fpga-theremin/sensors/README.md

# sensors
Implementation of Analog Front End for digital theremin sensor
