fpga-theremin/sensors/fpga_sensor/firmware/README.md

FPGA based current sensing theremin sensor - FPGA firmware
==========================================================

* hdl - RTL verilog code
* tb - test code

Firmware Block Diagram - RF part
