fpga-theremin/sensors/fpga_sensor/research/README.md

Some research notes on Theremin Sensor design
=============================================

Phase shift detection
---------------------

NCO (Numerically Controlled Oscillator) inside FPGA generates sine wave DRIVE signal to drive LC tank (converted from digital form to analog by DAC). 

Current flowing through LC tank is being measured by measurement of voltage dropped on R_sense resistor. 
LC current SENSE signal is being converted to digital form by ADC, and going back to FPGA for processing.

When DRIVE signal frequency is matching resonance frequency of LC tank, DRIVE and SENSE signals are in phase (have zero phase shift).
Due to change antenna capacitance C, resonance frequency of LC tank changes by sqrt(C).
When frequency of DRIVE is a bit bigger or lower than LC resonance frequency, phase of SENSE signal gets some offset - coming slightly before or after DRIVE.
When difference of DRIVE frequency from resonance getting bigger, phase shift increases.

When sensor see non-zero phase shift, it should correct DRIVE frequency to return phase shift back to zero - keeping DRIVE frequency as close to LC resonance as possible. 
This behavior is called Phase Locked Loop (in our case - Digital Phase Locked Loop - DPLL).

So, we need to find some method to calculate phase shift between known NCO phase and SENSE signal value from ADC.

To find phase difference between two sine signals of the same frequency we may multiply two sines of frequency f and get sine of doubled frequency 2 * f and constant (DC, zero frequency) component corresponding to sin(shift).

    sin(phase*f) * k * sin(phase*f + shift) = sin(phase * 2 * f) + k * sin(shift)

DC value sin(shift) is scaled by unknown value - amplitude of current sensed by ADC. So, one having k * sin(shift) is not enough to calculate exact phase shift value.

If we multiply signal of unknown phase by two sines shifted by 90 degrees, DC components of two products will give sin(shift) and cos(shift) which can easy be transformed to phsae shift angle by using of atan2(dc_sin,dc_cos).
As well, atan2() is not sensitive to scaling of ADC value, so having different amplitude of sensed signal is not more a stopper for precision phase shift measurement.

    sin(phase*f) * k * sin(phase*f + shift) = sin(phase*2*f) + k * sin(shift)
    cos(phase*f) * k * sin(phase*f + shift) = sin(phase*2*f) + k * cos(shift)

We need some method to filter out double frequency component from results of multiplication and leave only DC part - sin(shift) and cos(shift).

Simple method is to use some lowpass filter. But it adds latency. Let's try to find some way for getting precise phase offset during time shorter than one signal period.

Let's try to simulate quadrature phase detector in spreadsheet.
Put formulas for producing samples for NCO_SIN and NCO_COS signals of amplitude 1.0, and simulated ADC signal (which is the same as NCO COS, but with reduced amplitude 0.8 and shifted by phase offset 

    ADC=NCO_COS(phase-offset)) * 0.8

Then we can multiply NCO SIN and NCO COS by ADC signal - to get SIN_MUL_ADC and COS_MUL_ADC.
Formulas use parameters like phase shift, ADC amplitude, ADC DC offset and Sample Rate to Signal Frequency Rate.

Let's create chart using 21 points with X = cos, Y = sin.
Additionally let's show ADC with a bit different amplitude (0.9 instead of real 0.8) - for visibility.

Phase offset is 0 (ADC signal equals to NCO COS, but with amplitude 0.8).

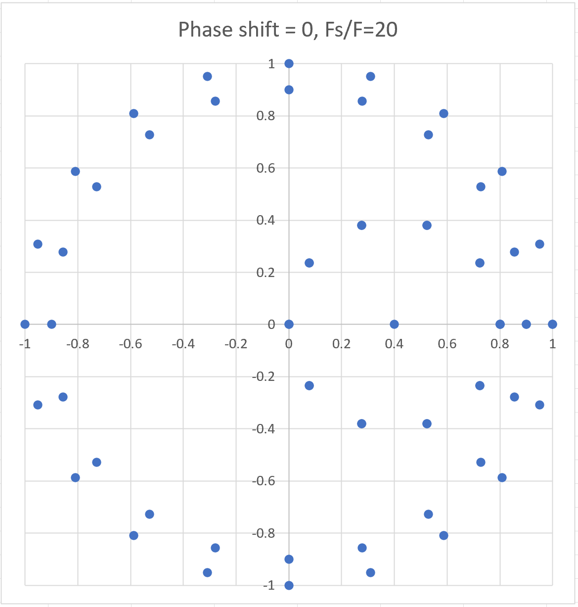
[picture p6: fpga_sensor/images/phase_shift_detection_chart1.png]
Phase shift 0


* Outer circle of radius 1.0 is NCO signal. 
* Smaller circle of radius 0.9 is ADC.
* Small circle of radius 0.4 is ADC multiplied by NCO SIN and COS

Phase offset is 45 degrees.

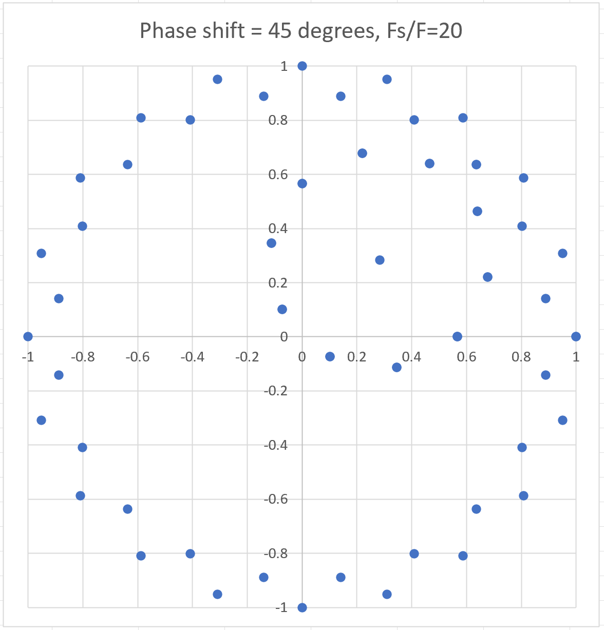
[picture p7: fpga_sensor/images/phase_shift_detection_chart2.png]
Phase shift +45


Phase offset is 120 degrees.

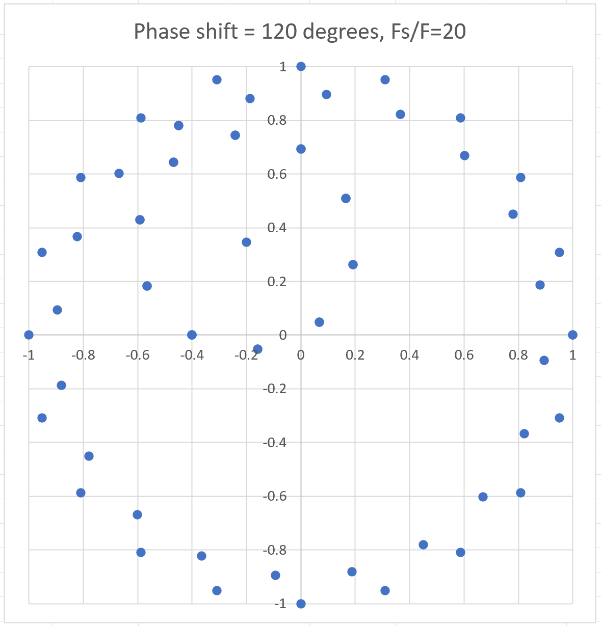
[picture p8: fpga_sensor/images/phase_shift_detection_chart3.png]
Phase shift +120


Phase offset is -30 degrees.

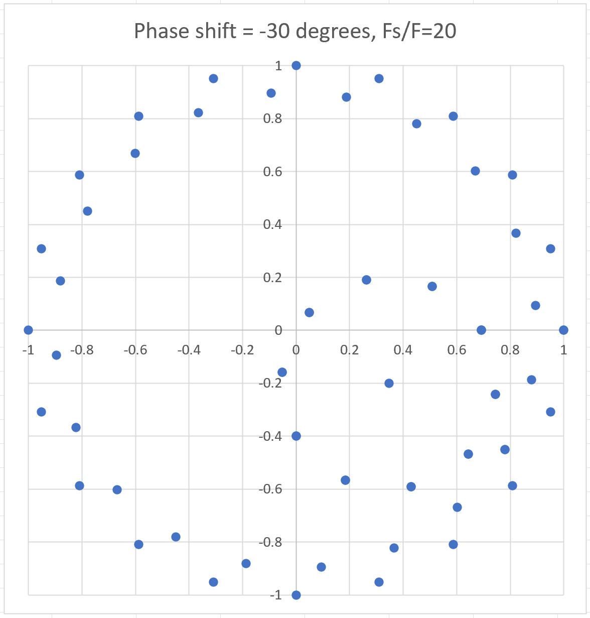
[picture p9: fpga_sensor/images/phase_shift_detection_chart4.png]
Phase shift -30


As we can see, angle between direction from (0,0) to small circle center and X axis equals to phase shift.

Small circle always passes through point (0,0)

If we know circle center coordinates (x,y), we can easy calculate phase shift using atan2:

    phase_shift_angle = atan2(x, y)

Center position of small circle may be obtained by averaging of coordinates of points on circle - LP filtering of them.

Interesting: if there is a DC offset in ADC signal, small circle turns into 2 circles - one smaller, and one bigger. 
Bus still direction to center of both of them corresponds to phase shift.

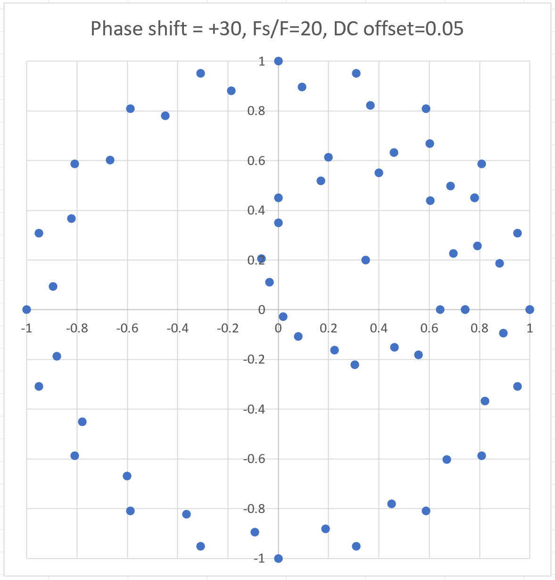
[picture p10: fpga_sensor/images/phase_shift_detection_chart6.png]
DC offset


Why there are only 10 points on small circle, while 20 points on big circle?

Let's increase F_sample/F rate to let points populate less than half of full period.

Now we can see that points on small circle rotate twice faster than on big circle - frequency of NCO * ADC product is 2 times higher than frequency of NCO.

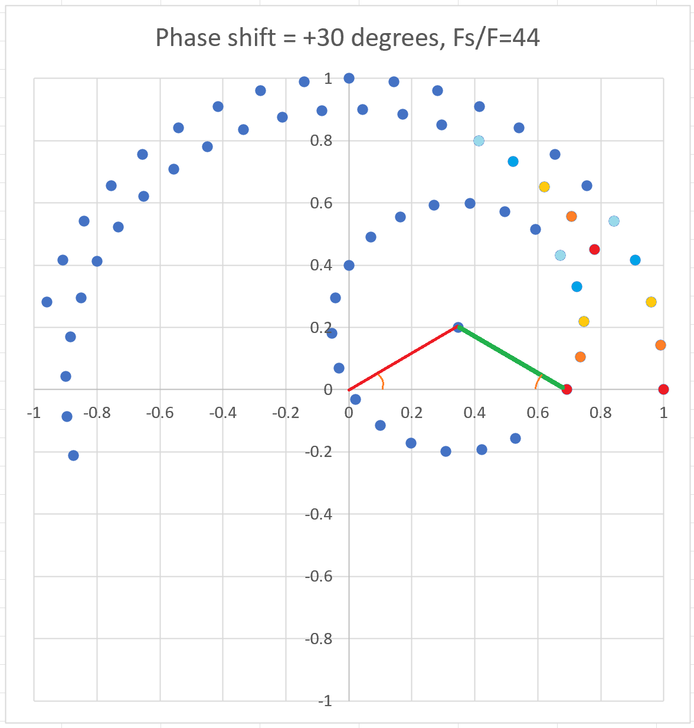
[picture p11: fpga_sensor/images/phase_shift_detection_chart5.png]
Phase shift 30 half of period


Note that direction from (0,0) to small circle center is the same as direction from circle center to zero phase point on this circle, but mirrored over X axis (angle has opposite sign when measure from X axis).

But there is only one such point. Can we calculate direction from (0,0) to small circle center from other points?

We just need to know phase of points on circle - and then from angle from circle center to particular point we can calculate angle to zero phase point just by subtracting of phase.
For each sample, it's easy to get small circle phase (angle between vector pointing from circle center to zero phase point and circle center to particular point on circle) - it's just doubled NCO phase.

For two points on circle we can easy calculate direction to the center of the circle - calculte vector of difference between two points and rotate by 90 degrees.

As phase for two points, average should be used.

To increase precision, it makes sense to use 2 points at some interval - by skipping several points between them to maximize distance.

To get phase shift without LP averaging - only using two samples - in addition to cos_mul_adc and sin_mul_adc values per sample, the only additional thing needed is to have NCO phase per sample.

Angle value from two samples already has only DC component. If ATAN2 is pipelined, it's easy to get angle once per sample, and further averaging should give you a very good performance even if averaged for short interval (even shorter than signal period).

This method should work ok for zero centered ADC output (without DC offset). What happens when we add some DC offset to ADC sine signal?

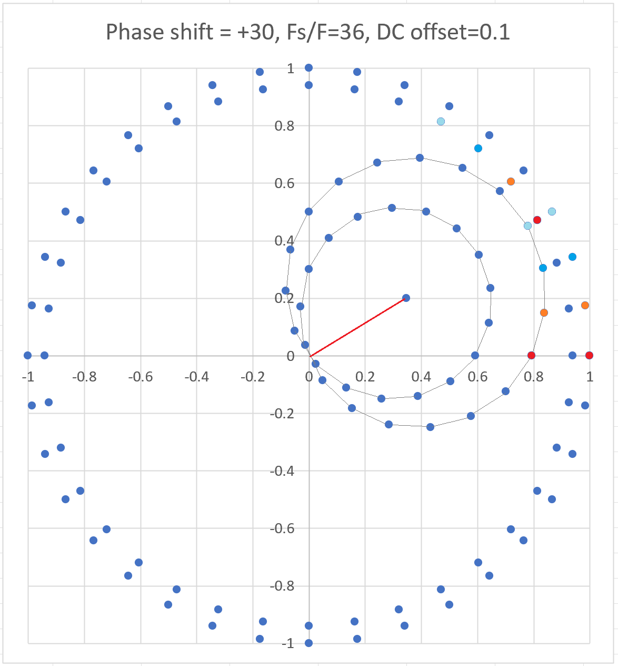
[picture p12: fpga_sensor/images/phase_shift_detection_chart7.png]
Phase shift 30 with DC offset


Let's try to calculate "circle center" for each point on curve considering point is laying on circle.

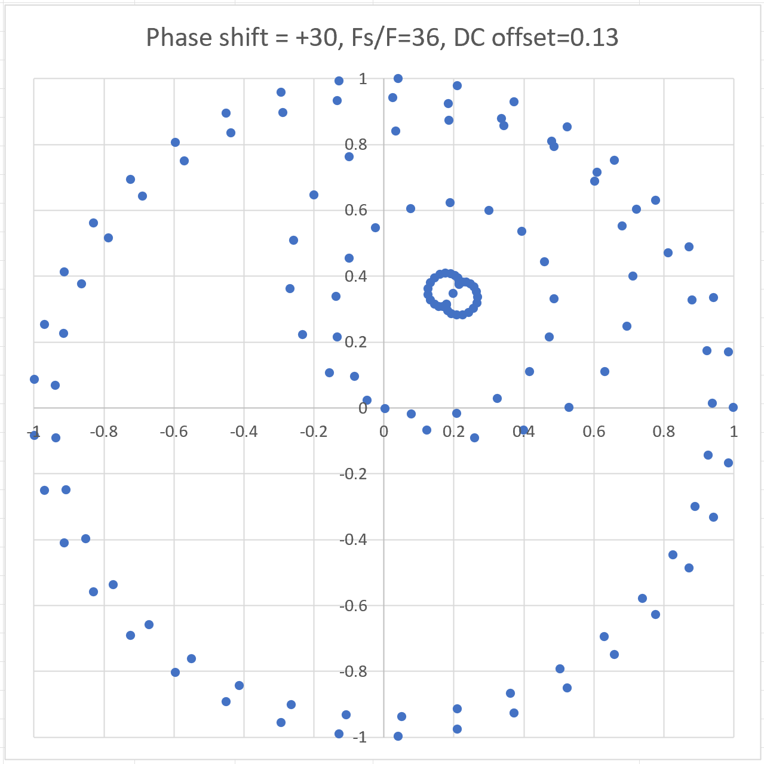
[picture p13: fpga_sensor/images/phase_shift_detection_chart8.png]
Circle center calculations


How angle from (0,0) to calculated "center" of curve changes during period for different DC offset.
(For DC=0 it's horizontal line).

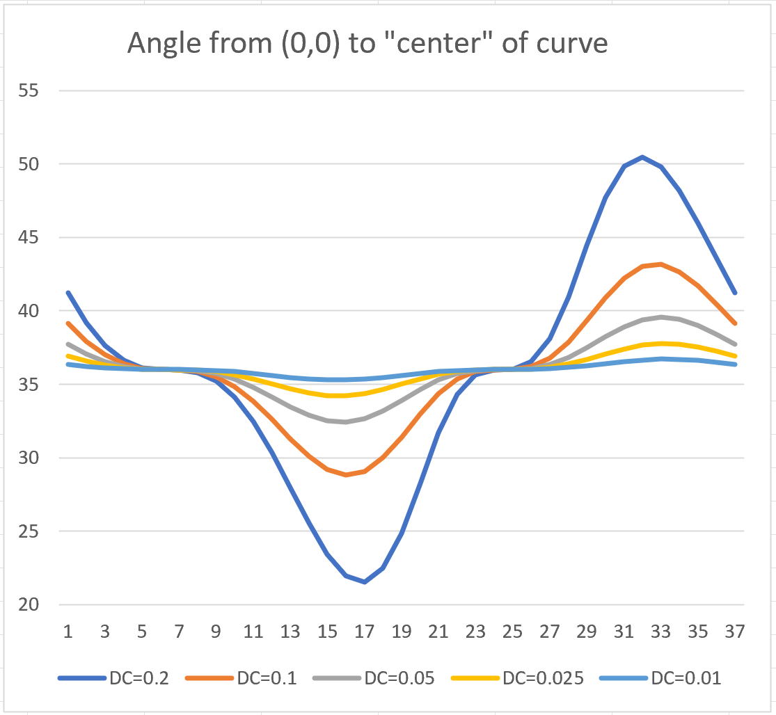
[picture p14: fpga_sensor/images/phase_shift_detection_chart9.png]
Angle to curve "center"


Let's try simplified method of phase shift calculation.
Take 3 points with equal phase step on x=adc*nco_cos, y=adc*nco_sin curve, phase2 is phase for middle point p2:

    pt1=(x1,y1) pt2=(x2,y2) pt3=(x3,y3)
    phase2 = nco_sin and nco_cos phase for point p2

Direction vector v13 from p1 to p3 is (x3-x1), (y3-y1)
Direction from point p2 to curve center vcenter is v13 rotated 90 degrees CCW 

    v13 = (x3-x1), (y3-y1)
    vcenter = ( -(y3-y1), (x3-x1) )

Angle from p2 to curve center can be calculated using atan2()

    acenter = atan2(vcenter.y, vcenter.x) = atan2( (x3-x1), -(y3-y1) )

Correcting acenter angle by doubled NCO phase of point2:

    angle = -(acenter + phase2)

Now we have phase shift angle. Comparison of two methods of angle calculation:

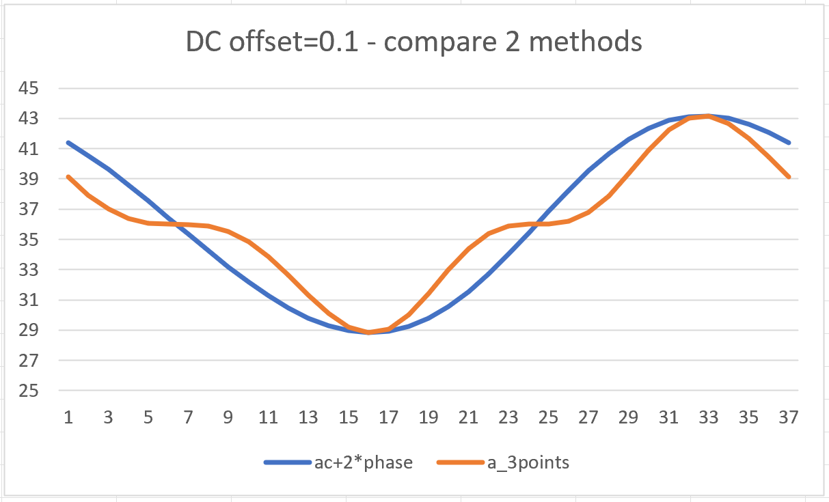
[picture p15: fpga_sensor/images/phase_shift_detection_chart10.png]
Comparision of two methods


Taking angle from direction from single curve point to center and correcting by doubled phase of NCO gives pure sine angle swing.
