fpga-theremin/sensors/models/ltspice/sensors_theory/README.md

Theremin sensors theory
=======================

In theremins, sound is being controlled by distance of hands from two "antennas" (rods or plates of metal).

Antenna is a common naming, but actually, Theremin antenna is working as an electrode of the capacitor. 

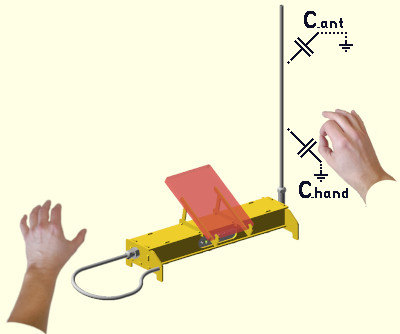
[picture p16: models/ltspice/sensors_theory/images/theremin_antennas_and_hands.jpg]
Theremin antennas and hands


* Pitch antenna controls sound frequency (note).
* Volume antenna controls gain.

Theremin should sense hand to antenna distances, and synthesize output signal of proper pitch and volume.

How can Theremin feel the distance? Distance of hand to antenna changes antenna capacitance.

Capacitance of antenna seen by theremin can be divided into fixed and variable parts.

* C_ant is antenna self capacitance and capacitance from antenna to environment which is considered as non changing

* C_hand is capacitance varying mostly depending on distance from hand to antenna

Typical C_ant value is about 8-10pF, depends on antenna geometry and placement of nearby objects.

Typically, C_hand part of capacitance is about 2pF when hand is close to antenna, and drops by 3.5 .. 4 times for each additional 10cm distance.

Table below shows how antenn capacitance introduced by hand position depends on distance from hand to antenna.

|=====|=====|=====|
|3.5/10cm decay|4/10cm decay|
|L, cm|C_hand, pF|C_hand, pF|
|=====|=====|=====|
|0|2.000000000|2.000000000|
|1|1.764506210|1.741101127|
|2|1.556741083|1.515716567|
|3|1.373439654|1.319507911|
|4|1.211721400|1.148698355|
|5|1.069044968|1.000000000|
|6|0.943168242|0.870550563|
|7|0.832113110|0.757858283|
|8|0.734134375|0.659753955|
|9|0.647692332|0.574349177|
|10|0.571428571|0.500000000|
|11|0.504144632|0.435275282|
|12|0.444783167|0.378929142|
|13|0.392411330|0.329876978|
|14|0.346206114|0.287174589|
|15|0.305441419|0.250000000|
|16|0.269476641|0.217637641|
|17|0.237746603|0.189464571|
|18|0.209752679|0.164938489|
|19|0.185054952|0.143587294|
|20|0.163265306|0.125000000|
|21|0.144041323|0.108818820|
|22|0.127080905|0.094732285|
|23|0.112117523|0.082469244|
|24|0.098916033|0.071793647|
|25|0.087268977|0.062500000|
|26|0.076993326|0.054409410|
|27|0.067927601|0.047366143|
|28|0.059929337|0.041234622|
|29|0.052872843|0.035896824|
|30|0.046647230|0.031250000|
|31|0.041154664|0.027204705|
|32|0.036308830|0.023683071|
|33|0.032033578|0.020617311|
|34|0.028261724|0.017948412|
|35|0.024933993|0.015625000|
|36|0.021998093|0.013602353|
|37|0.019407886|0.011841536|
|38|0.017122668|0.010308656|
|39|0.015106527|0.008974206|
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
