fpga-theremin/sensors/models/ltspice/vco_bjt/README.md

Wide frequency range Sine Outout VCO built mostly on BJTs
=========================================================

- Stable amplitude for wide range of output frequencies (100KHz .. 2MHz)

- Pure sine waveform output

- 4.5V power supply

LTSpice model: [vco_sine_bjt_v04.asc](vco_sine_bjt__v04.asc)
Spice model

Simulation, VCO output for frequency sweeping in full range: Simulation results
