fpga-theremin/sensors/models/ltspice/current_sensing_oscillator/README.md

Current Sensing LC Oscillator for Digital Theremin
==================================================

- Current sensing (Wallin) oscillator on 4-BJT dual current mirrors current sensor and unbuffered invertors
- Square 3.3V 50% duty cycle output for measuring of the frequency
- Antenna viltage swing 300 - 1000 Vpp depending on inductor parameters when powered from 3.3V

LTSpice model: [curr_sens_osc_v01.asc](curr_sens_osc_v01.asc)
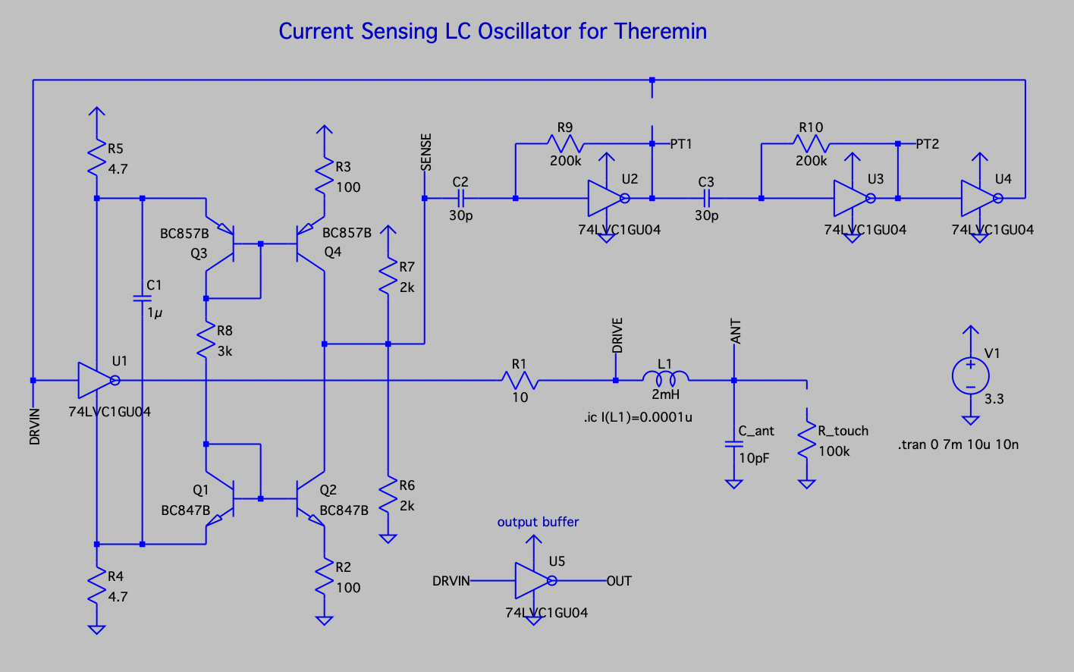
[picture p51: models/ltspice/current_sensing_oscillator/images/osc_v01_ltspice_model.png]
Spice model


* LC tank is fed by single unbuffered inverter
* Drive inverter has sensing resistors on both power supply rails
* Dual current mirror (4 BJTs) senses drive current
* R6, R7, R8 selected to have SENSE signal sine waveform amplitude below the power rails (1/2 or 1/3 of 3.3V)
* Three stages of unbuffered inverters amplify, shaping, and invert sensed signal
* Additional buffer for oscillator output, to avoid influence of long oscillator-to-MCU line

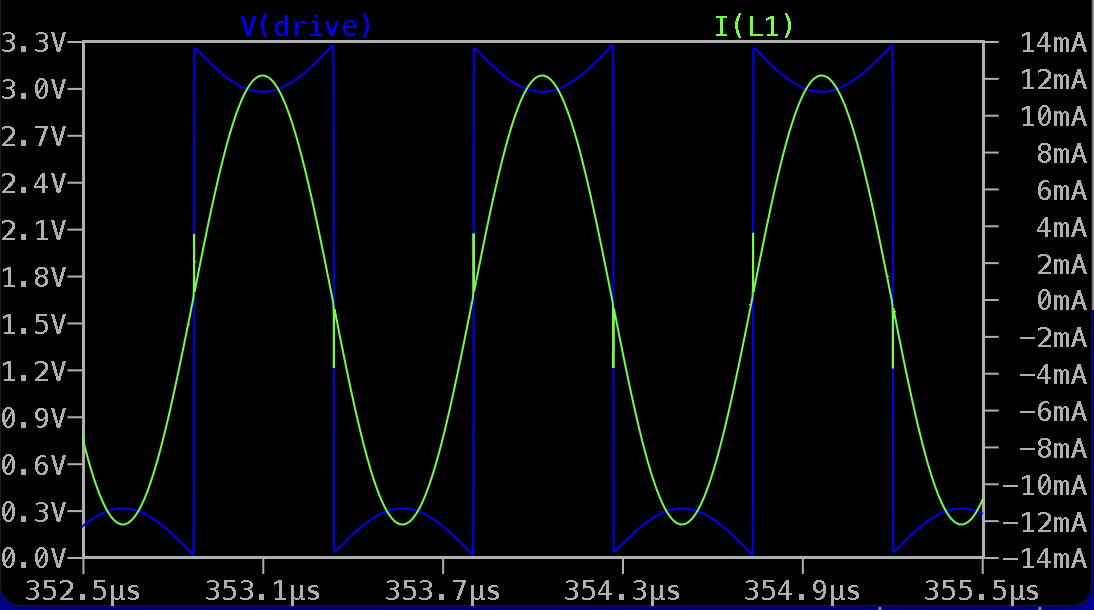
[picture p52: models/ltspice/current_sensing_oscillator/images/osc_v01_sim_drive_voltage_and_current.png]
Simulation, drive voltage waveform and inductor current: 

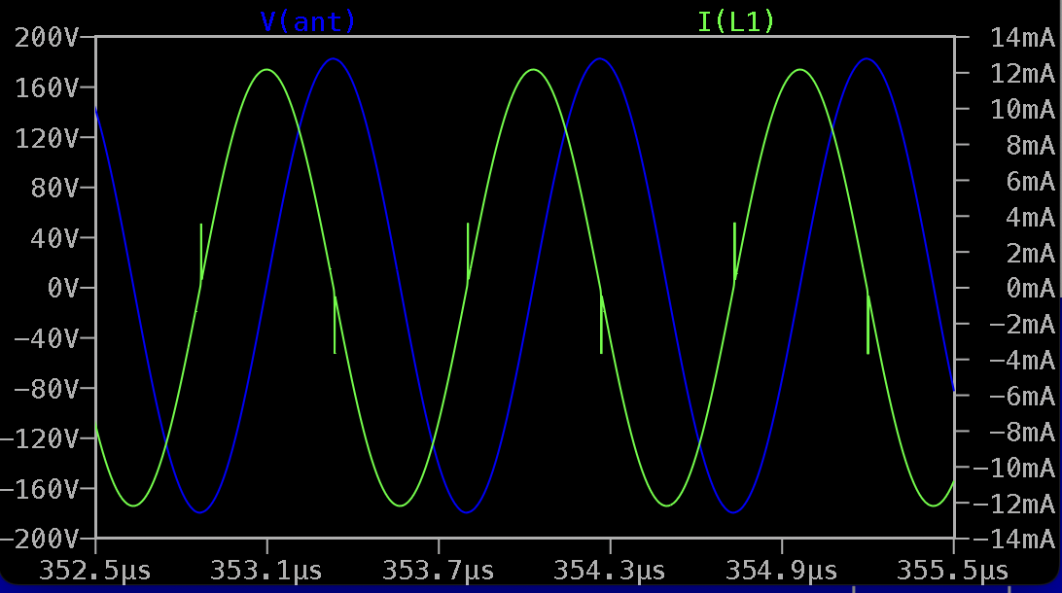
[picture p53: models/ltspice/current_sensing_oscillator/images/osc_v01_sim_ind_current_ant_voltage.png]
Simulation, inductor current and antenna voltage swing: 

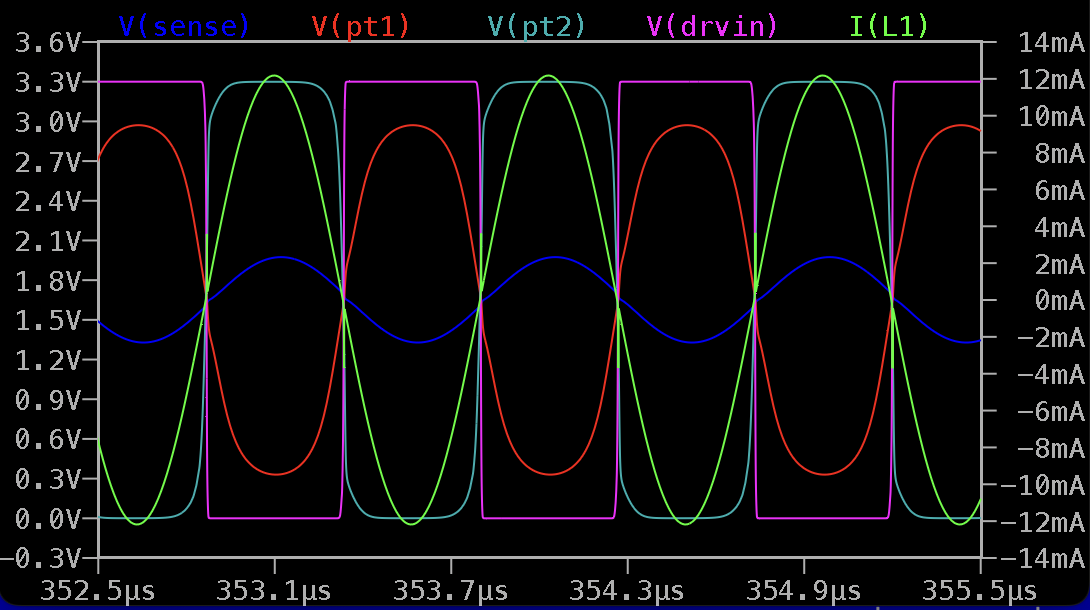
[picture p54: models/ltspice/current_sensing_oscillator/images/osc_v01_sim_current_sensing_amp.png]
Simulation, current sensing amplification stages:
