fpga-theremin/sensors/models/ltspice/vco_and_lc_drive/README.md

Wide frequency range Sine Outout VCO built mostly on BJTs with LC Tank Drive Buffer
===================================================================================

- Stable amplitude for wide range of output frequencies (100KHz .. 2MHz)

- Pure sine waveform output (40dB harmonics)

- 4.5V power supply

LTSpice model: [vco_and_lc_drive_v01.asc](vco_and_lc_drive_v01.asc)
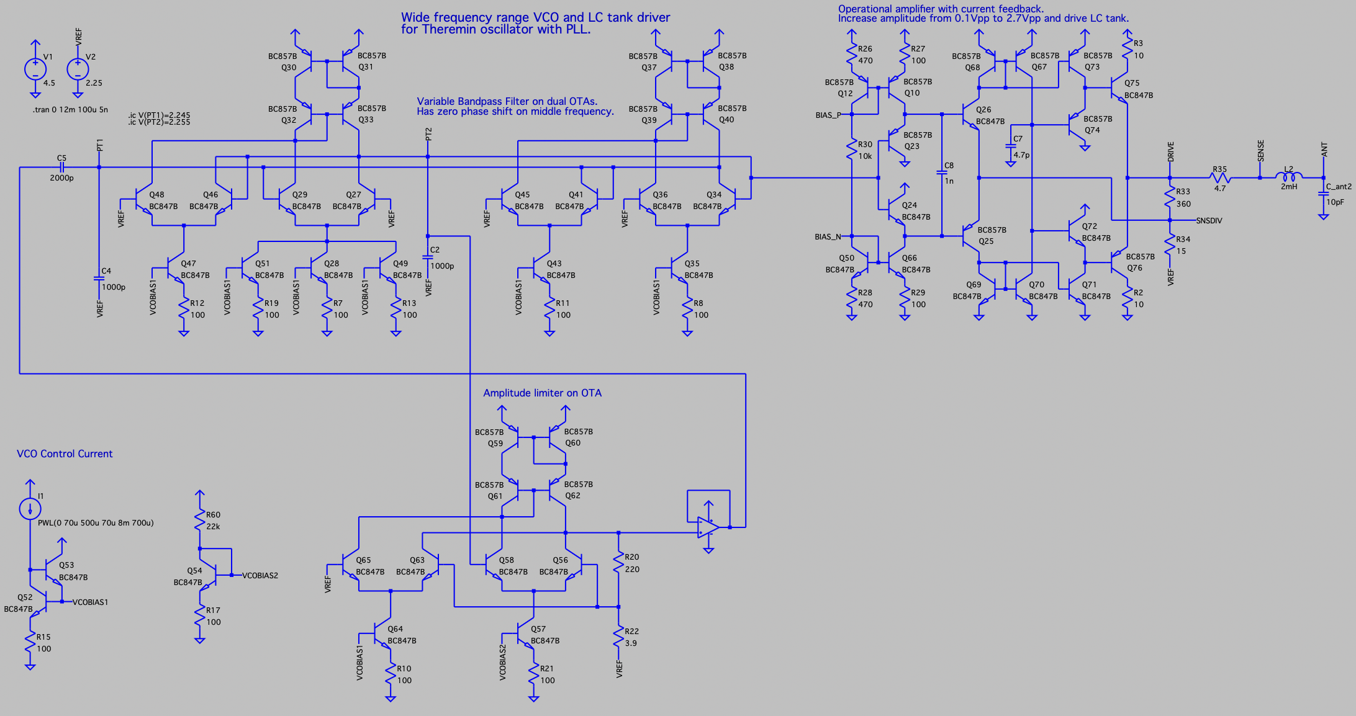
[picture p61: models/ltspice/vco_and_lc_drive/images/vco_and_drive_ltspice_model.png]
Spice model


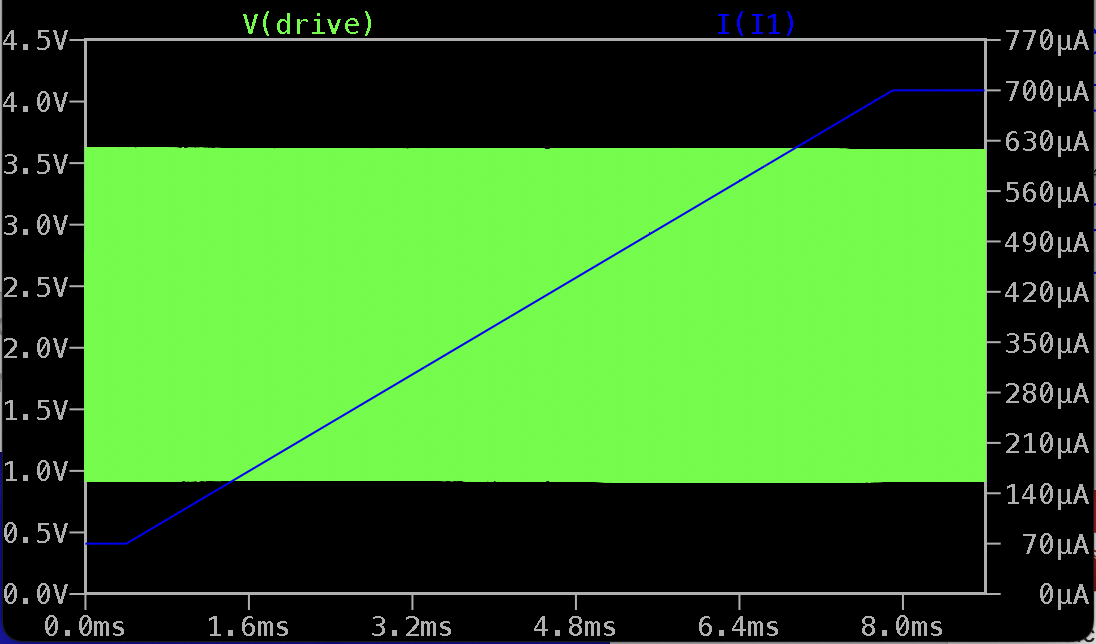
[picture p62: models/ltspice/vco_and_lc_drive/images/vco_drive_output_sim_result_waveform.png]
Simulation results
Simulation, VCO output for frequency sweeping in full range: 

Current sensing LC oscillator with PLL on BJTs for Theremins v2
===============================================================

* VCO and drive buffer - from previous step
* Current sensing via sensing resistor and current feedback opamp (made of BJT)
* Using integrator to shift drive signal by 90 degrees
* Using analog multiplier as phase detector

LTSpice model: [vco_and_lc_drive_v02.asc](vco_and_lc_drive_v02.asc)
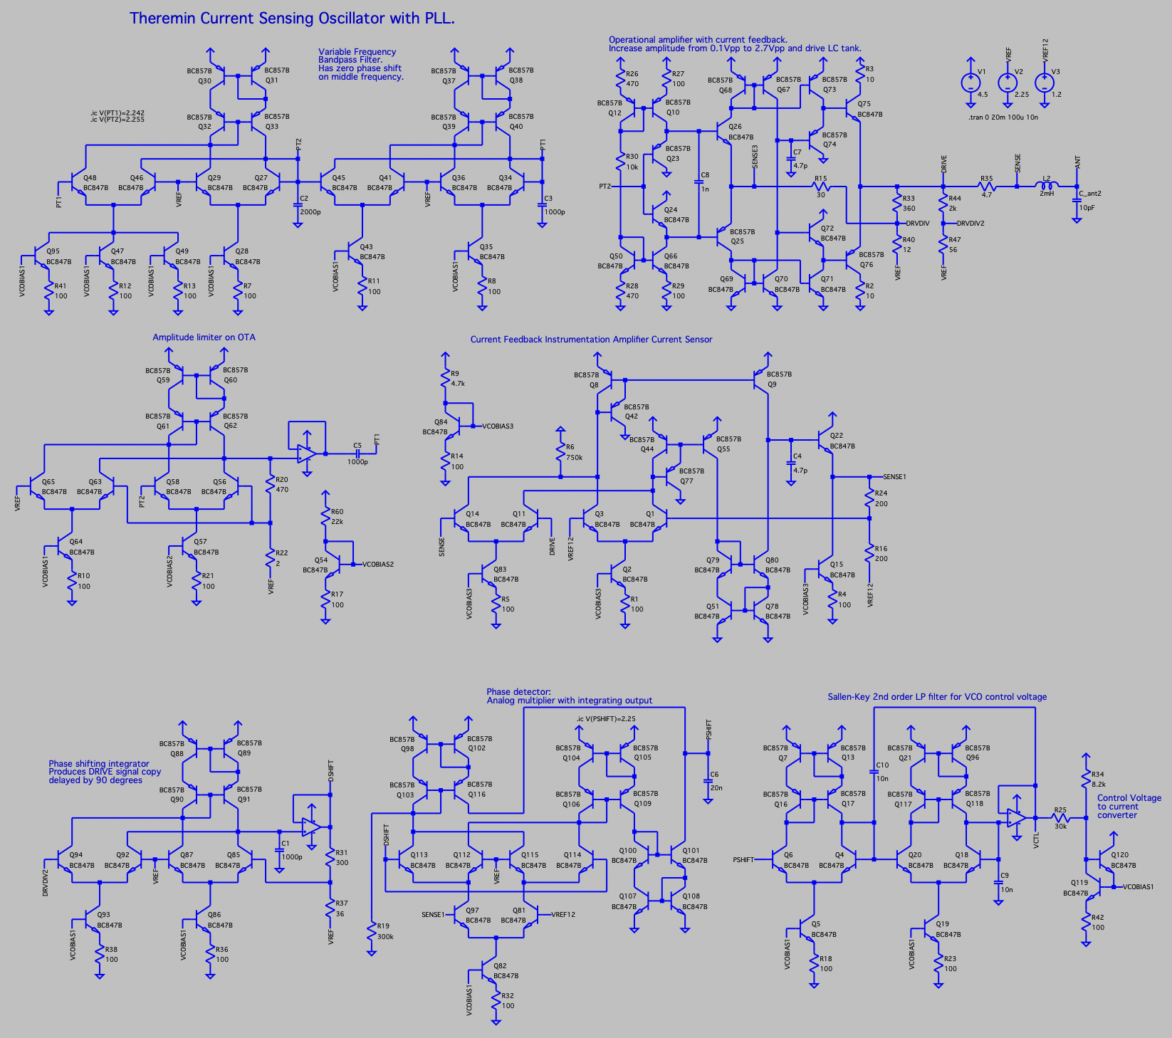
[picture p63: models/ltspice/vco_and_lc_drive/images/pll_current_sensing_oscillator_ltspice_model.png]
Spice model


Simulation results
------------------

PLL control voltage
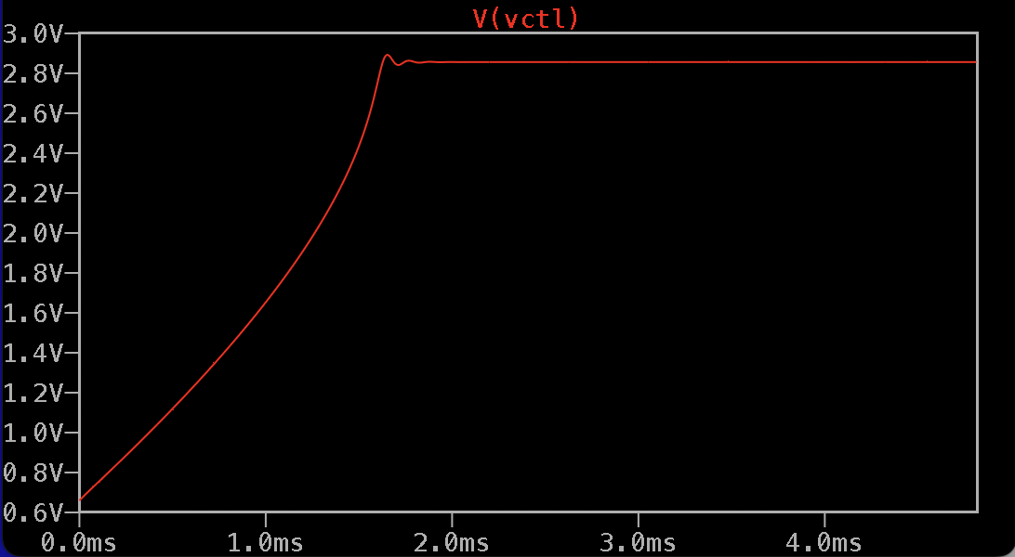
[picture p64: models/ltspice/vco_and_lc_drive/images/pll_sim_control_voltage.png]
Spice model


LC tank current
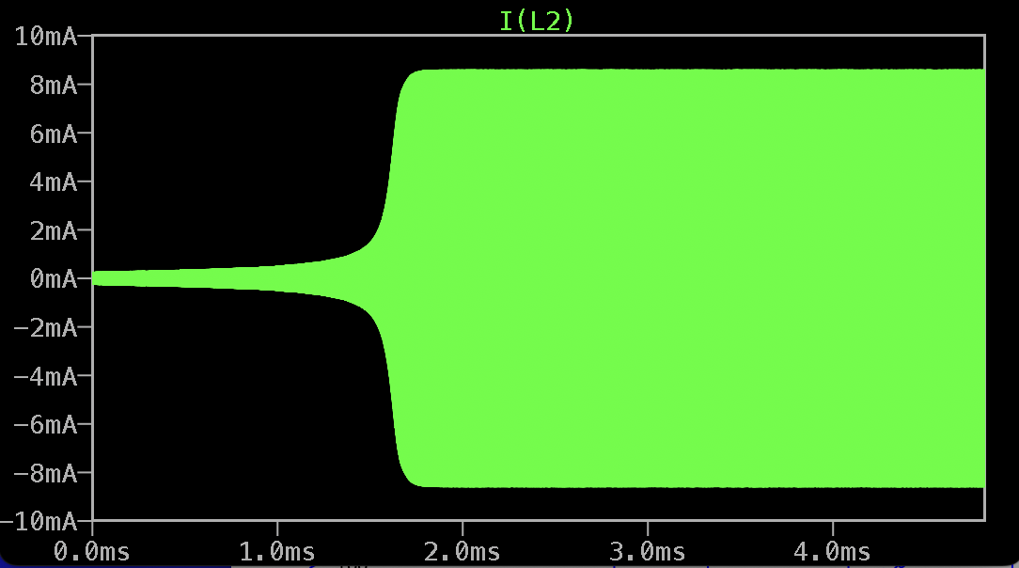
[picture p65: models/ltspice/vco_and_lc_drive/images/pll_sim_LC_current.png]
Spice model


Antenna voltage
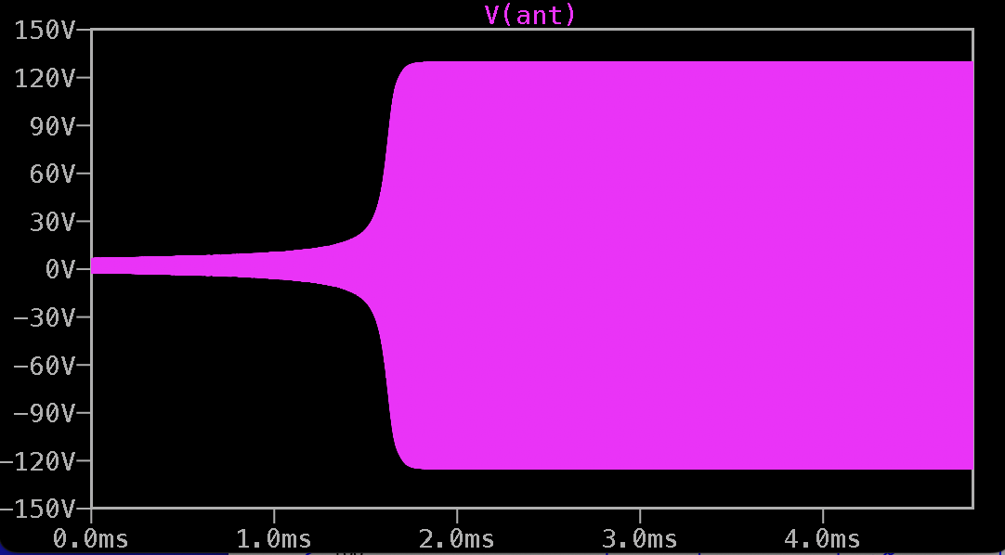
[picture p66: models/ltspice/vco_and_lc_drive/images/pll_sim_antenna_voltage.png]
Spice model


LC tank drive voltage and current in locked state
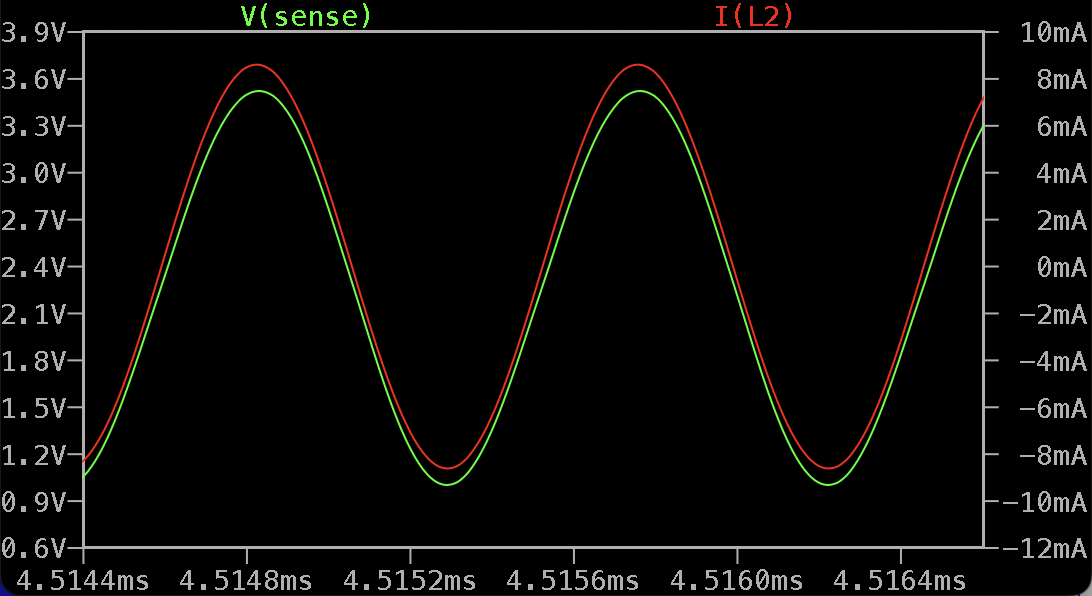
[picture p67: models/ltspice/vco_and_lc_drive/images/pll_sim_locked_LC_drive_voltage_and_current.png]
Spice model


Current sensing LC oscillator with PLL on BJTs for Theremins v3
===============================================================

Simplified version.

* Phase delay integrator moved from drive voltage signal to current sensing
* CV lowpass filter is removed

LTSpice model: [vco_and_lc_drive_v03.asc](vco_and_lc_drive_v03.asc)
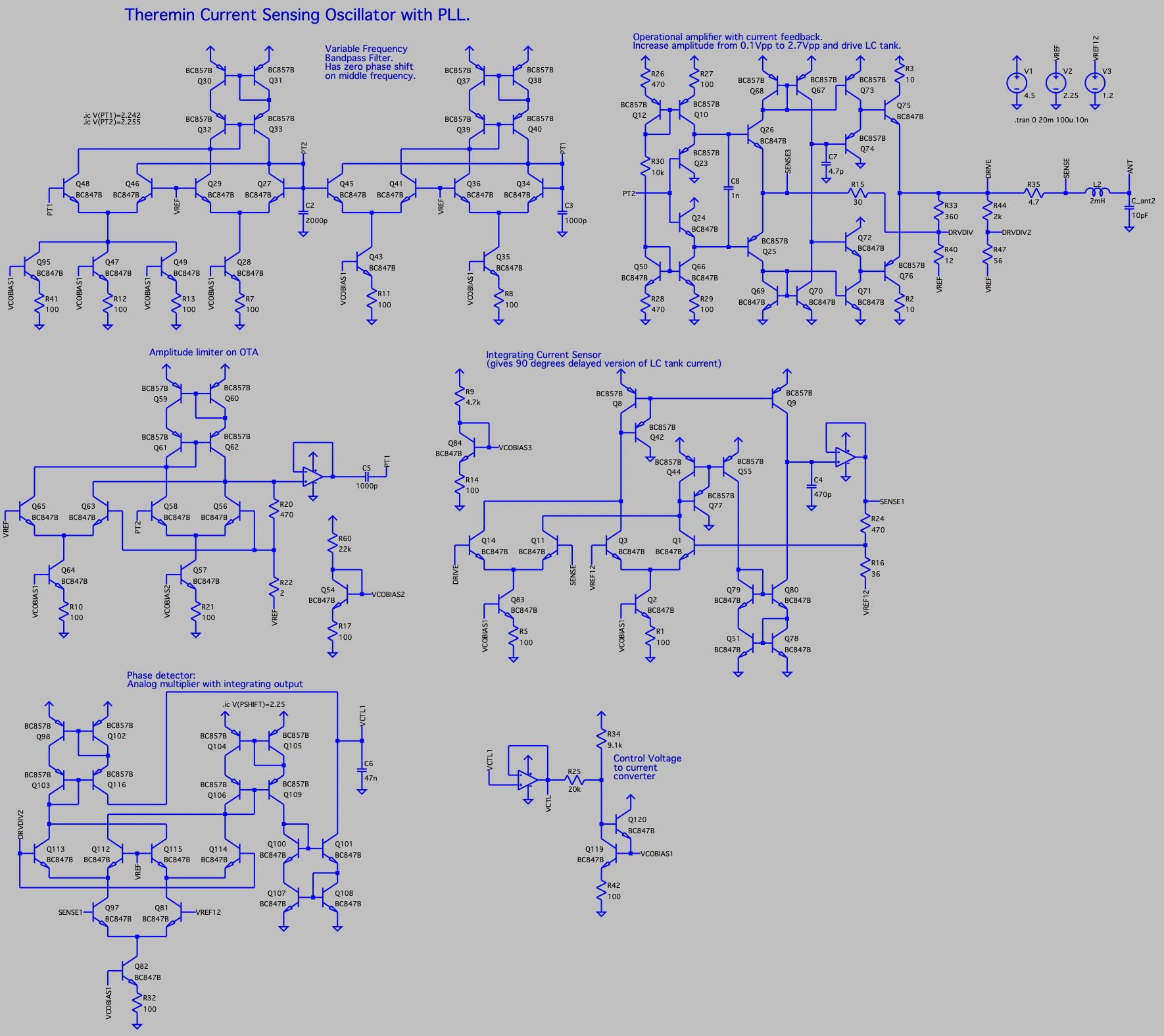
[picture p68: models/ltspice/vco_and_lc_drive/images/pll_v3_ltspice_model.png]
Spice model


Current sensing LC oscillator with PLL on BJTs for Theremins v4
===============================================================

Simplified version.

* Opamp as output buffer

LTSpice model: [vco_and_lc_drive_v04.asc](vco_and_lc_drive_v04.asc)
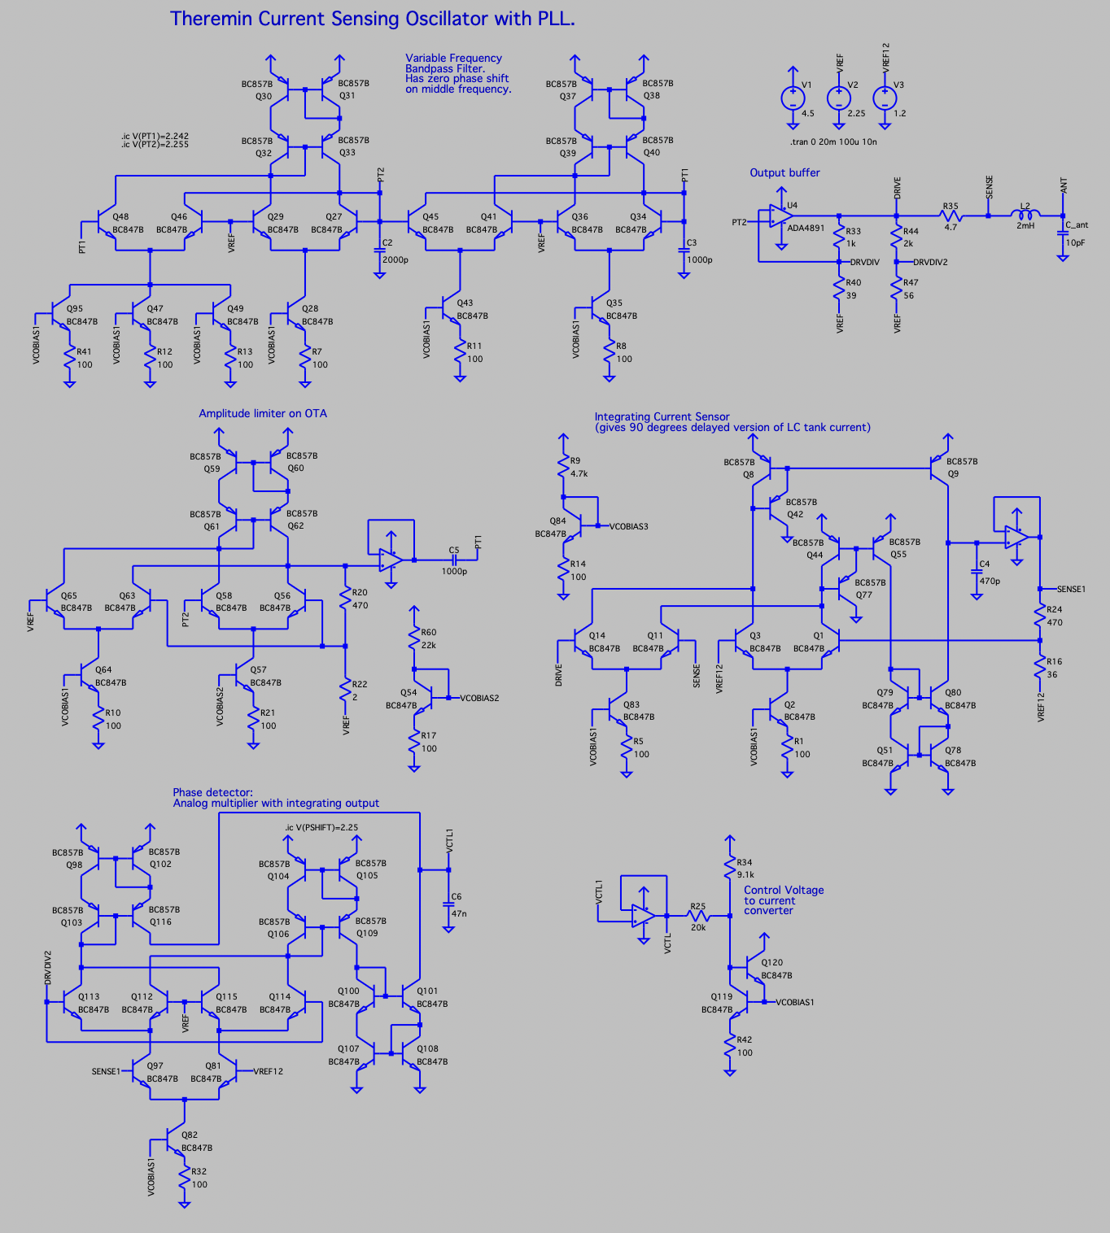
[picture p69: models/ltspice/vco_and_lc_drive/images/pll_v4_ltspice_model.png]
Spice model


Current Sensing Oscillator
==========================

LTSpice model: [current_sensing_osc_v01.asc](current_sensing_osc_v01.asc)
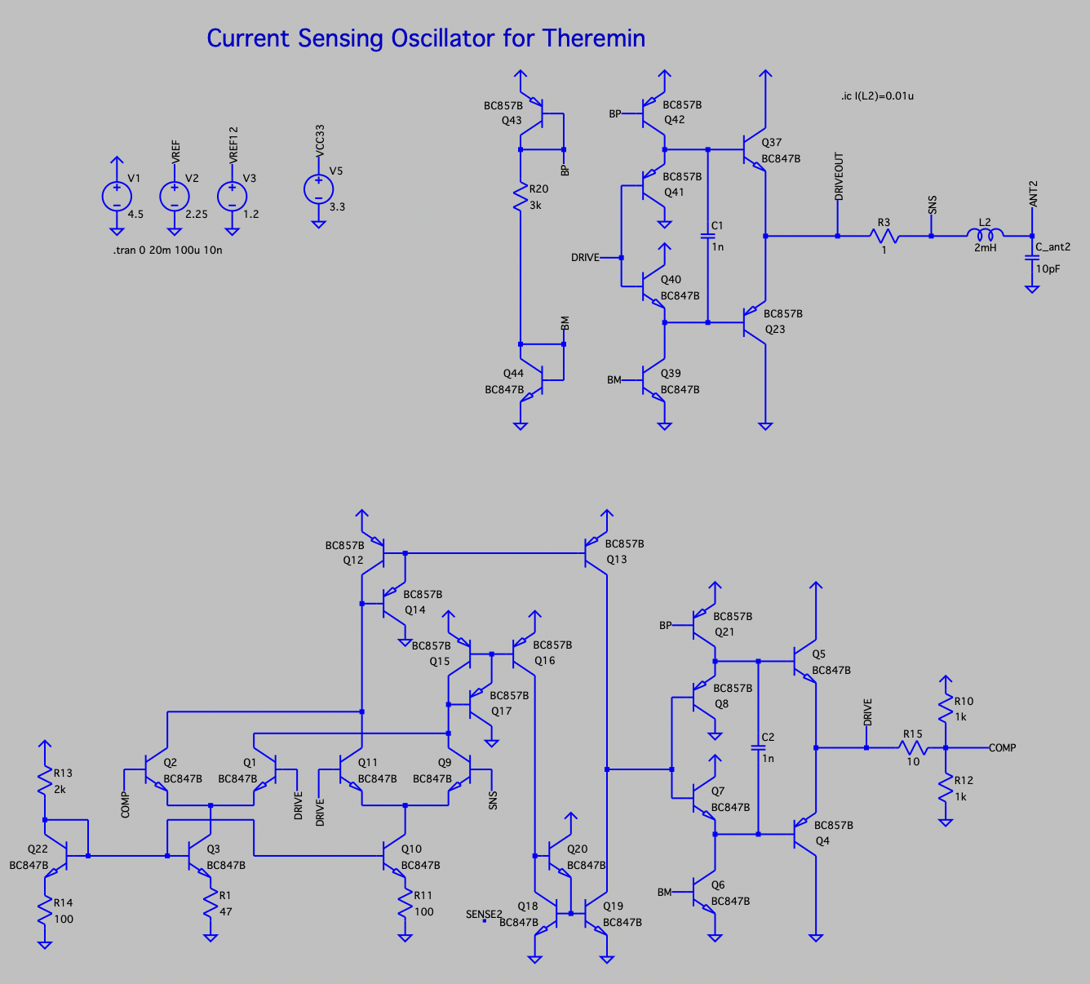
[picture p70: models/ltspice/vco_and_lc_drive/images/current_sensing_oscillator_ltspice_model_v01.png]
Spice model


Simulation results.

Drive voltage and current
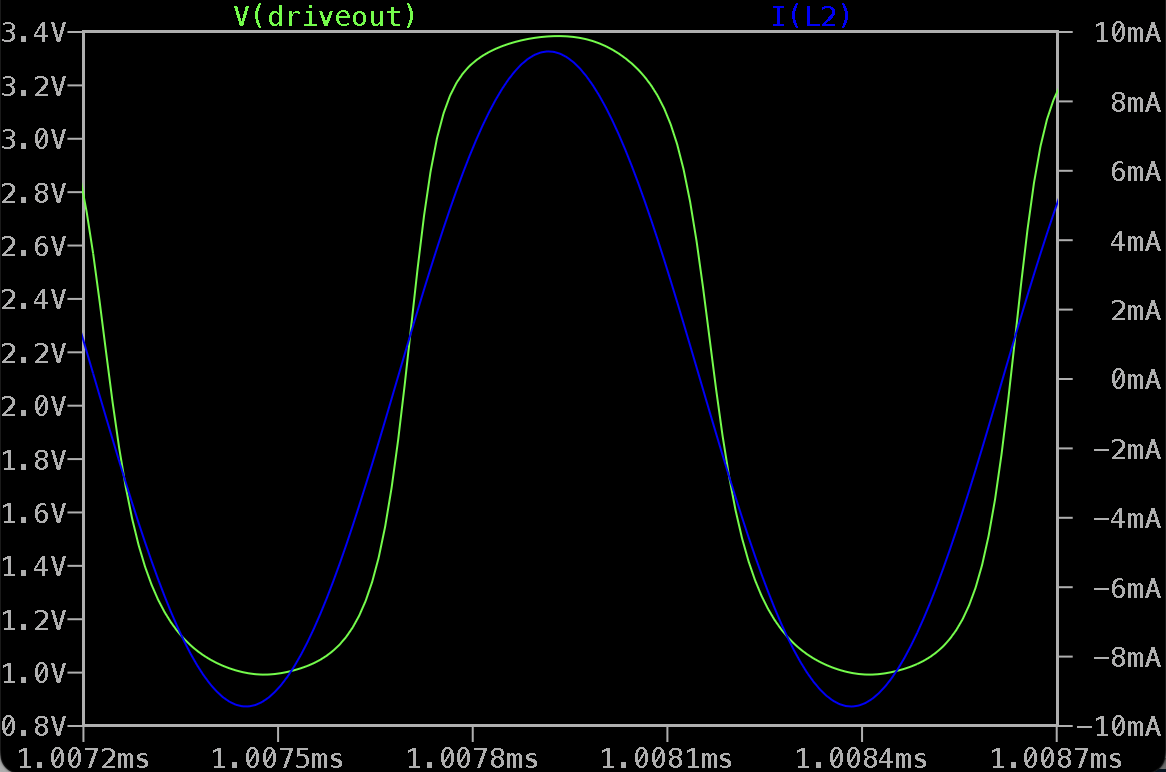
[picture p71: models/ltspice/vco_and_lc_drive/images/current_sensing_oscillator_v01_sim_drive_voltage_and_current.png]
Spice model


Antenna voltage and inductor current
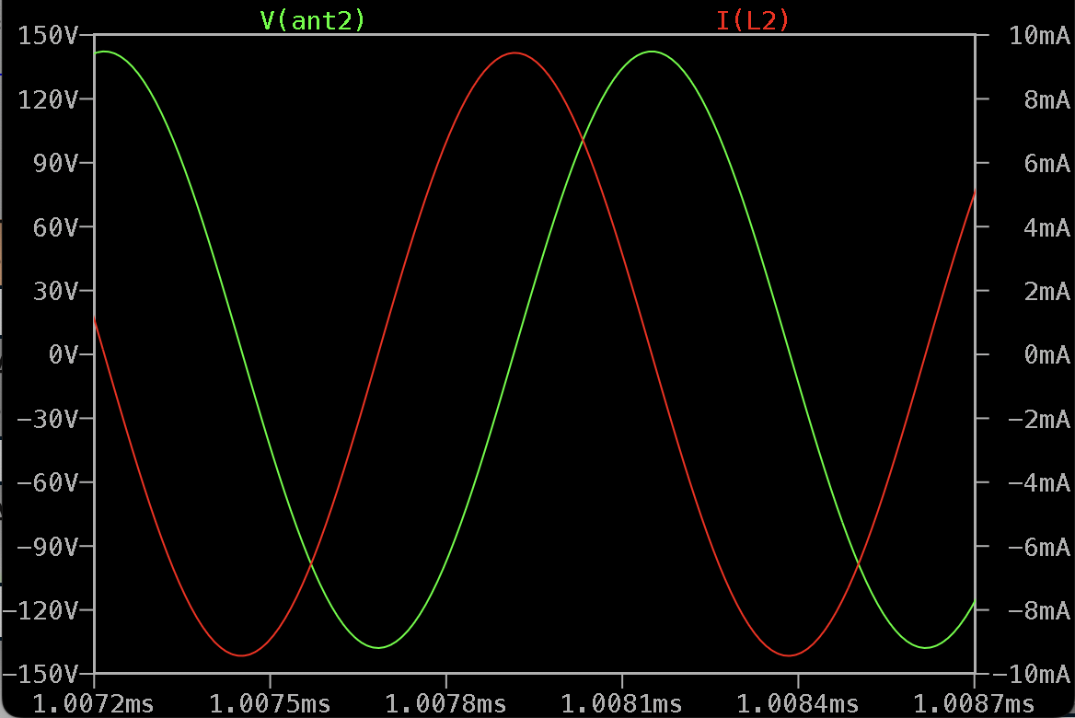
[picture p72: models/ltspice/vco_and_lc_drive/images/current_sensing_oscillator_v01_sim_inductor_current_and_antenna_voltage.png]
Spice model
