fpga-theremin/sensors/models/ltspice/current_sensing_afe_heterodyne/README.md

Current Sensing Theremin Oscillator With Heterodyne
===================================================

- Current sensing (Wallin) oscillator - produces drive signal in phase with inductor current.
- Clean sine wave drive signal (-50dB harmonics).
- Automatic gain control to keep drive signal at configured amplitude.
- May be adjusted for different parameters of inductor.
- For 2mH 120 Ohm inductor, draws about 40mA, giving 6mA 2Vpp for feeding of LC tank.
- 3.3V square input for reference frequency (expected to be a few KHz higher than oscillator frequency).
- Heterodyne produces pure sine wave audio range output.

LTSpice model: [current_sensing_osc_v14.asc](current_sensing_osc_v14.asc)
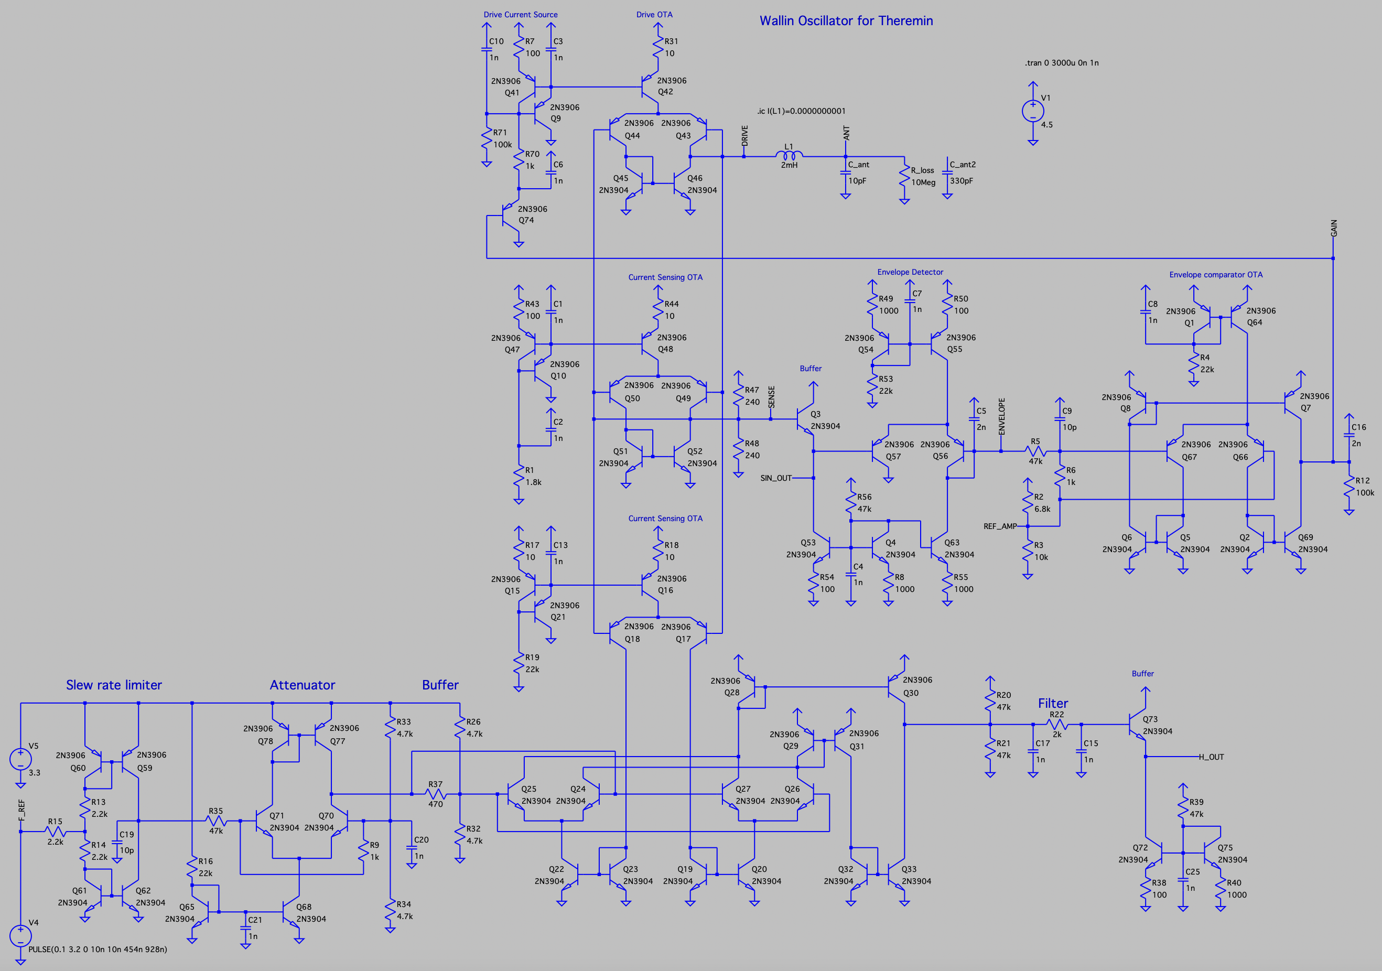
[picture p91: models/ltspice/current_sensing_afe_heterodyne/images/current_sensor_schematic.png]
Spice model


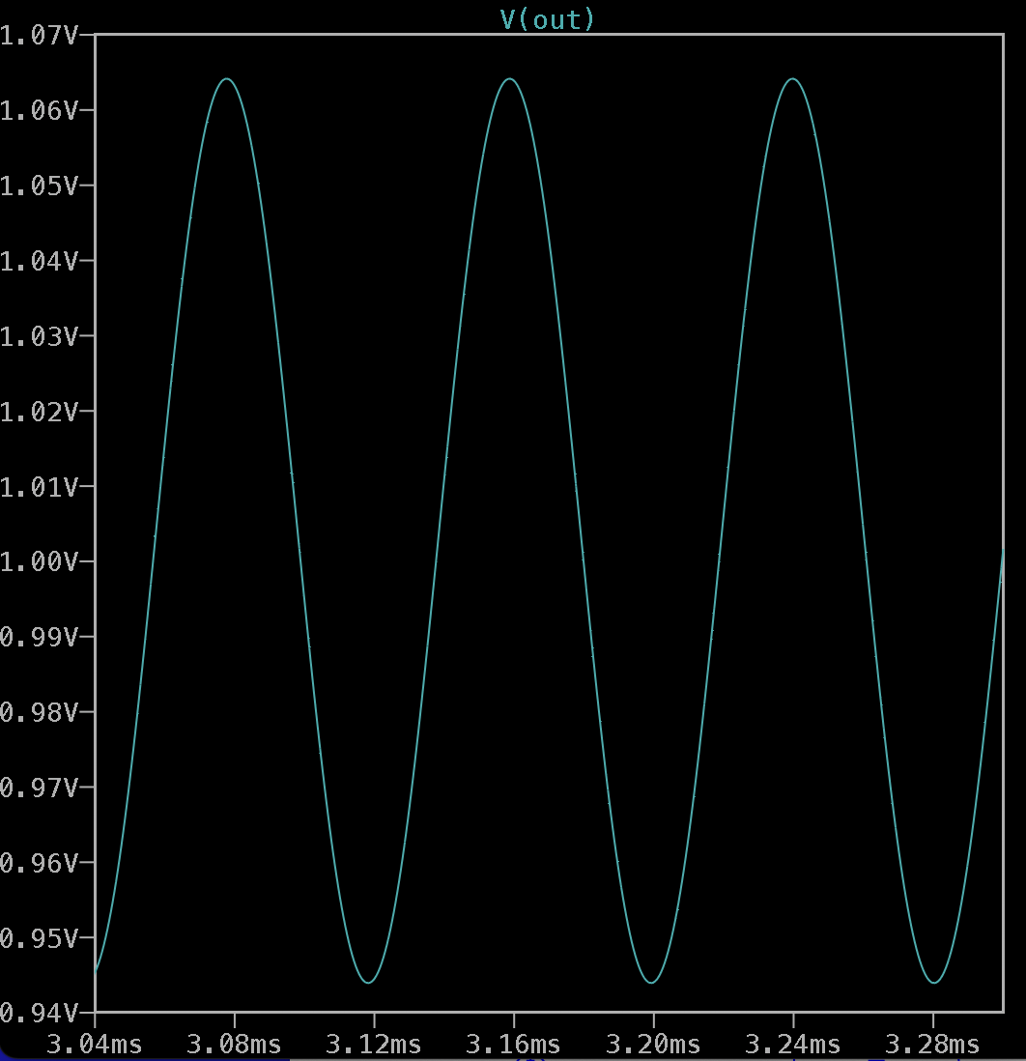
[picture p92: models/ltspice/current_sensing_afe_heterodyne/images/current_sensing_oscillator_heterodyne_output.png]
Simulation, heterodyne output: 

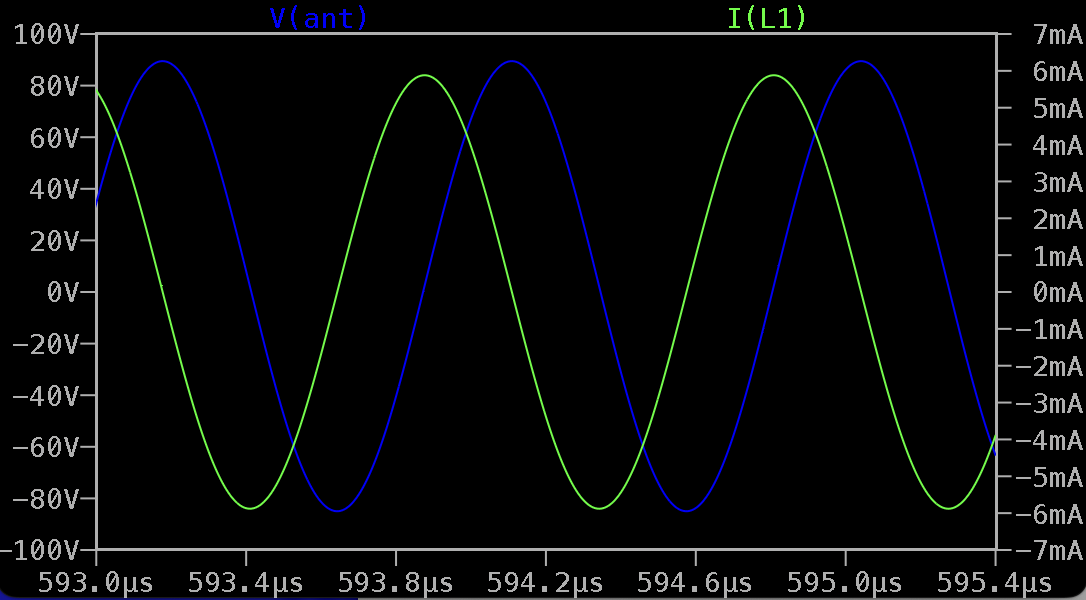
[picture p93: models/ltspice/current_sensing_afe_heterodyne/images/current_sensing_oscillator_inductor_current_and_antenna_voltage.png]
Simulation, inductor current and antenna voltage: 

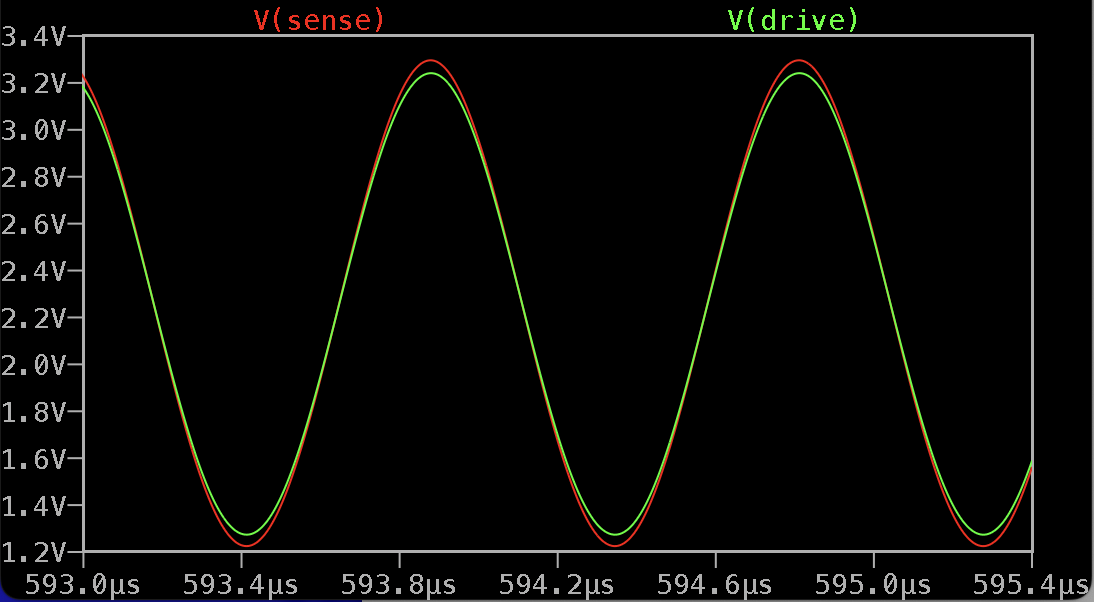
[picture p94: models/ltspice/current_sensing_afe_heterodyne/images/drive_and_sense.png]
Simulation, drive and sense signal:
