fpga-theremin/sensors/models/ltspice/sallen_key_shielded_afe/README.md

Sallen-key filter based shielded AFE
====================================

Simulation of shielded sallen-key LP filter based sensor [proposed by Eric Wallin](https://www.youtube.com/watch?v=ojJ5O-i3c0w), with BJT-based OTA as an amplifier.

LTSpice model: [2024_01_sallen_key_afe_v01.asc](2024_01_sallen_key_afe_v01.asc)

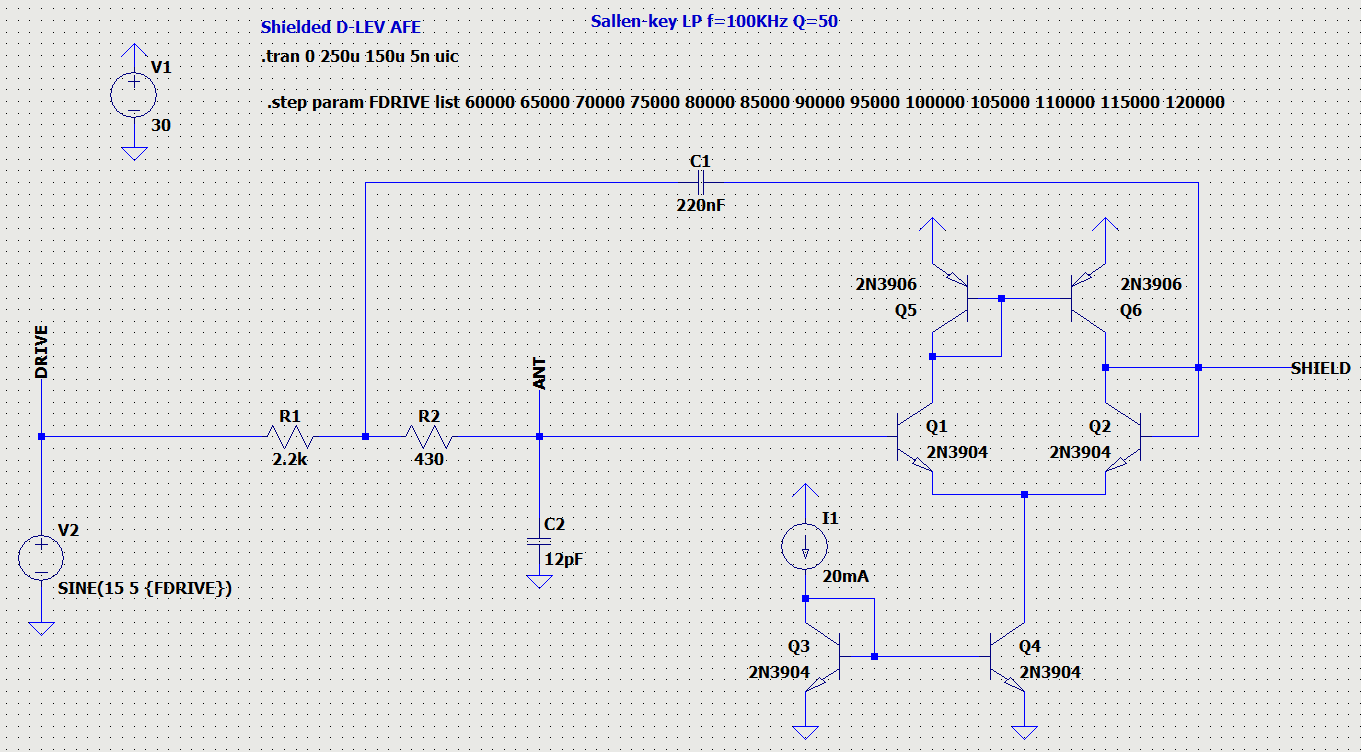
[picture p95: models/ltspice/sallen_key_shielded_afe/images/2024_01_sallen_key_afe_v01_ltspice_model.png]
Spice model


Simulation results: drive signal and voltage on antenna
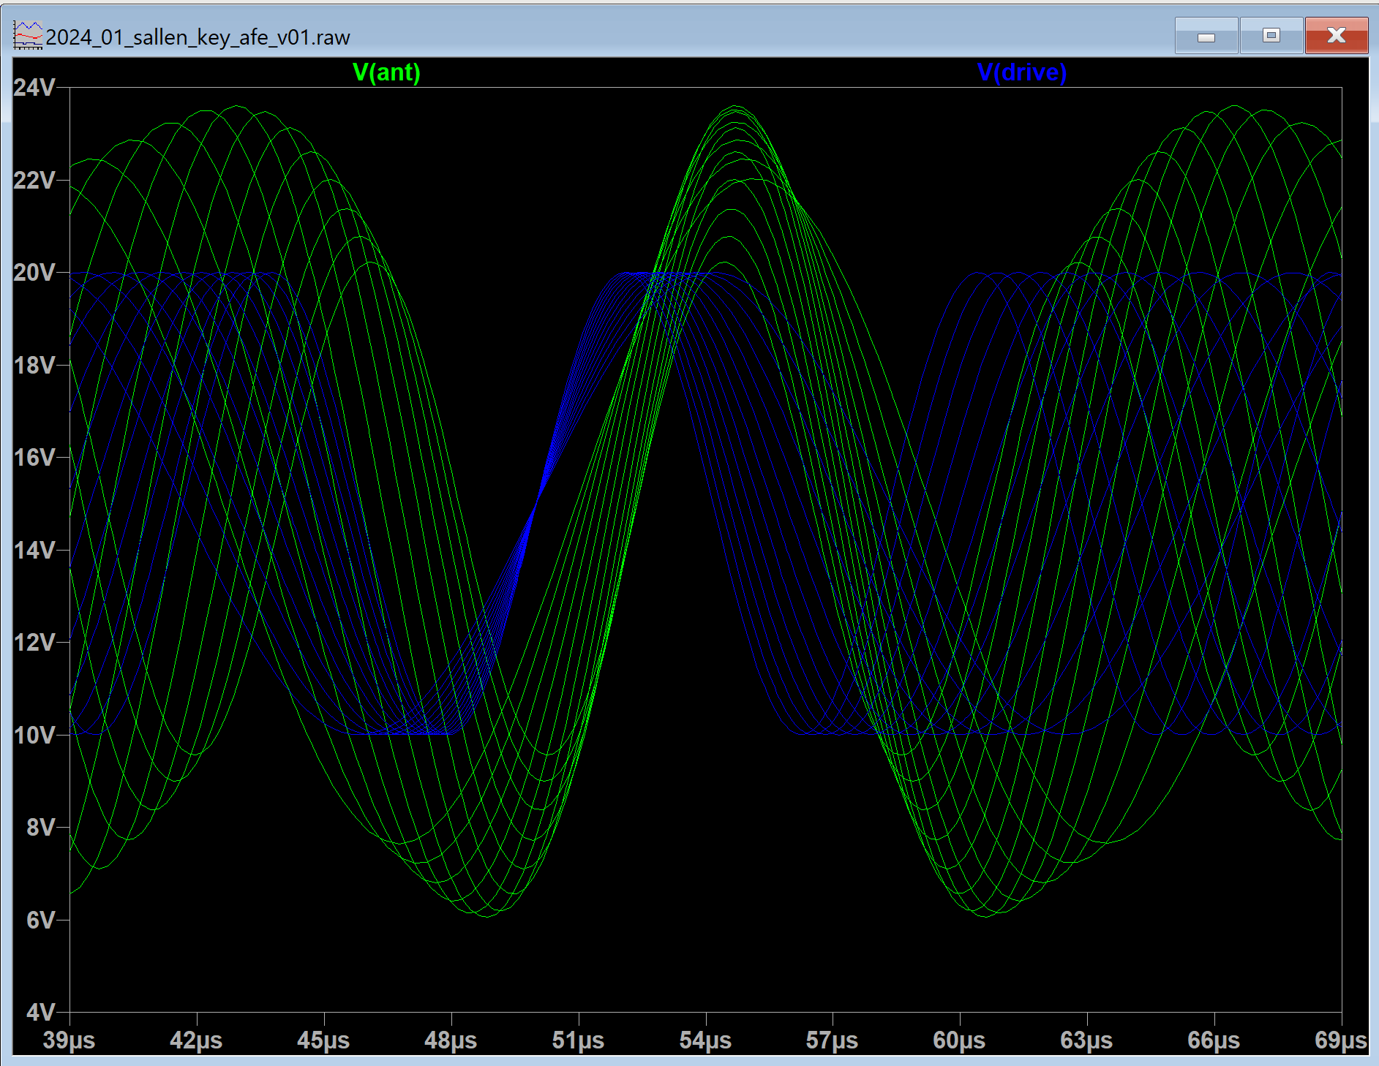
[picture p96: models/ltspice/sallen_key_shielded_afe/images/2024_01_sallen_key_afe_v01_simulation_results.png]


Using of better current mirror improves Q from 13 to 17.

Improved LTSpice models: [2024_01_sallen_key_afe_v04.asc](2024_01_sallen_key_afe_v04.asc)

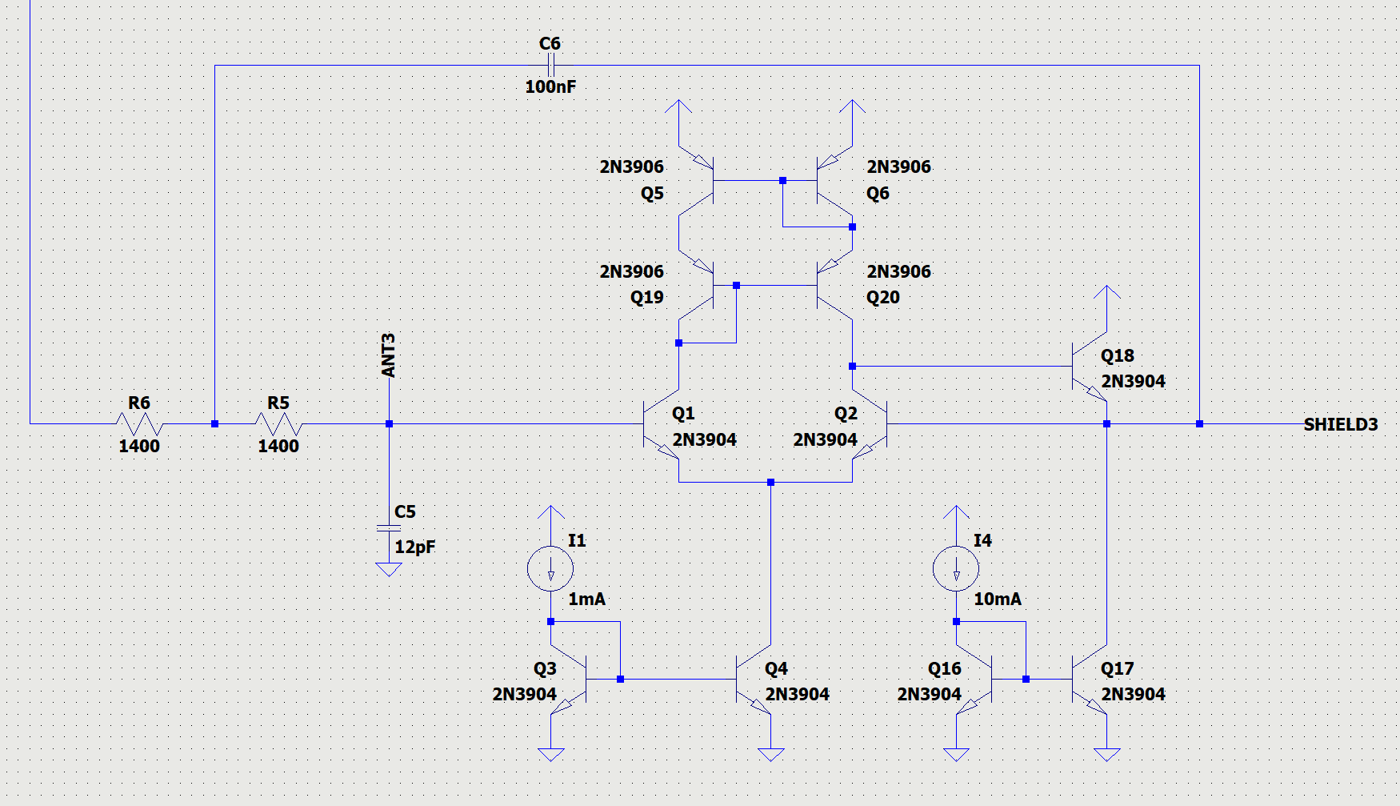
[picture p97: models/ltspice/sallen_key_shielded_afe/images/2024_01_sallen_key_afe_v04_ltspice_model.png]
Spice model


Simulation results: drive signal and voltage on antenna
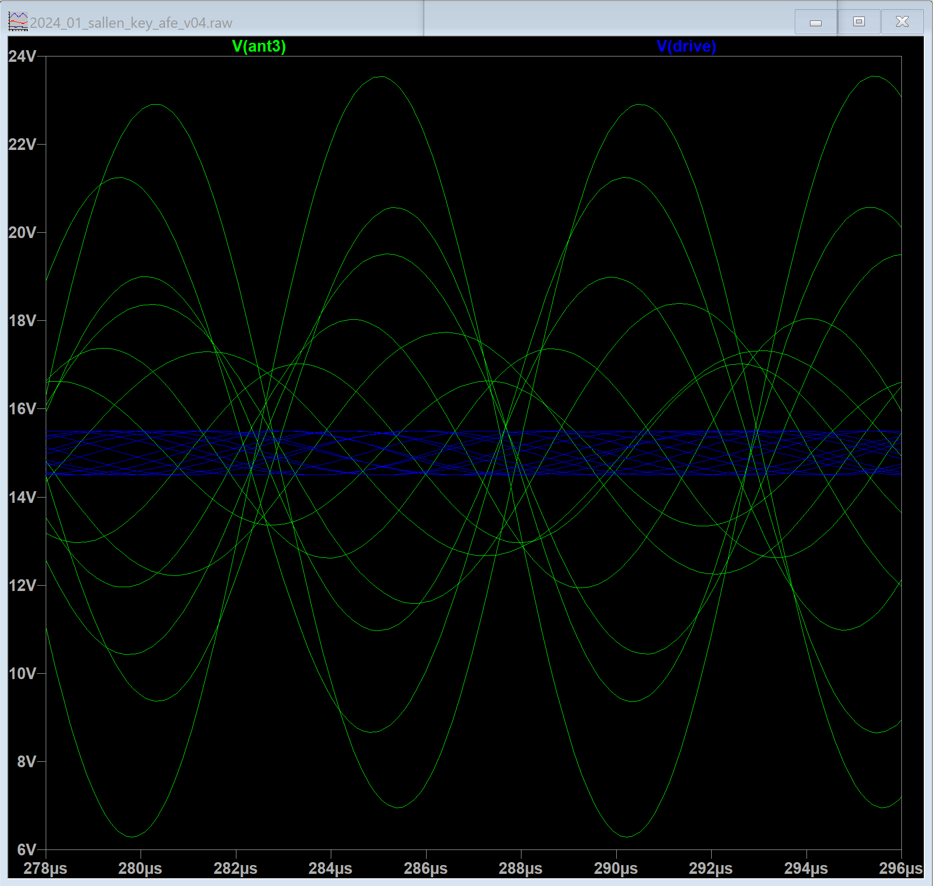
[picture p98: models/ltspice/sallen_key_shielded_afe/images/2024_01_sallen_key_afe_v04_simulation_results.png]
