fpga-theremin/sensors/models/ltspice/bjt_current_sensing_oscillator/README.md

Current sensing oscillator on single OTA.
=========================================

This directory contains a collection of current sensing oscillators intended for using in Theremin.

Simple single OTA current sensing oscillator
--------------------------------------------

LC tank current is being sensed as voltage on R_sense used to drive LC tank.

OTA amplifies R_sense voltage and provides its current output to drive LC tank.

R_sense value, OTA load resistor R1, and OTA current control I1 values should be tuned for particular inductor parameters.

LTSpice model: [bjt_current_sensing_oscillator_ota.asc](bjt_current_sensing_oscillator_ota.asc)

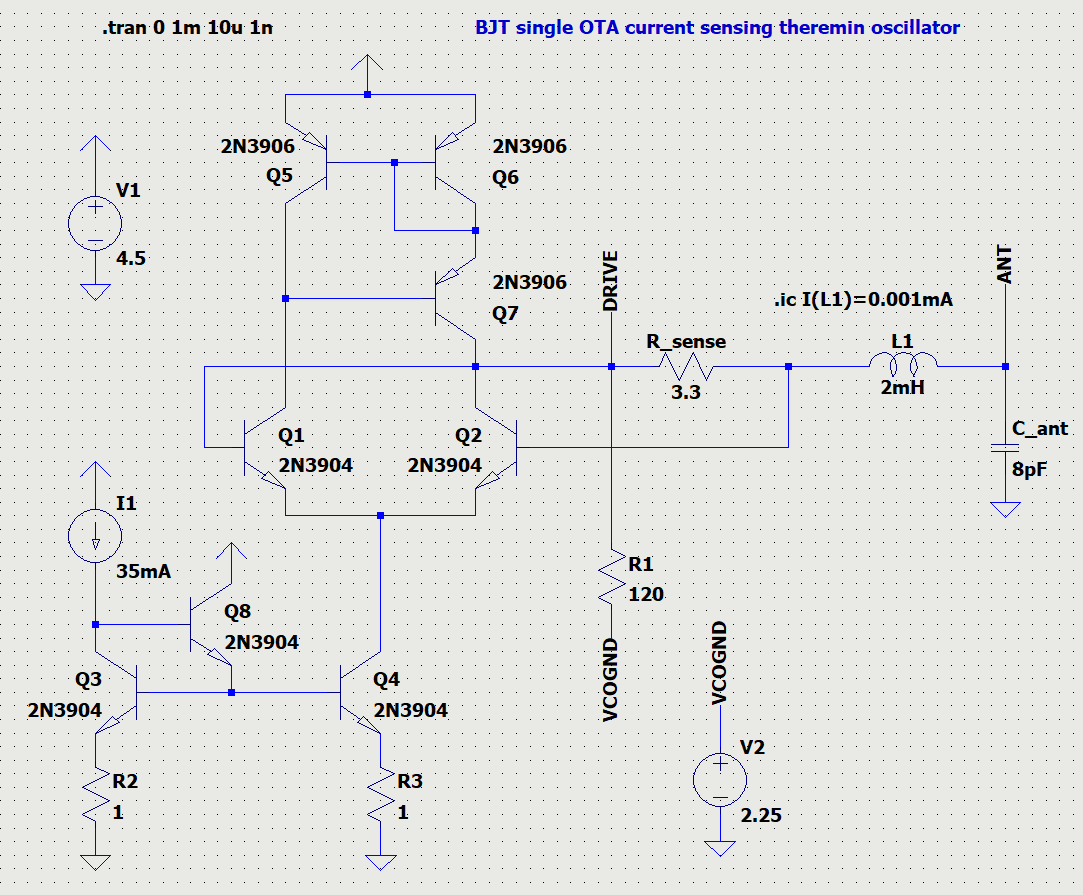
[picture p99: models/ltspice/bjt_current_sensing_oscillator/images/current_sensing_oscillator_ota_ltspice_model.png]
Spice model


Simulation results: drive signal and LC tank current
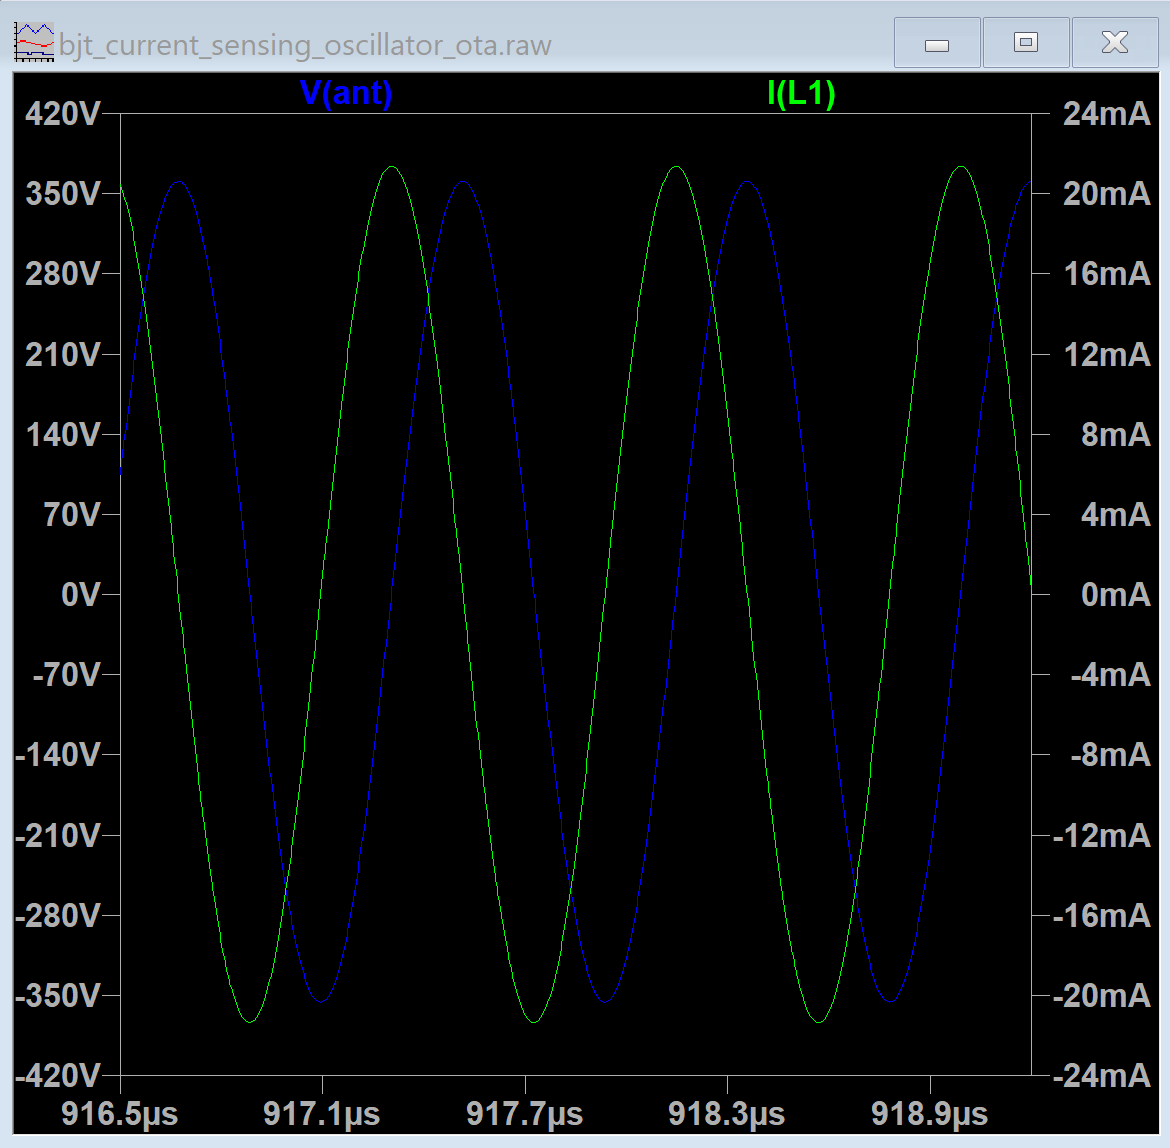
[picture p100: models/ltspice/bjt_current_sensing_oscillator/images/current_sensing_oscillator_ota_ltspice_model_simulation_results_antenna_swing_and_lc_current.png]
drive signal and LC tank current


Simulation results: LC tank current and antenn voltage swing
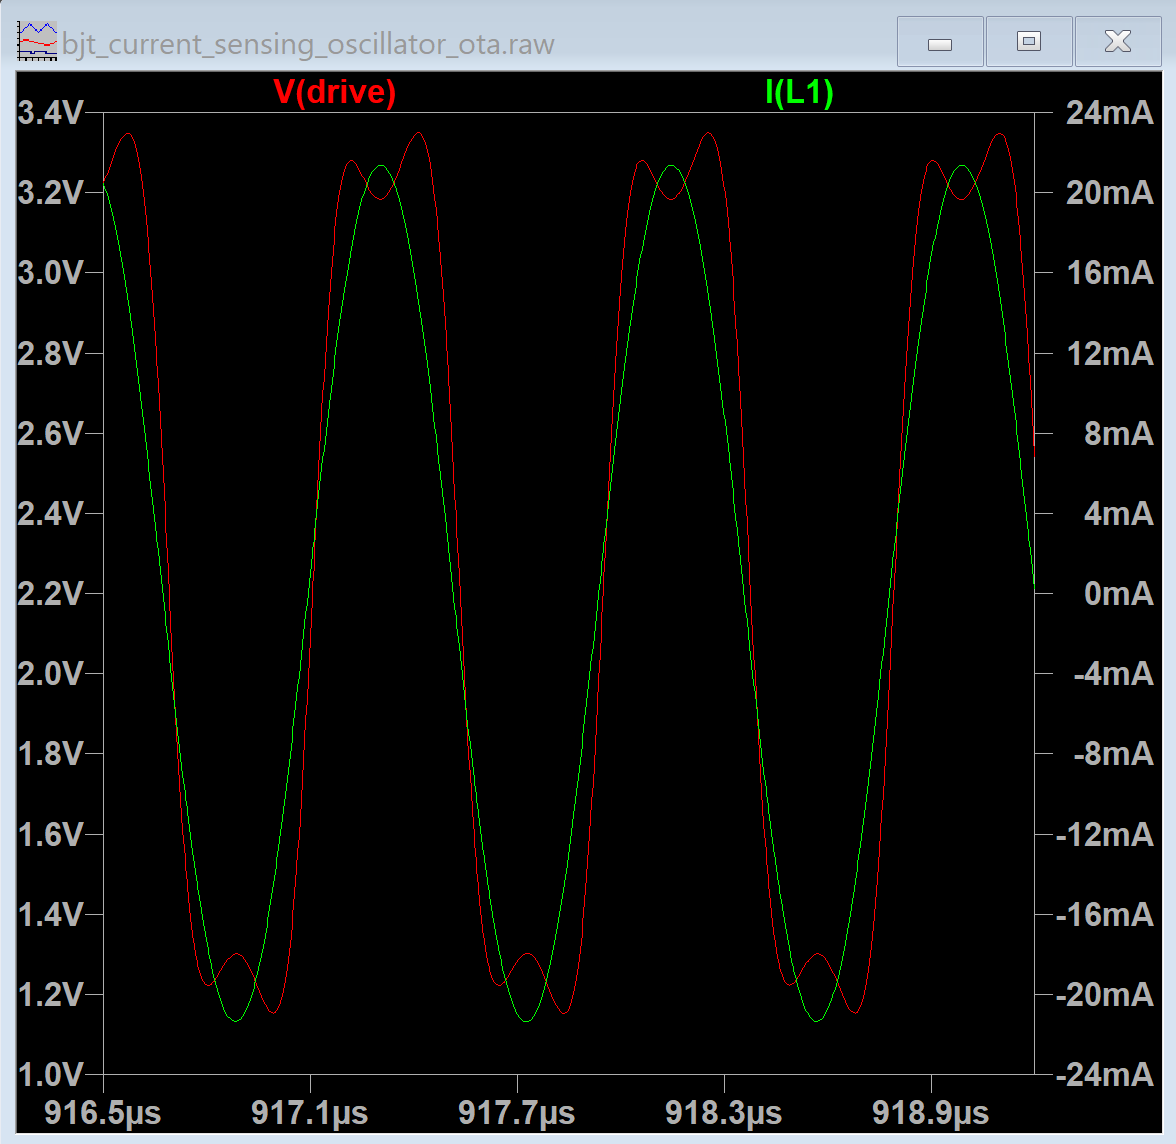
[picture p101: models/ltspice/bjt_current_sensing_oscillator/images/current_sensing_oscillator_ota_ltspice_model_simulation_results_drive_and_lc_tank_current.png]
LC tank current and antenn voltage swing


Single OTA current sensing oscillator with automatic gain control
-----------------------------------------------------------------

Adding automatic gain control to previous model.

Now it can support wide range of inductor values, and even keep oscillation after touching of antenna.

In this model, I'm using 2mH inductor with 20 Ohm serial resistance.

LTSpice model: [bjt_current_sensing_oscillator_ota_v2.asc](bjt_current_sensing_oscillator_ota_v2.asc)
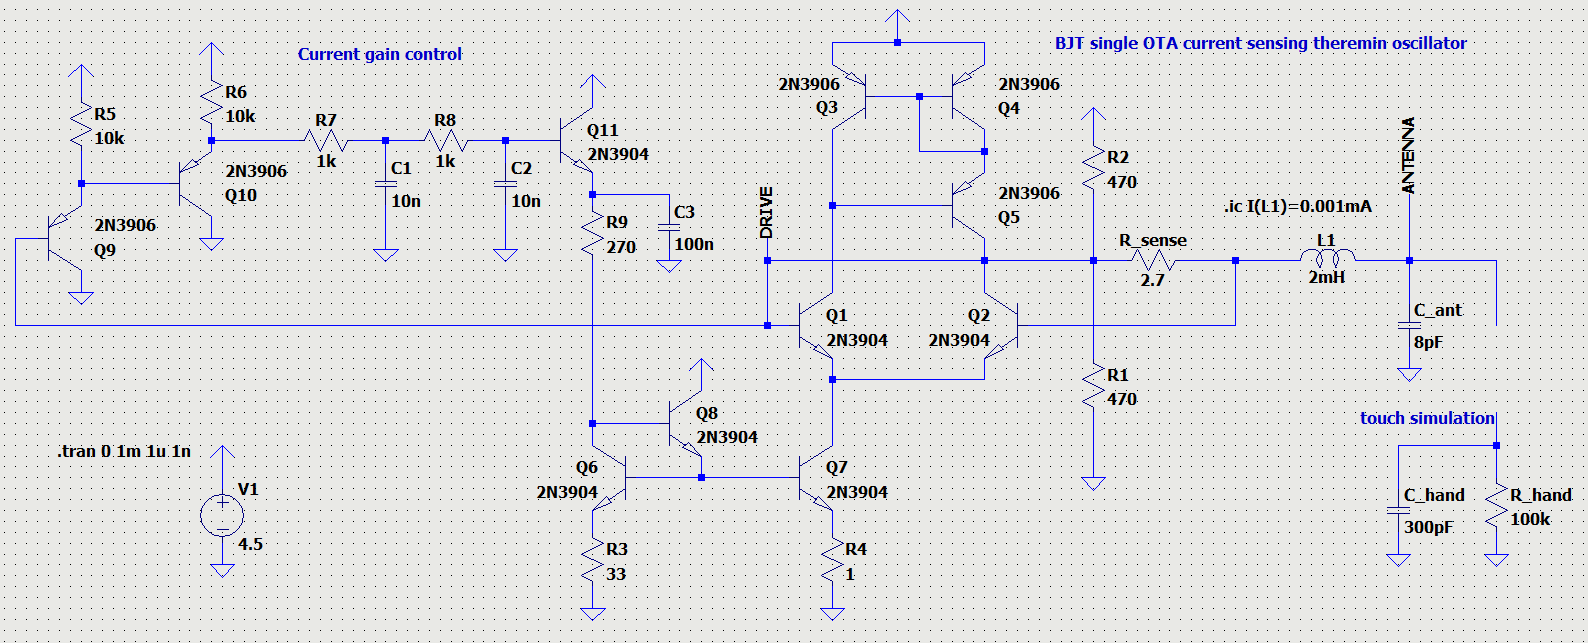
[picture p102: models/ltspice/bjt_current_sensing_oscillator/images/current_sensing_oscillator_ota_auto_gain_control_ltspice_model.png]
Spice model


Simulation results: drive signal and LC tank current
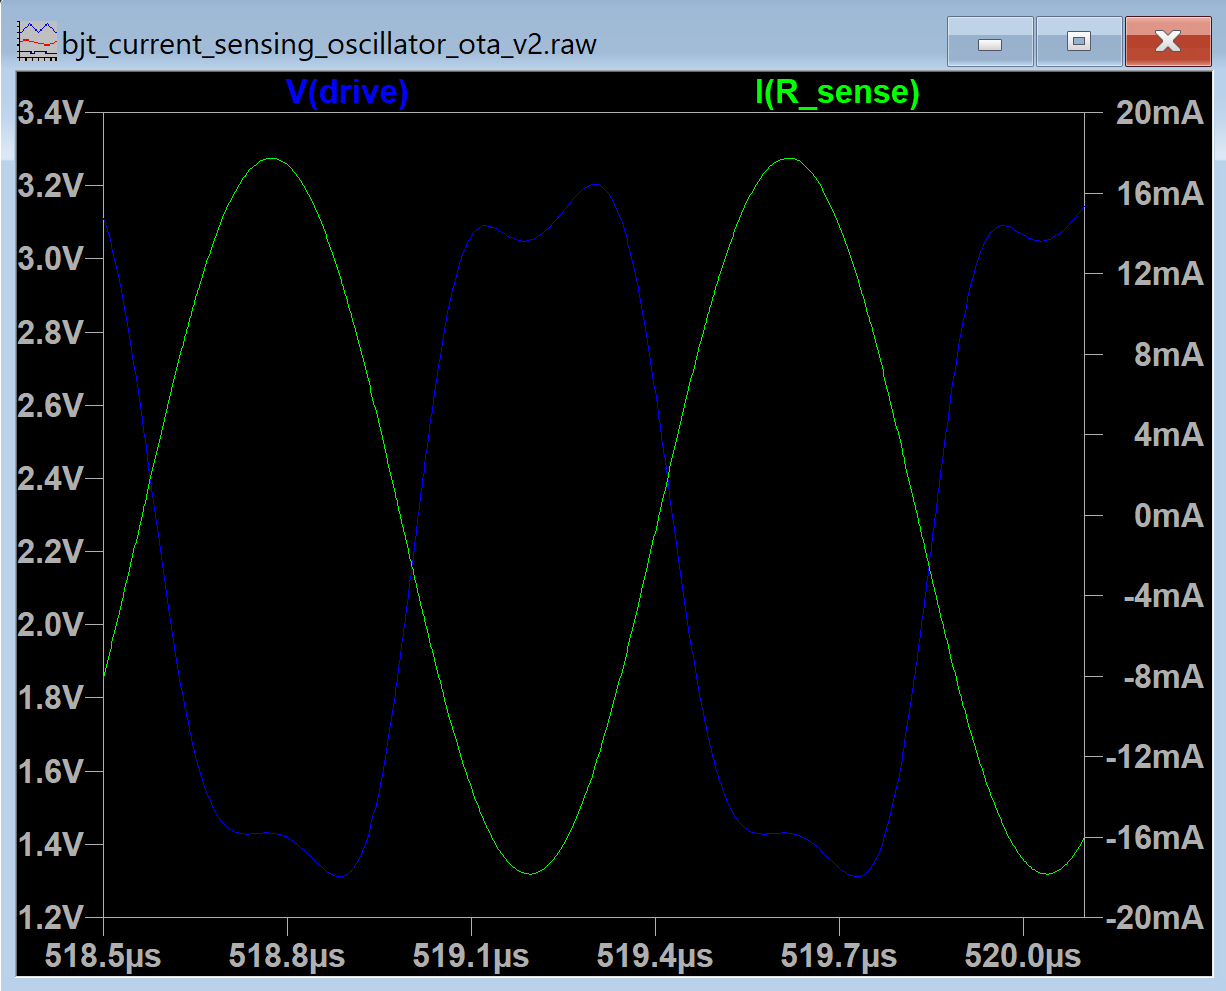
[picture p103: models/ltspice/bjt_current_sensing_oscillator/images/current_sensing_oscillator_ota_auto_gain_control_ltspice_model_simulation_results_drive_and_lc_tank_current.png]
drive signal and LC tank current


Simulation results: LC tank current and antenn voltage swing
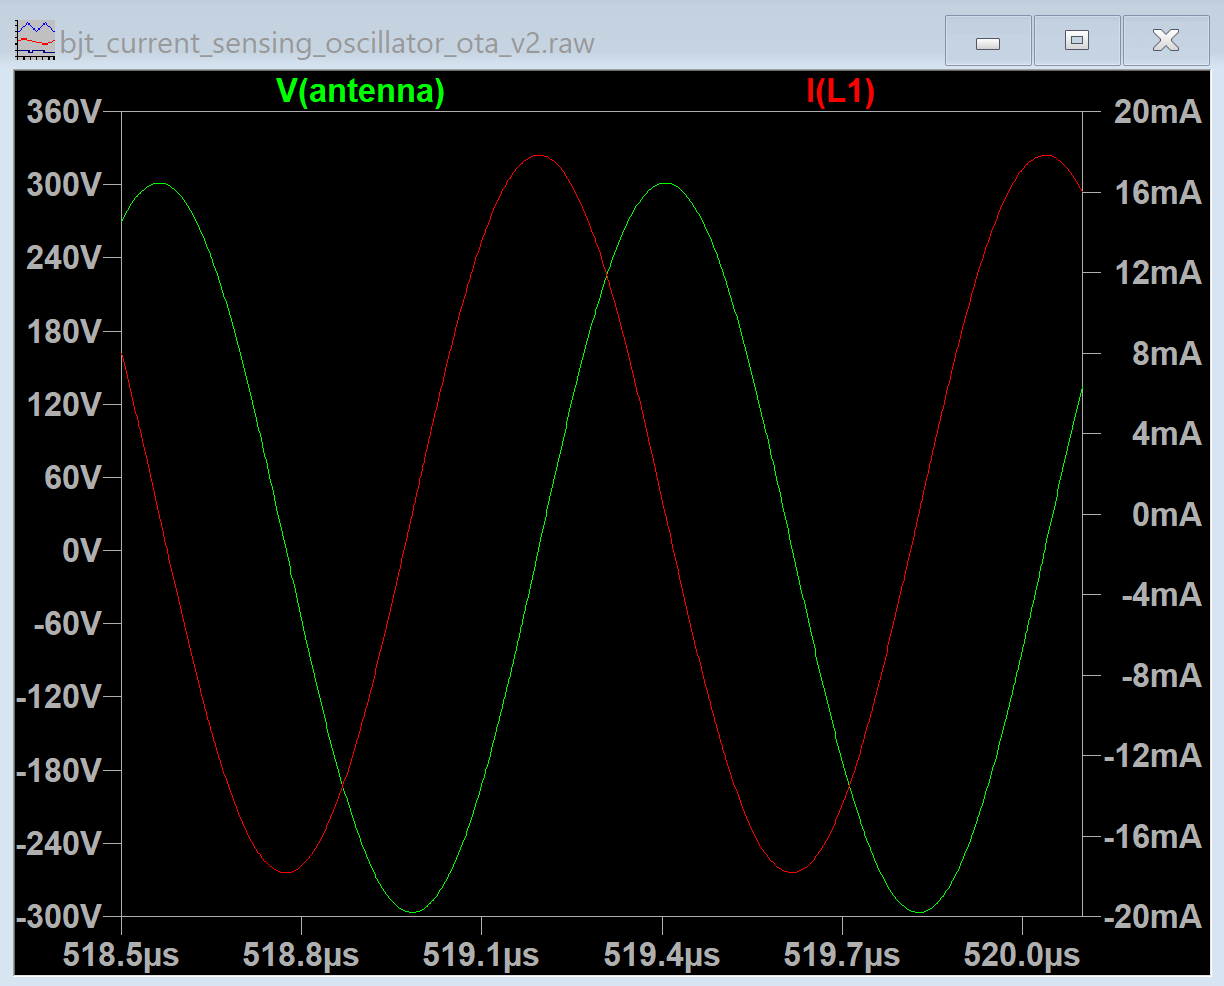
[picture p104: models/ltspice/bjt_current_sensing_oscillator/images/current_sensing_oscillator_ota_auto_gain_control_ltspice_model_simulation_results_antenna_swing_and_lc_current.png]
LC tank current and antenn voltage swing


Current sensing oscillator with automatic gain control - simple current mirrors
-------------------------------------------------------------------------------

Simplified version of previous model.
Only 8 BJTs.

LTSpice model: [bjt_current_sensing_oscillator_ota_v10.asc](bjt_current_sensing_oscillator_ota_v4.asc)
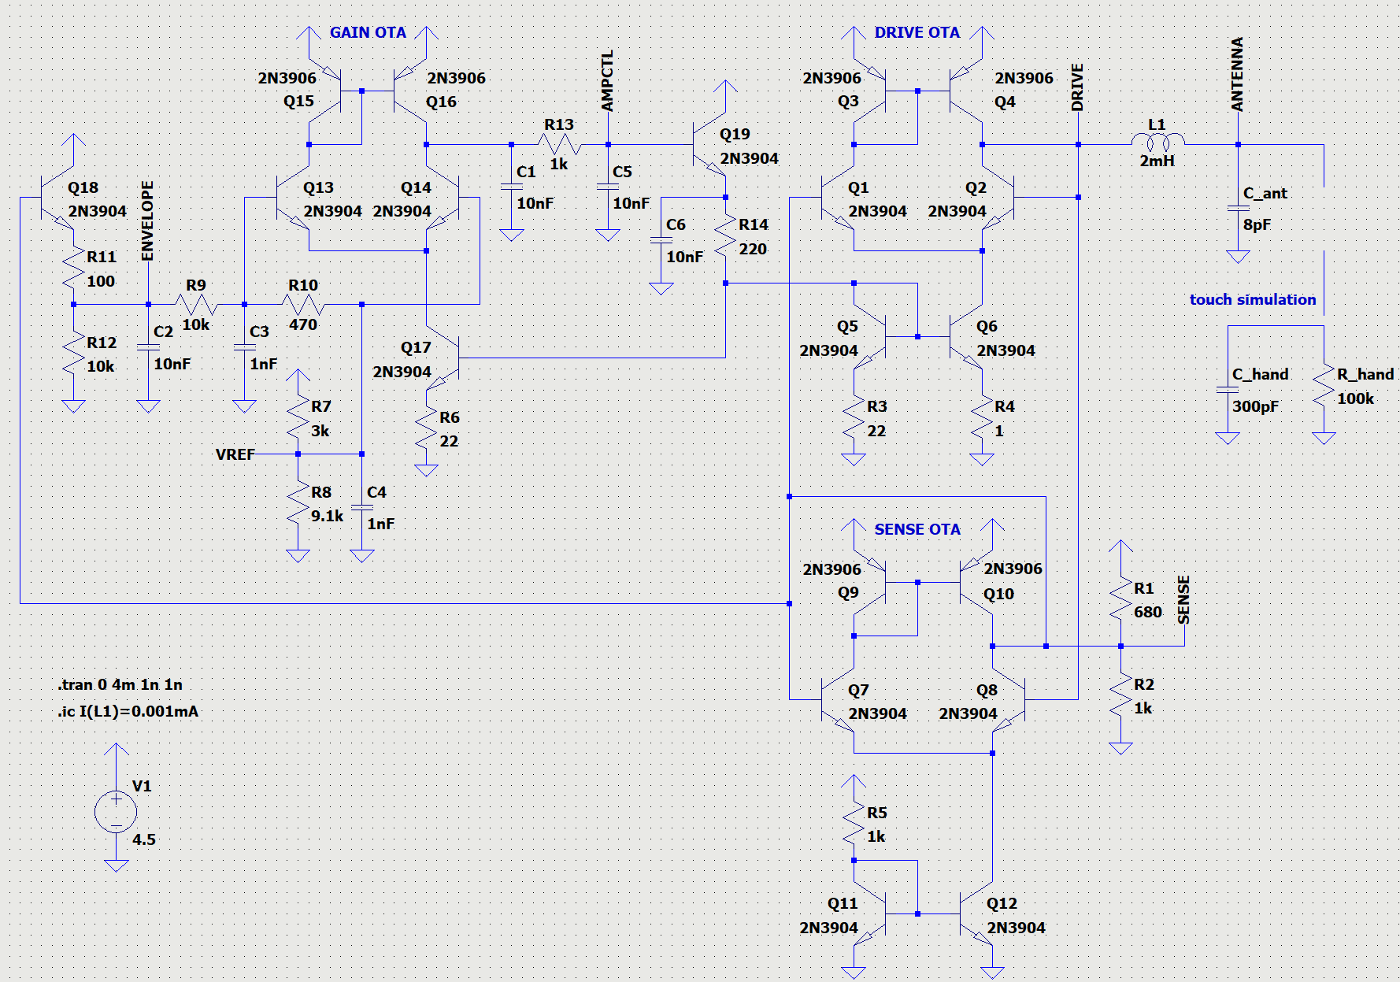
[picture p105: models/ltspice/bjt_current_sensing_oscillator/images/current_sensing_oscillator_ota_auto_gain_control_v10_ltspice_model.png]
Spice model


Current sensing oscillator with automatic gain control - improved version
-------------------------------------------------------------------------

This is theremin current sensing oscillator built using 19 BJTs.

LTSpice model: [bjt_current_sensing_oscillator_ota_v4.asc](bjt_current_sensing_oscillator_ota_v4.asc)
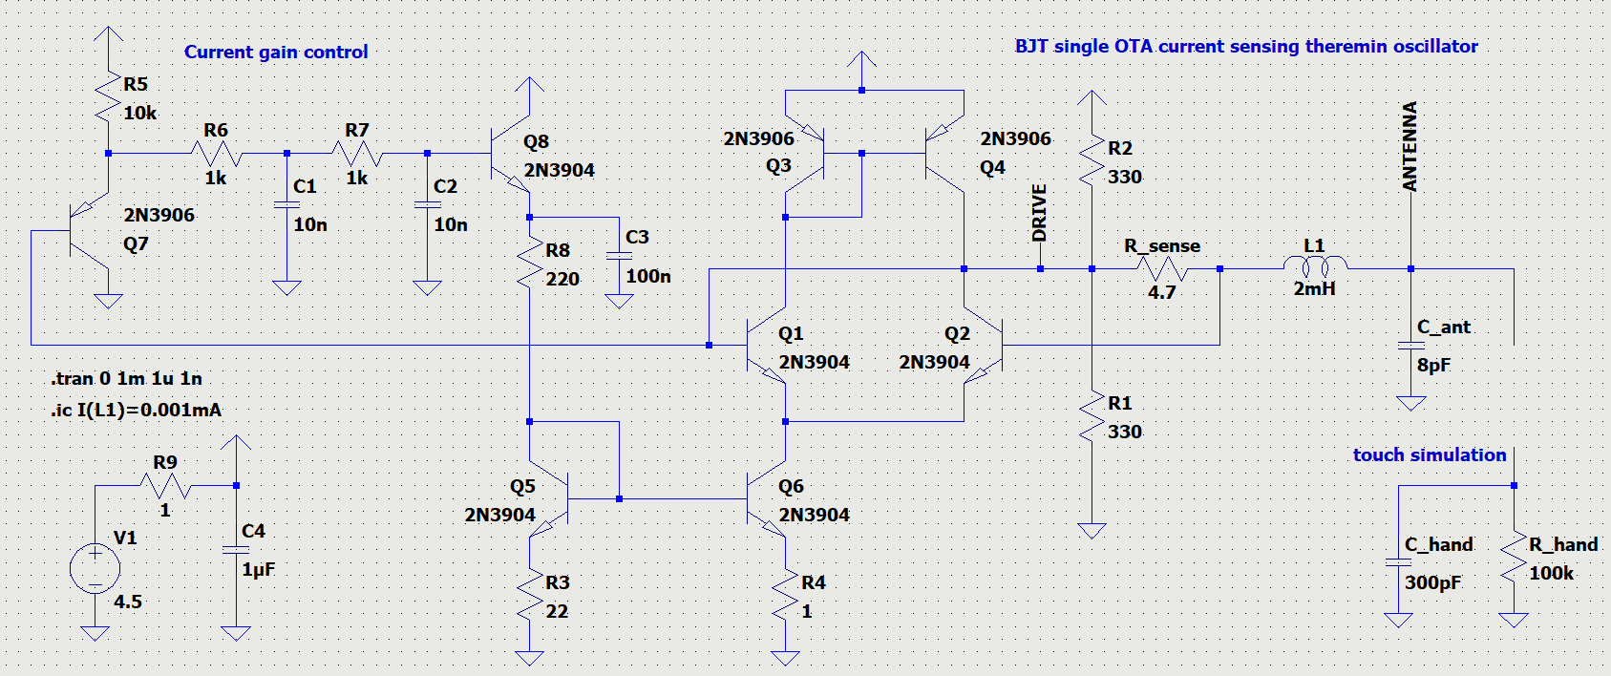
[picture p106: models/ltspice/bjt_current_sensing_oscillator/images/current_sensing_oscillator_ota_auto_gain_control_simplified_ltspice_model.png]
Spice model


Almost clean sine wave drive (third harmonic is 35dB), with stabilized amplitude.
Low phase error: drive signal waveform is only 5-7ns behind LC tank current.
Supports wide range of inductors with minimal tuning of oscillator component values.
Provides enough drive current to keep sine drive waveform.
Stable oscillation when hand approaches antenna, or hand touches antenna.

With 2mH 20 Ohm inductor provides 18mA 2Vpp sine wave drive, with 600Vpp on antenna, sourcing about 50mA from 4.5V power supply.

Drive OTA: voltage follower with variable drive current.
Sense OTA: senses drive current waveform, produces stable amplitude output.
Envelope detection: Q18 detects top edge of amplitude envelope of sense signal.
Gain OTA: compares detected amplitude value with target and charges or discharges C1 which integrates difference of amplitude from target.
Drive current buffer: Q19 controls current source of Drive OTA and Gain OTA.

For practical usage, additional output buffer is needed.
It can be square LVCMOS33 compatible, LVDS compatible, or pure sine wave (for analog theremins).

Simulation results: drive signal and LC tank current
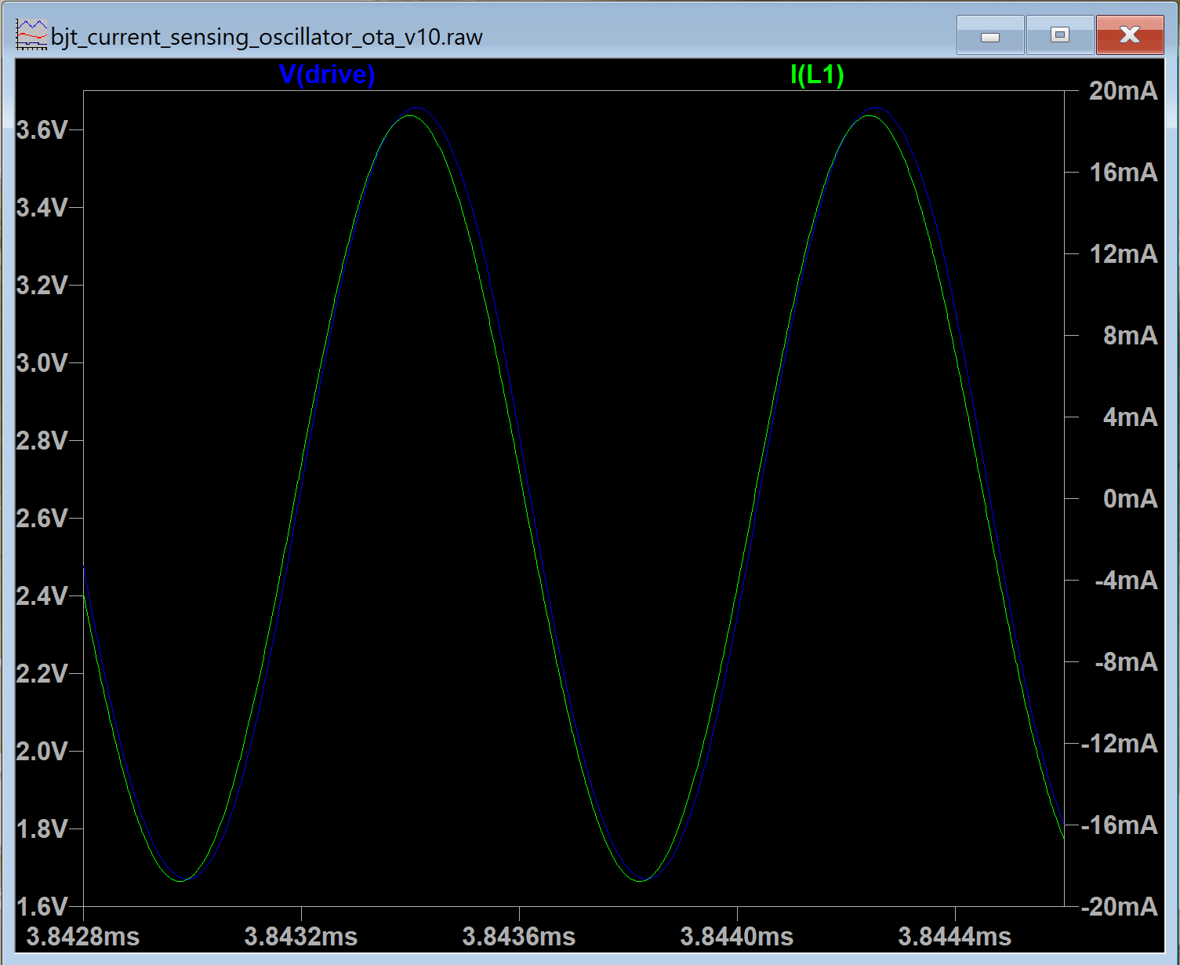
[picture p107: models/ltspice/bjt_current_sensing_oscillator/images/current_sensing_oscillator_ota_auto_gain_control_v10_ltspice_model_simulation_results_drive_and_lc_tank_current.png]
drive signal and LC tank current


Simulation results: LC tank current and antenn voltage swing
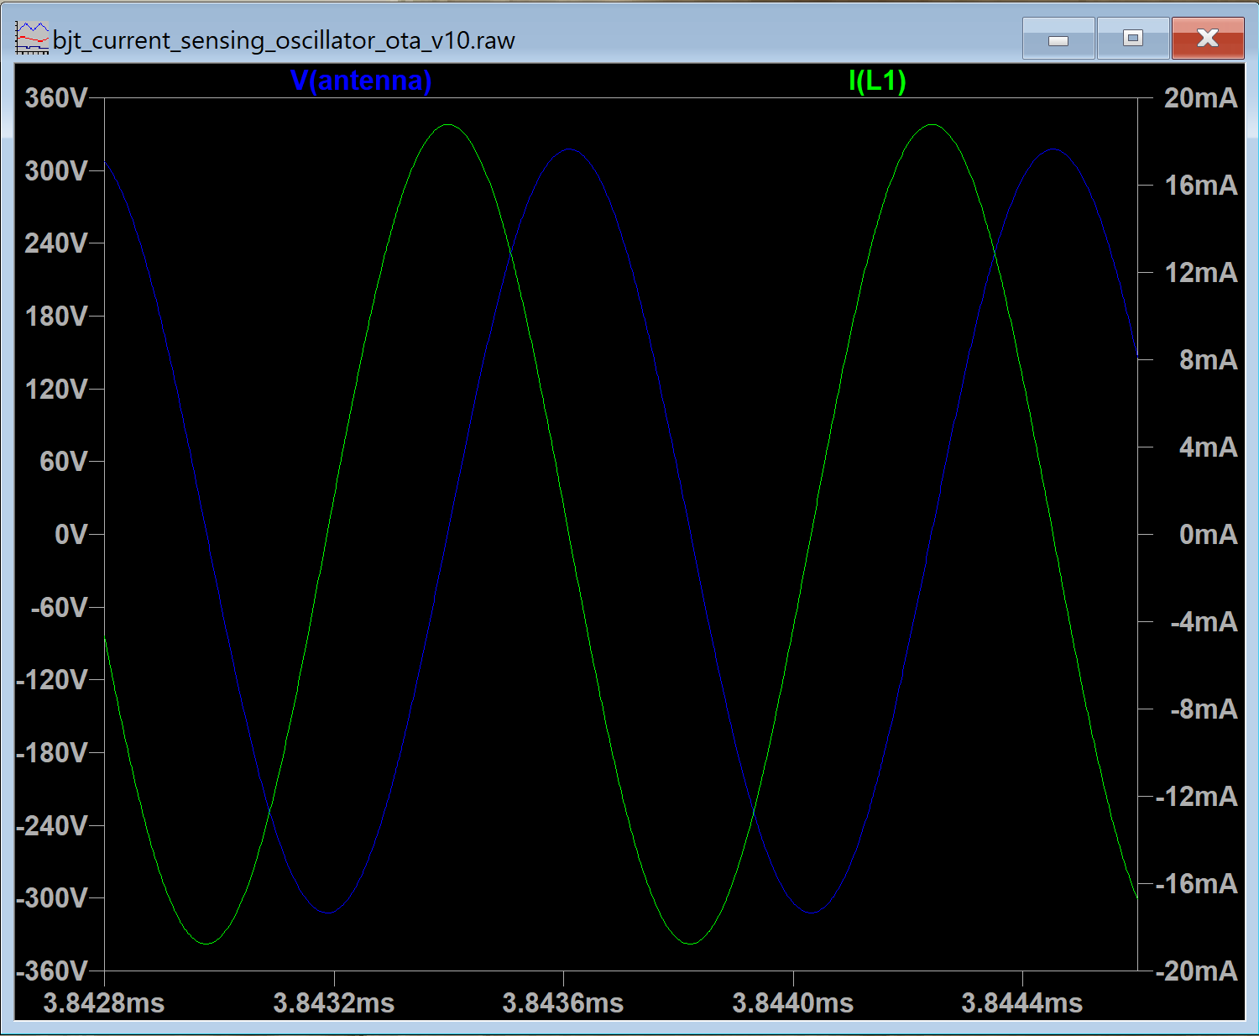
[picture p108: models/ltspice/bjt_current_sensing_oscillator/images/current_sensing_oscillator_ota_auto_gain_control_v10_ltspice_model_simulation_results_antenna_swing_and_lc_current.png]
LC tank current and antenn voltage swing


Current sensing oscillator with automatic gain control - fast drive buffer
--------------------------------------------------------------------------

This is theremin current sensing oscillator built using 15 BJTs.

Uses fast voltage follower (0.5ns propagation delay).

LTSpice model: [bjt_current_sensing_oscillator_ota_v4.asc](bjt_current_sensing_oscillator_ota_v12.asc)
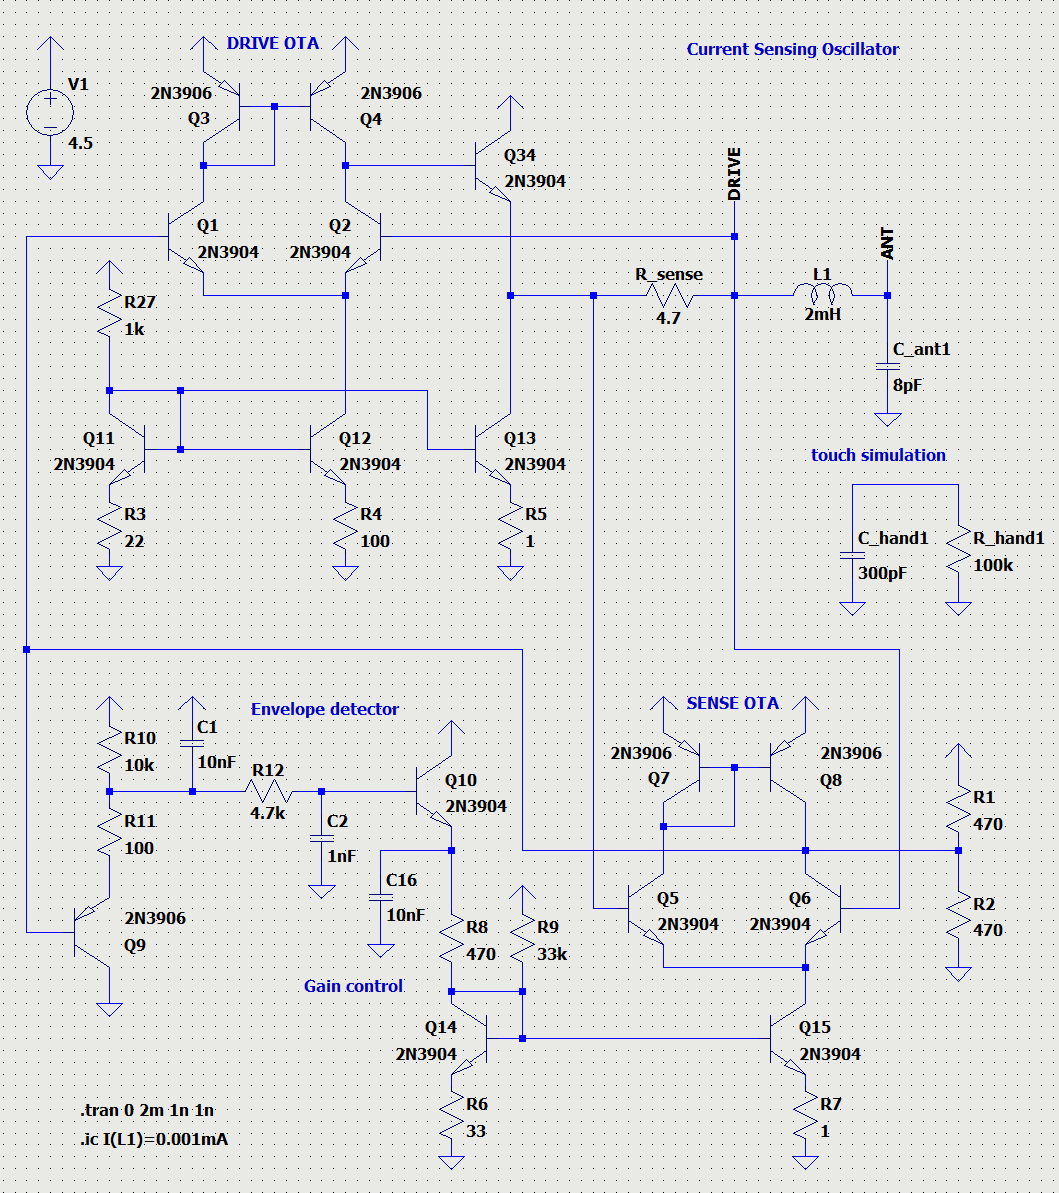
[picture p109: models/ltspice/bjt_current_sensing_oscillator/images/current_sensing_oscillator_ota_auto_gain_control_v12_ltspice_model.png]
Spice model


Power supply: 4.5V 45mA
Inductor: L=2mH R_serial=20 Ohm 
Phase error: 12ns
Drive: 2.2Vpp 24mA smooth square
Antenna voltage swing: 800 Vpp
May be tuned to be closer to sine (20-40dB harmonic) but with smaller antenna swing.

Simulation results: drive signal and LC tank current
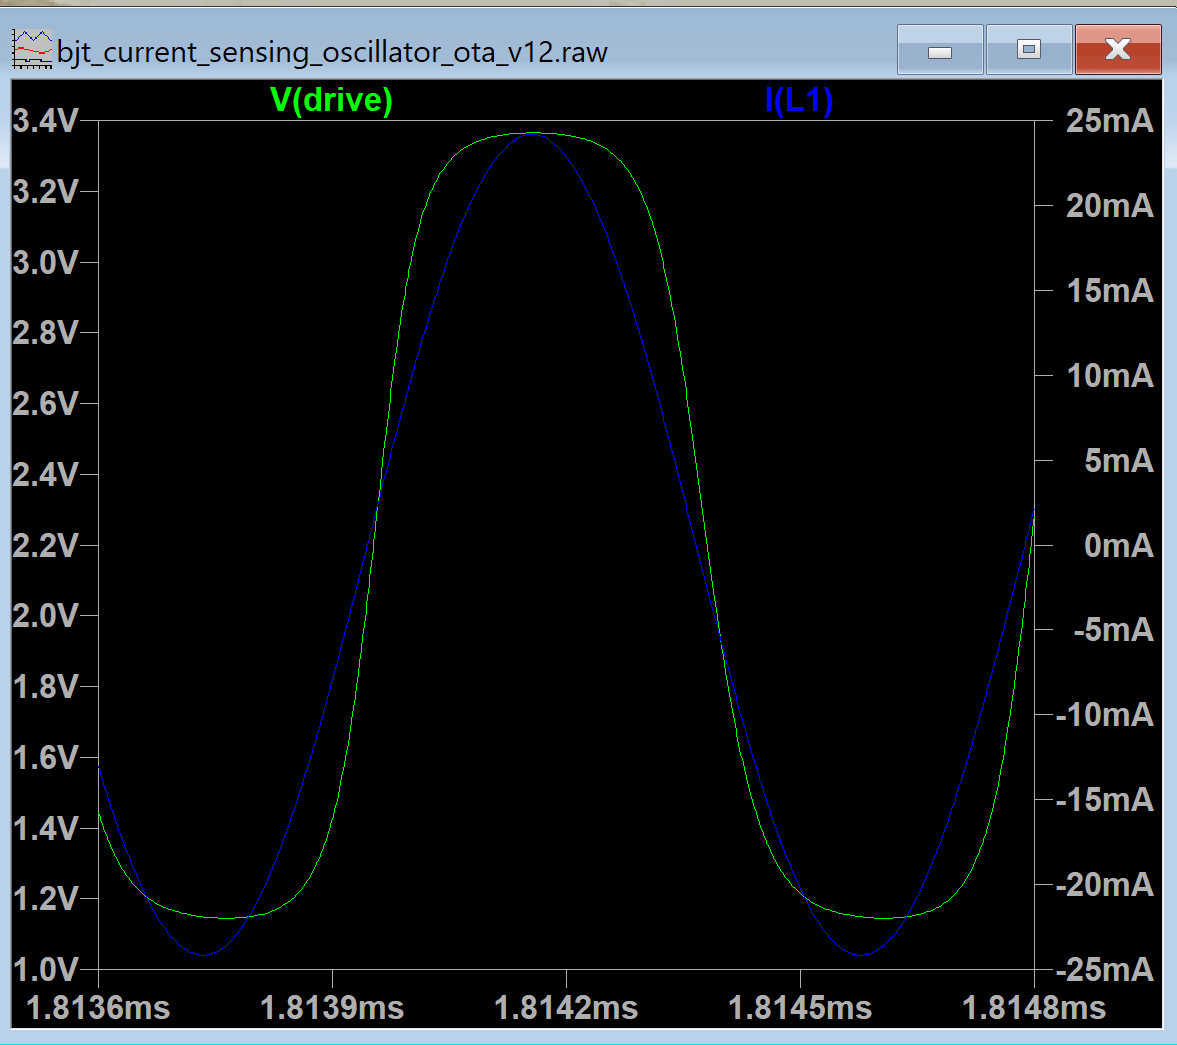
[picture p110: models/ltspice/bjt_current_sensing_oscillator/images/current_sensing_oscillator_ota_auto_gain_control_v12_ltspice_model_simulation_results_drive_and_lc_tank_current.png]
drive signal and LC tank current


Simulation results: LC tank current and antenn voltage swing
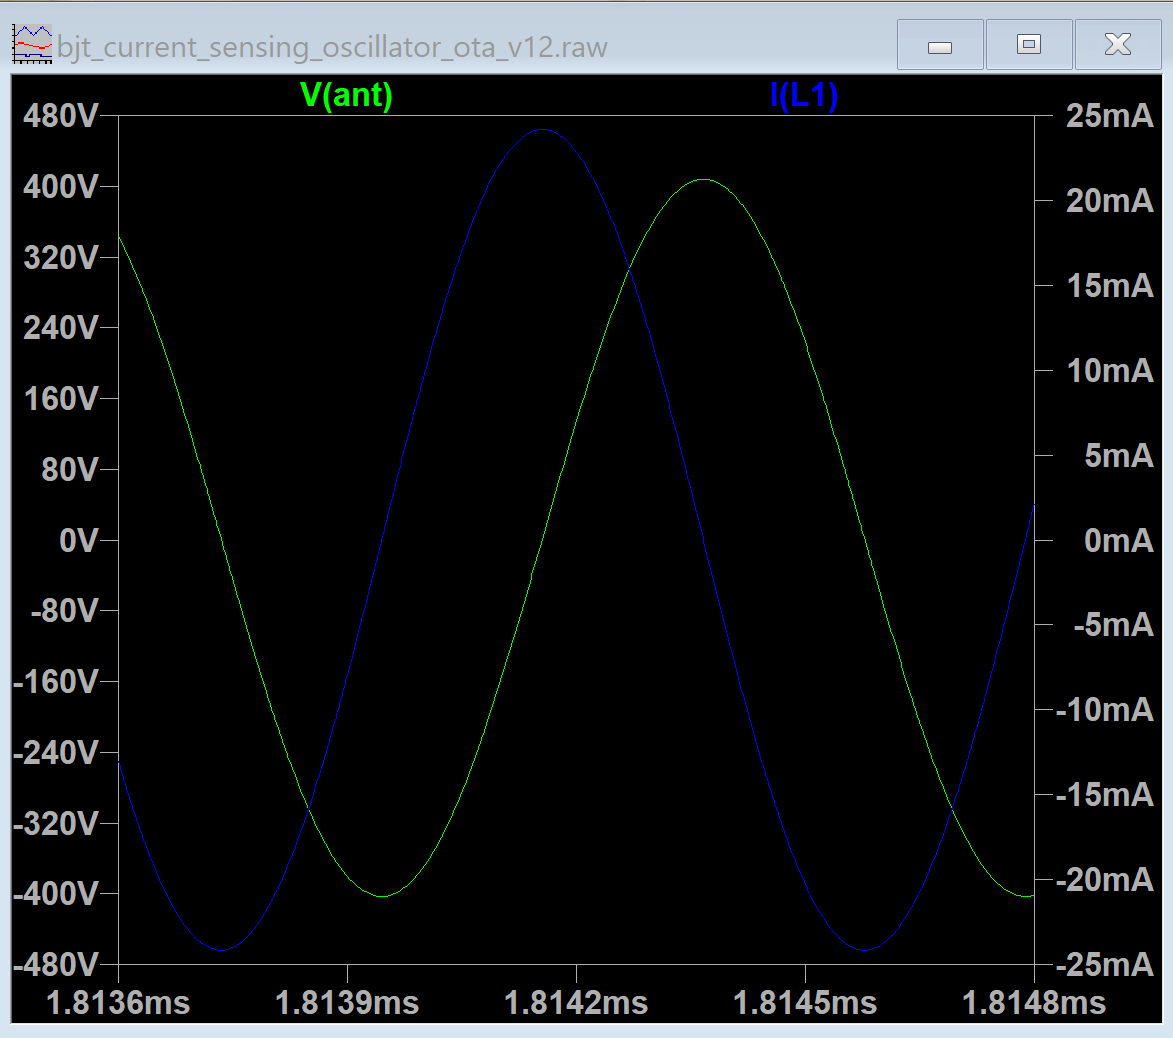
[picture p111: models/ltspice/bjt_current_sensing_oscillator/images/current_sensing_oscillator_ota_auto_gain_control_v12_ltspice_model_simulation_results_antenna_swing_and_lc_current.png]
LC tank current and antenn voltage swing
