fpga-theremin/sensors/models/ltspice/current_sensing_dlev_afe/images/dlev_afe_schematic.png

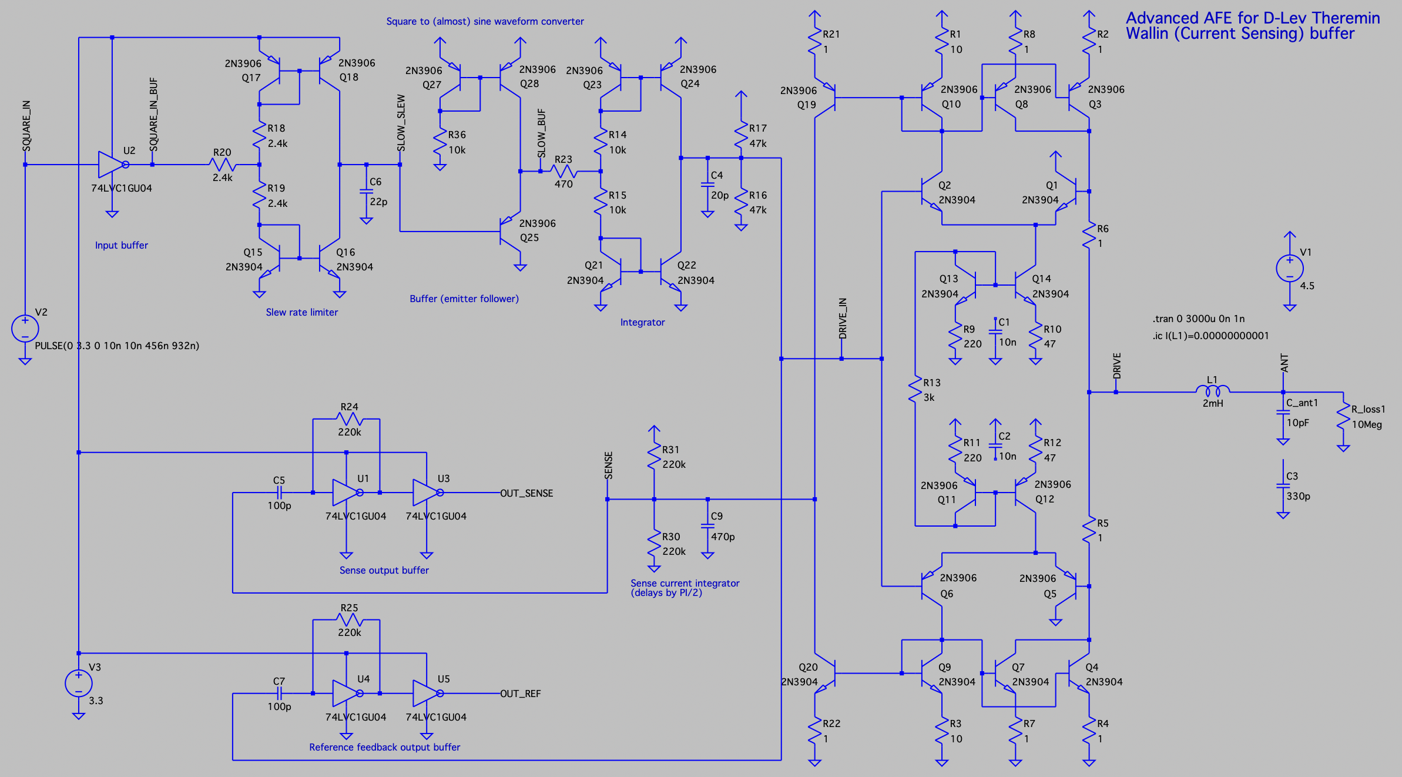
models/ltspice/current_sensing_dlev_afe/images/dlev_afe_schematic.png
