fpga-theremin/sensors/models/ltspice/dlev_afe/images/pll_v01_ltspice_model.png

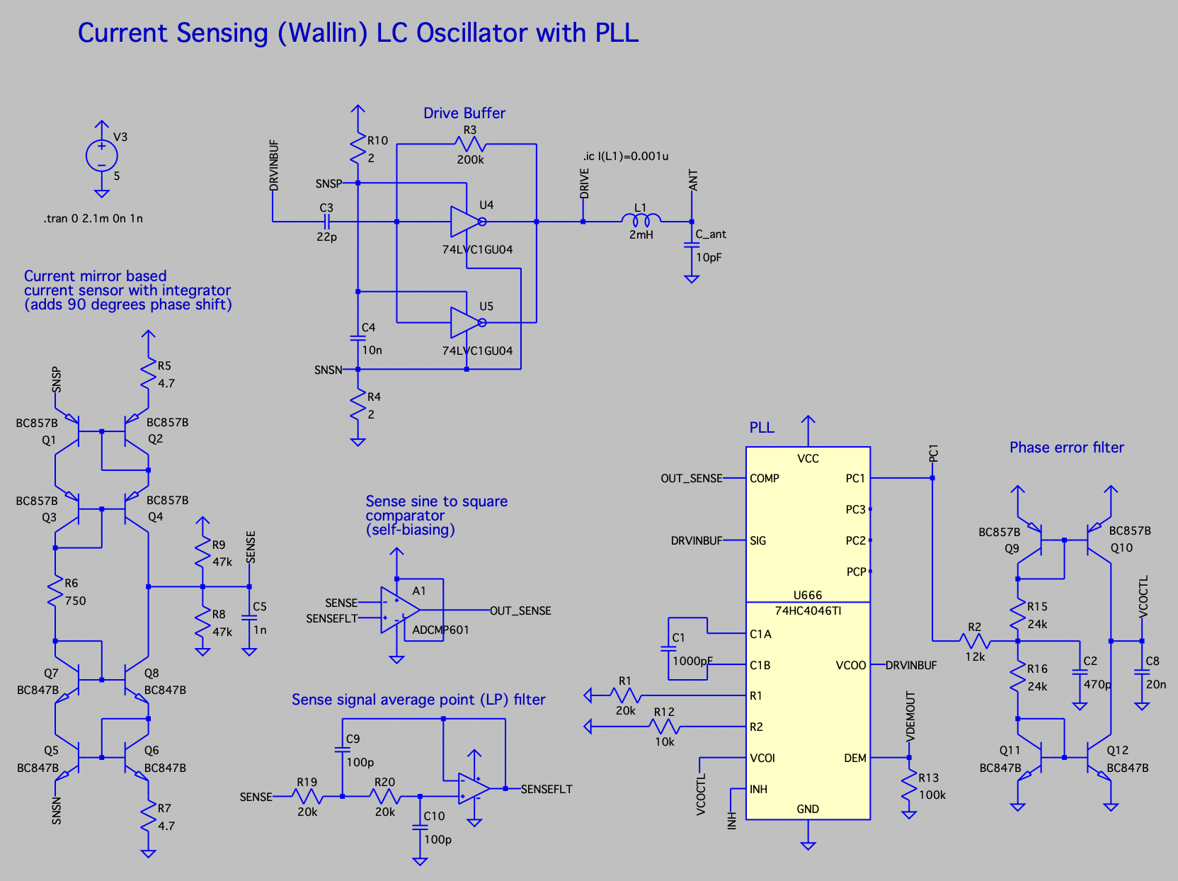
models/ltspice/dlev_afe/images/pll_v01_ltspice_model.png
