fpga-theremin/sensors/models/ltspice/dlev_afe/images/pll_v01_sim_cv_and_ind_current.png

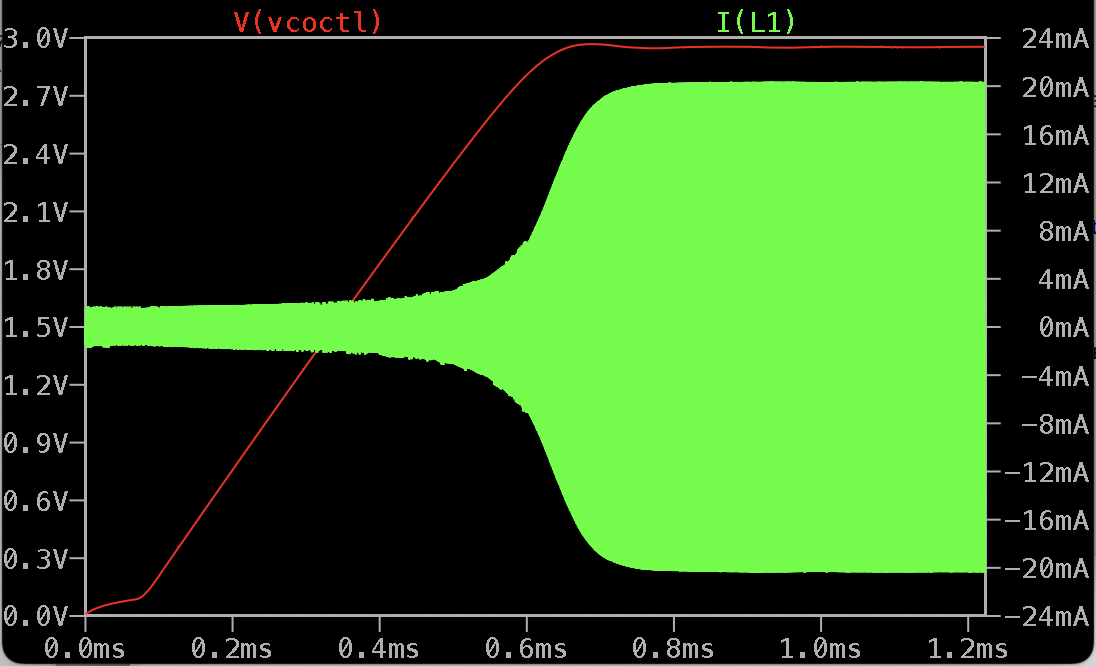
models/ltspice/dlev_afe/images/pll_v01_sim_cv_and_ind_current.png
