fpga-theremin/sensors/models/ltspice/current_sensing_dlev_afe/images/sim_result_drive_sense_and_inductor_current.png

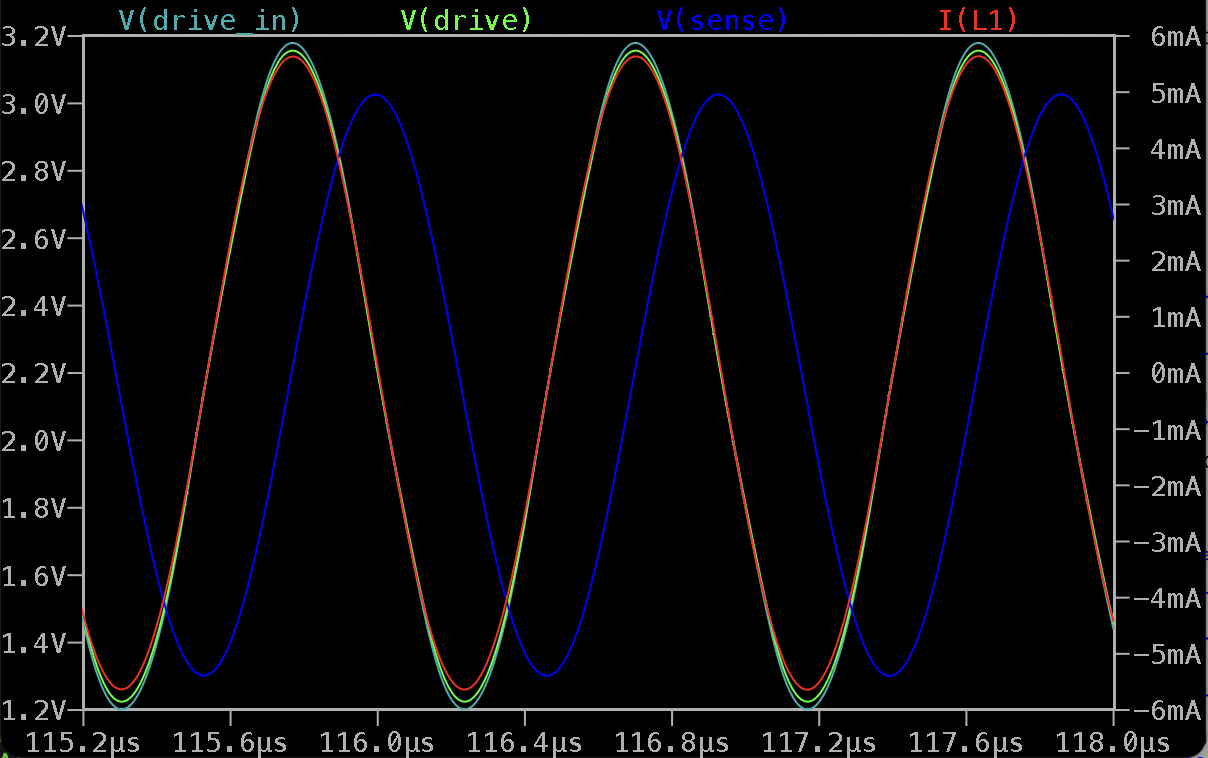
models/ltspice/current_sensing_dlev_afe/images/sim_result_drive_sense_and_inductor_current.png
