fpga-theremin/sensors/models/ltspice/current_sensing_dlev_afe/images/sim_result_inductor_current_and_antenna_voltage.png

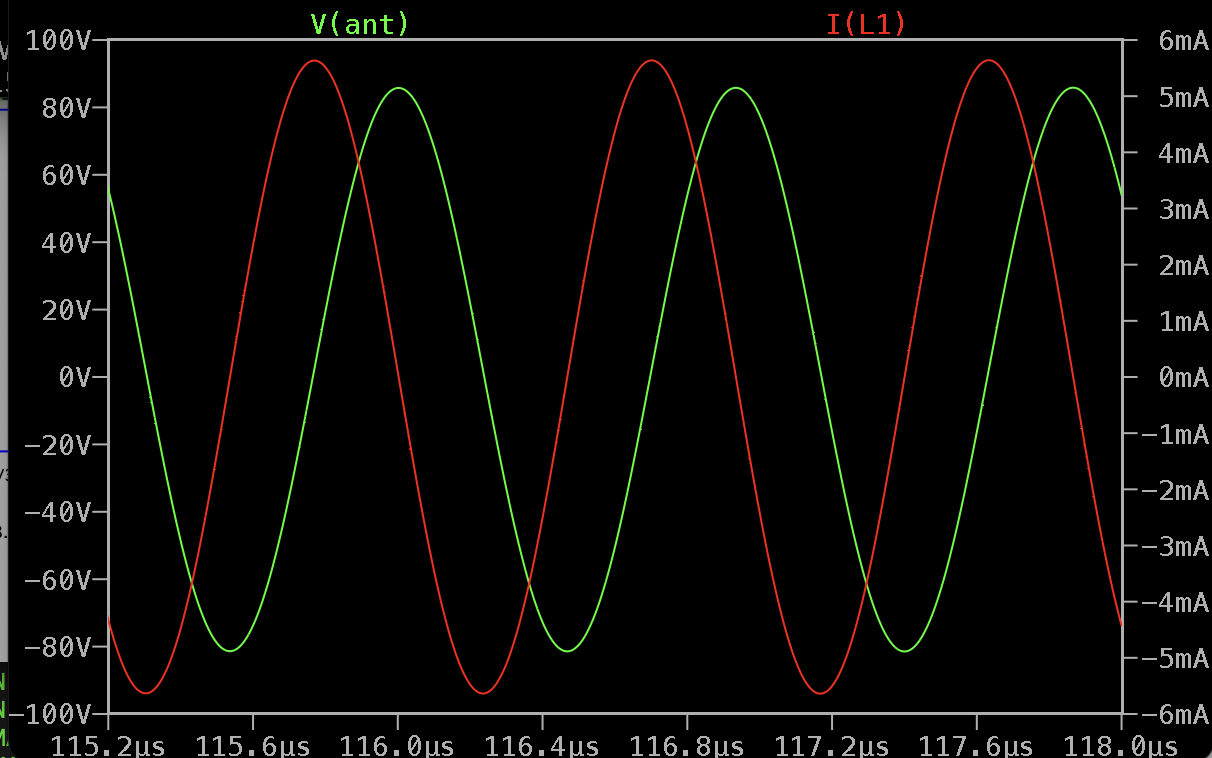
models/ltspice/current_sensing_dlev_afe/images/sim_result_inductor_current_and_antenna_voltage.png
