fpga-theremin/sensors/models/ltspice/current_sensing_dlev_afe/images/sim_result_input_square_to_sine.png

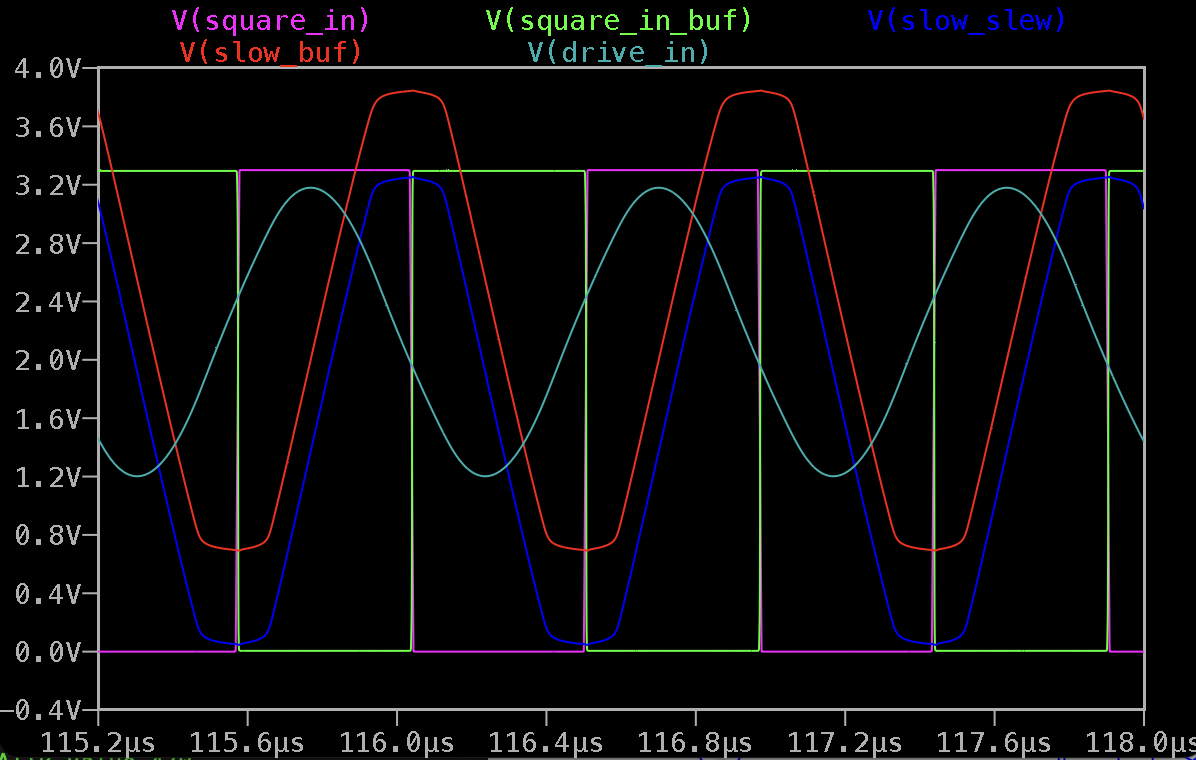
models/ltspice/current_sensing_dlev_afe/images/sim_result_input_square_to_sine.png
