fpga-theremin/sensors/models/ltspice/current_sensing_dlev_afe/images/sim_result_outputs.png

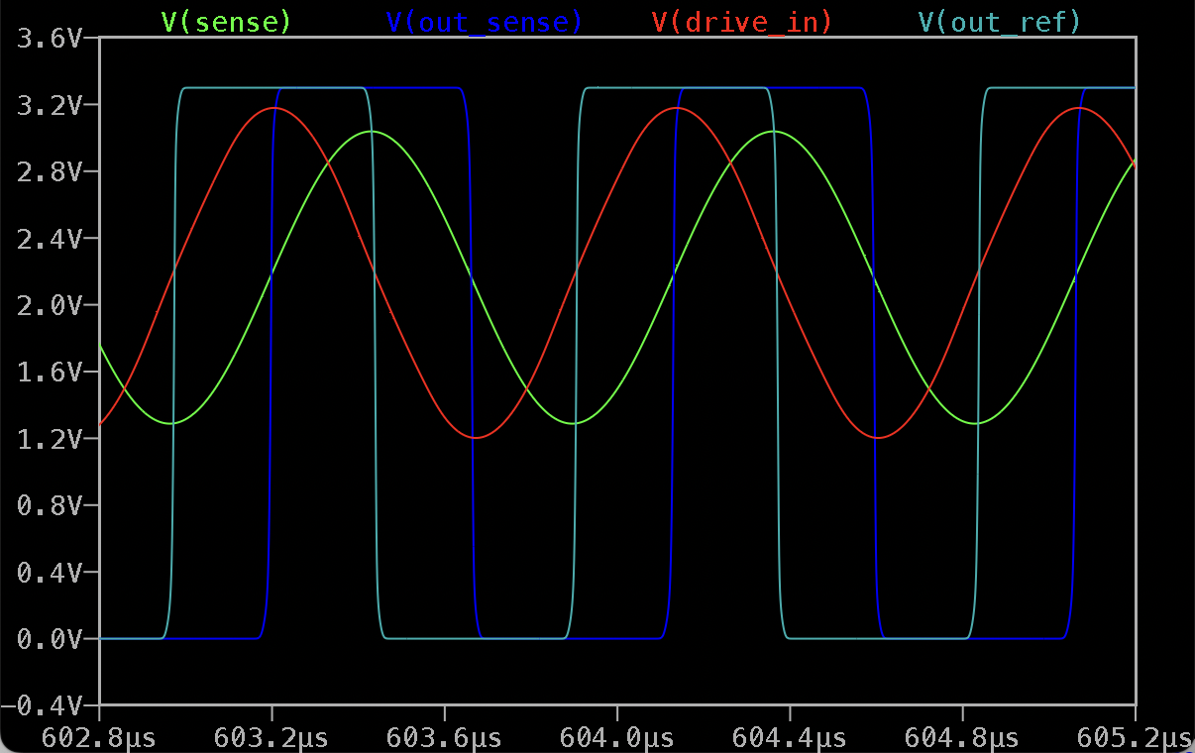
models/ltspice/current_sensing_dlev_afe/images/sim_result_outputs.png
