fpga-theremin/sensors/models/ltspice/dlev_afe/dlev_afe_experiments_v08.asc

C8: Cap; 30p
C9: Cap; 30p
C12: Cap; 1µ
C_ant3: Cap; 10pF
L3: ind; 2mH; Rser=30 Cpar=1pF
Q61: pnp; BC857B
Q62: pnp; BC857B
Q63: npn; BC847B
Q64: npn; BC847B
R63: Res; 4.7
R64: Res; 4.7
R65: Res; 100
R66: Res; 100
R67: Res; 2k
R68: Res; 2k
R69: Res; 200k
R70: Res; 200k
R71: Res; 3k
U3: 74LVC1GU04.asy
U4: 74LVC1GU04.asy
U5: 74LVC1GU04.asy
U6: 74LVC1GU04.asy
V1: voltage; 3.3
Named nets: 0, COM, ANT, DRIVE, SENSE, DRVIN
.tran 0 7m 10u 10n
.ic I(L3)=0.0001u
