fpga-theremin/sensors/models/ltspice/theremin_oscillator_bjt_analog_pll/simple_bjt_pll_sensor_v01.asc

C9: Cap; 30p
C10: Cap; 30p
C_ant: Cap; 10pF
I1: current; PWL(0 800u 300u 800u 10m 1700u)
I2: current; 0.19m
L1: ind; 1mH; Rser=60 Cpar=1pF
L2: ind2; 0.3µH; Rser=0.01 Cpar=1p
L3: ind2; 0.3µH; Rser=0.01 Cpar=1p
Q1: npn; BC847B
Q2: npn; BC847B
Q3: npn; BC847B
Q9: npn; BC847B
Q14: npn; BC847B
Q15: pnp; BC857B
Q16: npn; BC847B
Q17: npn; BC847B
Q18: npn; BC847B
Q19: npn; BC847B
Q20: pnp; BC857B
Q21: npn; BC847B
Q22: npn; BC847B
Q23: pnp; BC857B
Q24: pnp; BC857B
Q25: npn; BC847B
Q26: npn; BC847B
Q27: npn; BC847B
R1: Res; 12
R2: Res; 240k
R3: Res; 390k
R4: Res; 200k
R13: Res; 1k
R42: Res; 1
R43: Res; 100
R55: Res; 100
R56: Res; 10k
R57: Res; 100
R58: Res; 20k
R59: Res; 100
R62: Res; 100
R63: Res; 100
R64: Res; 1
R65: Res; 100
R67: Res; 100
R68: Res; 10k
R69: Res; 100
R70: Res; 100
R71: Res; 100
R73: Res; 10k
R74: Res; 2k
R75: Res; 100
R76: Res; 100
R77: Res; 390
R78: Res; 390
U16: LMH6642
U17: LMH6642
V1: voltage; 4.5
V2: voltage; 3.3
V3: voltage; 2.25
V4: voltage; 1.2
Named nets: 0, COM, VCC33, VREF, ANT, TT2, SENSE, VREF12, TT1, TP, TN, P1, P2, ASENSE1, ASENSE2
.tran 0 12m 10u 1n
Wide Range VCO with Sine full quadrant output to drive Theremin LC tank
K1 L2 L3 1
Sensing transformer
State Variable Filter based VCO
.ic V(P1)=2.24
.ic V(P2)=2.25
