fpga-theremin/sensors/models/ltspice/vco_and_lc_drive/vco_bjt_v02.asc

C1: cap; 100p
C2: cap; 100p
C3: cap; 100p
C4: cap; 100p
I1: current; PWL(0 30u 1m 30u 7m 500u)
I2: current; 100µ
L1: ind; 100µ; Rser=10m Cpar=3p
L2: ind; 100µ; Rser=10m Cpar=3p
L3: ind; 100µ; Rser=10m Cpar=3p
L4: ind; 100µ; Rser=10m Cpar=3p
L5: ind; 100µ; Rser=10m Cpar=3p
L6: ind; 100µ; Rser=10m Cpar=3p
L7: ind; 100µ; Rser=10m Cpar=3p
L8: ind; 100µ; Rser=10m Cpar=3p
Q1: npn; BC847B
Q2: npn; BC847B
Q3: npn; BC847B
Q4: npn; BC847B
Q5: pnp; BC857B
Q6: pnp; BC857B
Q7: pnp; BC857B
Q8: pnp; BC857B
Q9: npn; BC847B
Q10: npn; BC847B
Q11: npn; BC847B
Q12: npn; BC847B
Q13: npn; BC847B
Q14: npn; BC847B
Q15: npn; BC847B
Q16: npn; BC847B
Q17: npn; BC847B
Q18: npn; BC847B
Q19: npn; BC847B
Q20: npn; BC847B
R1: Res; 100
R2: Res; 100
R3: Res; 2k
R4: Res; 100
R5: Res; 100
R6: Res; 2k
R7: Res; 100
R8: Res; 2k
R9: Res; 100
R10: Res; 100
R11: Res; 100
R12: Res; 100
R13: Res; 2k
R14: Res; 100
R15: Res; 100
R16: Res; 100
R17: Res; 2k
R18: Res; 2k
R19: Res; 2k
R20: Res; 2k
R21: Res; 2k
R22: Res; 2k
V1: voltage; 4.5
V2: Voltage; 2.25
V3: Voltage; 1.2
V4: voltage; SINE(0 0.2 1000k 0 0 0)
V5: voltage; SINE(0 0.2 1000k 0 0 180)
Named nets: VCOBIAS2, 0, VREF, COM, VREF12, T1N, T1P, T2P, T2N, BUFBIAS, B2P, B2N, T3P, T3N, B3P, BbN, B3N
Amplitude limiter on OTA
.tran 0 20m 100u 2n
K1 L1 L2 L3 L4 1
K2 L5 L6 L7 L8 1
