fpga-theremin/sensors/models/ltspice/theremin_oscillator_bjt_analog_pll/theremin_oscillator_bjt_pll_v02.asc

C1: Cap; 27p
C2: Cap; 27p
C5: Cap; 10n
C_ant: Cap; 10pF
I2: current; 500µ
L1: ind; 2mH; Rser=120 Cpar=1pF
L2: ind2; 0.3µH; Rser=0.1 Cpar=0.1p
L3: ind2; 0.3µH; Rser=0.1 Cpar=0.1p
Q1: pnp; BC857B
Q2: pnp; BC857B
Q3: pnp; BC857B
Q4: pnp; BC857B
Q5: npn; BC847B
Q6: npn; BC847B
Q7: npn; BC847B
Q8: npn; BC847B
Q9: npn; BC847B
Q10: npn; BC847B
Q11: npn; BC847B
Q12: npn; BC847B
Q13: npn; BC847B
Q14: pnp; BC857B
Q15: pnp; BC857B
Q16: npn; BC847B
Q17: pnp; BC857B
Q18: pnp; BC857B
Q19: npn; BC847B
Q20: npn; BC847B
Q21: npn; BC847B
Q22: npn; BC847B
Q23: npn; BC847B
Q24: npn; BC847B
Q25: npn; BC847B
Q26: npn; BC847B
Q27: npn; BC847B
Q28: npn; BC847B
Q29: npn; BC847B
Q30: npn; BC847B
Q31: npn; BC847B
Q32: npn; BC847B
Q33: npn; BC847B
Q34: npn; BC847B
Q35: npn; BC847B
Q36: npn; BC847B
Q37: npn; BC847B
Q38: npn; BC847B
Q39: npn; BC847B
Q40: npn; BC847B
Q41: npn; BC847B
Q42: npn; BC847B
Q43: npn; BC847B
Q44: npn; BC847B
Q45: npn; BC847B
Q46: pnp; BC857B
Q47: pnp; BC857B
Q48: pnp; BC857B
Q49: pnp; BC857B
Q50: npn; BC847B
Q51: npn; BC847B
Q52: npn; BC847B
Q53: npn; BC847B
Q54: npn; BC847B
Q55: npn; BC847B
Q56: pnp; BC857B
Q57: pnp; BC857B
Q58: pnp; BC857B
Q59: pnp; BC857B
Q171: npn; BC847B
Q172: npn; BC847B
R1: Res; 200
R2: Res; 12k
R3: Res; 100
R4: Res; 12k
R5: Res; 1.8k
R6: Res; 100
R7: Res; 100
R8: Res; 100
R9: Res; 100
R10: Res; 100
R11: Res; 100
R12: Res; 27k
R13: Res; 1k
R14: Res; 100
R15: Res; 100
R16: Res; 100
R17: Res; 100
R18: Res; 100
R19: Res; 100
R20: Res; 13k
R21: Res; 200
R22: Res; 3.6k
R23: Res; 3.6k
R24: Res; 1.5k
R25: Res; 10k
R26: Res; 3.6k
R27: Res; 1.5k
R28: Res; 2k
R29: Res; 100
R30: Res; 3.6k
R31: Res; 200
R32: Res; 200
R33: Res; 43
R34: Res; 1.5k
R35: Res; 1.5k
R36: Res; 4.7k
R37: Res; 200
R38: Res; 4.7k
R39: Res; 200
R40: Res; 4.7k
R41: Res; 4.7k
R42: Res; 1.8k
R43: Res; 3k
R44: Res; 3k
R45: Res; 2.4k
R46: Res; 680
R47: Res; 2.4k
R48: Res; 680
R49: Res; 3k
R50: Res; 13k
R51: Res; 47k
R52: Res; 47k
R53: Res; 3k
R54: Res; 10k
R55: Res; 2.7k
R56: Res; 2.7k
R57: Res; 10k
R58: Res; 13k
R59: Res; 2.2k
R60: Res; 10k
R61: Res; 3k
R62: Res; 3k
R63: Res; 13k
R64: Res; 10k
R65: Res; 3k
R66: Res; 3k
R67: Res; 10k
R68: Res; 3k
R69: Res; 3k
R70: Res; 9.1k
R71: Res; 3k
R72: Res; 3k
R73: Res; 9.1k
R74: Res; 3k
R75: Res; 3k
R233: Res; 100
U1: LMH6642
U2: MCP6021
U3: MCP6021
U4: MCP6021
U5: MCP6021
U6: MCP6021
U7: 74LVC1GU04.asy
U8: 74LVC1GU04.asy
U9: 74LVC1GU04.asy
U10: 74LVC1GU04.asy
V1: voltage; 4.5
V2: voltage; 3.3
V3: voltage; 2.25
V4: voltage; 1.65
V7: voltage; 1.2
V20: Voltage; SINE(2.25 0.5 1000k)
Named nets: 0, COM, VCC33, VREF, ANT, DRIVE, VREF12, SENSE12, CCTL2, VCOBIAS, AMPBIAS, BSENSE1, BSENSE2, BBIAS, T1N, T1P, T2N, T2P, DRVN, DRVP, CV, VREF165, SIN1, SIN3, SIN2, SIN4, SQOUT1, SQOUT2, SQOUT3, SQOUT4
.tran 0 30m 10u 10n
Current Sensing Theremin Oscillator with Sine Drive and Analog PLL
K1 L2 L3 1
Sensing transformer
Drive Amplifier
VCO SVF Differential Integrator 1
VCO SVF Differential Integrator 2
VCO SVF Filter Input
Phase Shift Integrator (Analog Multiplier)
CV to Current
Converter
CV Current Sensing
(*) Amp vs Freq 
Flatness Adjustment
Analog Out Buffer phase=0
Analog Out Buffer phase=90
Analog Out Buffer phase=45
Analog Out Buffer phase=135
Single Ended Square Output Buffer
Single Ended Square Output Buffer
Single Ended Square Output Buffer
Single Ended Square Output Buffer
