fpga-theremin/sensors/models/ltspice/current_sensing_buffer_with_gain_control/current_sensing_drive_buffer_v06.asc

C1: Cap; 10n
C2: Cap; 10n
C3: Cap; 10n
C4: Cap; 10n
C5: Cap; 10n
C6: Cap; 10n
C7: Cap; 10n
C8: Cap; 10n
C9: Cap; 1n
C10: Cap; 1n
C18: Cap; 10n
C19: Cap; 10n
C20: Cap; 330p
C_ant: Cap; 10pF
L1: ind; 2mH; Rser=120 Cpar=1pF
Q1: npn; 2N3904
Q2: npn; 2N3904
Q3: pnp; 2N3906
Q4: pnp; 2N3906
Q6: pnp; 2N3906
Q7: pnp; 2N3906
Q8: npn; 2N3904
Q9: npn; 2N3904
Q11: npn; 2N3904
Q13: pnp; 2N3906
Q14: pnp; 2N3906
Q19: pnp; 2N3906
Q21: npn; 2N3904
Q22: pnp; 2N3906
Q23: npn; 2N3904
Q24: npn; 2N3904
Q25: pnp; 2N3906
Q26: pnp; 2N3906
Q27: npn; 2N3904
Q28: npn; 2N3904
Q29: pnp; 2N3906
Q30: pnp; 2N3906
Q31: npn; 2N3904
Q32: npn; 2N3904
Q33: pnp; 2N3906
Q34: pnp; 2N3906
Q35: npn; 2N3904
Q36: npn; 2N3904
R1: Res; 4.7k
R3: Res; 10
R4: Res; 1
R6: Res; 10
R7: Res; 1
R9: Res; 1
R10: Res; 1
R11: Res; 1
R15: Res; 1
R16: Res; 1
R18: Res; 4.7k
R29: Res; 820
R30: Res; 100
R31: Res; 100
R32: Res; 100
R33: Res; 100
R34: Res; 820
R35: Res; 100
R36: Res; 1
R37: Res; 820
R38: Res; 100
R39: Res; 820
R44: Res; 15k
R45: Res; 4.7k
R48: Res; 4.7k
R49: Res; 2.4k
R50: Res; 100k
R54: Res; 220
R55: Res; 47
R56: Res; 220
R57: Res; 47
R58: Res; 3k
R_loss: Res; 10Meg
V1: voltage; 4.5
V2: Voltage; SINE(2.25 1.2 1072700)
V3: Voltage; PWL(0 2.25 1m 0 2m 4.5 3m 2.25)
V4: Voltage; SINE(2.25 2.25 10000)
V5: Voltage; 1
Named nets: 0, COM, ANT, DRIVE, DRIVE_IN, GAINCTL, SENSE
.tran 0 3000u 0n 1n
.ic I(L1)=0.00000000001
Wallin (Current Sensing) 
Theremin Sensor Drive Buffer
with gain control, 
<80dB harmonics,
and small (1-3ns) phase error
