fpga-theremin/sensors/models/ltspice/vco_and_lc_drive/dlev_afe_v01.asc

C1: Cap; 30p
C2: Cap; 10n
C3: Cap; 1n
C4: Cap; 1µ
C5: Cap; 1n
C6: Cap; 1n
C7: Cap; 10p
C8: Cap; 10p
C9: Cap; 4.7p
C10: Cap; 100p
C11: Cap; 100n
C12: Cap; 10p
C_ant1: Cap; 10pF
L1: ind; 2mH; Rser=120 Cpar=1pF
Q1: pnp; BC857B
Q2: npn; BC847B
Q3: pnp; BC857B
Q4: pnp; BC857B
Q5: pnp; BC857B
Q6: npn; BC847B
Q7: npn; BC847B
Q8: npn; BC847B
Q9: npn; BC847B
Q10: npn; BC847B
Q11: npn; BC847B
Q12: npn; BC847B
Q13: npn; BC847B
Q14: npn; BC847B
Q15: npn; BC847B
Q16: npn; BC847B
Q17: npn; BC847B
Q18: npn; BC847B
Q19: pnp; BC857B
Q20: pnp; BC857B
Q21: pnp; BC857B
R1: Res; 470k
R2: Res; 30
R3: Res; 30
R4: Res; 470k
R5: Res; 10k
R6: Res; 2k
R7: Res; 4.7k
R8: Res; 3k
R9: Res; 200
R10: Res; 100
R11: Res; 470
R12: Res; 2k
R13: Res; 3k
R14: Res; 200
R15: Res; 100
R16: Res; 200
R17: Res; 750
R18: Res; 470k
R19: Res; 470k
R20: Res; 30k
R21: Res; 3k
R22: Res; 130
R23: Res; 130
R24: Res; 130
R25: Res; 130
R26: Res; 100
R27: Res; 470
R28: Res; 750
R29: Res; 390
R30: Res; 470k
U1: 74LVC1GU04.asy
U2: 74LVC1GU04.asy
U3: LM13700
U4: LM13700
U5: 74LVC1GU04.asy
U6: 74LVC1GU04.asy
U7: 74LVC1GU04.asy
U8: 74LVC1GU04.asy
U9: 74LVC1GU04.asy
U10: 74LVC1GU04.asy
U11: 74LVC1GU04.asy
V1: voltage; 4.5
V2: Voltage; 2.25
V3: Voltage; PULSE(0 3.3 0 10n 10n 456n 932n)
V4: Voltage; 3.3
Named nets: 0, COM, VREF, ANT, DRIVE, DRVIN, SENSEN, SENSEP, SENSE, VCC33, REF, SENSE2
.tran 0 8m 10u 10n
