fpga-theremin/sensors/models/ltspice/vco_and_lc_drive/vco_and_lc_drive_v09_utf8.asc

C1: Cap; 1n
C4: Cap; 1n
C5: Cap; 1n
C6: Cap; 100p
C_ant: Cap; 10pF
I1: current; PWL(0u 50u 500u 50u 7500u 1000u)
I2: current; 700µ
L2: ind; 2mH; Rser=120 Cpar=1pF
Q25: pnp; BC857B
Q26: npn; BC847B
Q27: pnp; BC857B
Q28: pnp; BC857B
Q29: npn; BC847B
Q30: npn; BC847B
Q31: npn; BC847B
Q32: pnp; BC857B
Q33: pnp; BC857B
Q34: pnp; BC857B
Q35: pnp; BC857B
Q36: npn; BC847B
Q37: npn; BC847B
Q38: npn; BC847B
Q39: pnp; BC857B
Q47: npn; BC847B
Q48: npn; BC847B
Q49: npn; BC847B
Q50: npn; BC847B
Q51: pnp; BC857B
Q52: pnp; BC857B
Q53: pnp; BC857B
Q54: pnp; BC857B
Q63: pnp; BC857B
Q64: pnp; BC857B
Q65: pnp; BC857B
Q66: npn; BC847B
Q67: npn; BC847B
Q68: npn; BC847B
Q69: pnp; BC857B
Q105: npn; BC847B
R5: Res; 1k
R6: Res; 1k
R7: Res; 1k
R8: Res; 1k
R11: Res; 10k
R13: Res; 100
R15: Res; 100
R16: Res; 5.6
R17: Res; 470
R19: Res; 1
R23: Res; 100
R24: Res; 1
R25: Res; 24
R26: Res; 100
R27: Res; 15
R35: Res; 3
R52: Res; 10k
R53: Res; 100
U2: MCP6021
U3: MCP6021
U4: MCP6021
U5: MCP6021
U6: MCP6021
U555: LM13700
V1: voltage; 4.5
V2: Voltage; 2.25
V3: Voltage; 1.2
V4: Voltage; PWL file=/Users/vlopatin/projects/sensors/models/ltspice/vco_and_lc_drive/freq_sweep_100k_1500k.pwl
V5: Voltage; PWL file=freq_sweep_100k_1500k.pwl
Named nets: 0, COM, VREF, ANT, SENSE, VREF12, VCOBIAS11, VCOBIAS0, FSWEEP, GYR2, GYR1, VLIM5
.tran 0 8m 100u 10n
Theremin Current Sensing Oscillator with PLL.
Variable Frequency 
Bandpass Filter.
Has zero phase shift 
on middle frequency.
