fpga-theremin/sensors/models/ltspice/vco_and_lc_drive/vco_and_lc_drive_v18.asc

C1: Cap; 20p
C2: Cap; 20p
C_ant: Cap; 10pF
L2: ind; 2mH; Rser=120 Cpar=1pF
Q105: npn; BC847B
R1: Res; 150
R2: Res; 150
R3: Res; 5
R4: Res; 5
R5: Res; 1k
R6: Res; 4.7k
R7: Res; 4.7k
R8: Res; 4.7k
R9: Res; 150
R10: Res; 4.7k
R11: Res; 10k
R12: Res; 1000k
R13: Res; 200
R14: Res; 20
R15: Res; 4.7k
R16: Res; 10k
R17: Res; 1000k
R18: Res; 30
R19: Res; 100
R20: Res; 150
R21: Res; 4.7k
R35: Res; 3
R52: Res; 10k
R53: Res; 100
R54: Res; 3k
R58: Res; 1000k
R59: Res; 200
R60: Res; 1k
R61: Res; 150
R63: Res; 3k
R67: Res; 1000k
R69: Res; 4.7k
R70: Res; 150
R71: Res; 4.7k
R72: Res; 10k
R73: Res; 1000k
R74: Res; 30
R75: Res; 100
U1: LM13700
U2: MCP6021
U3: LM13700
U15: LM13700
U16: MCP6021
U17: LM13700
U18: MCP6021
U19: LM13700
V1: voltage; 4.5
V2: Voltage; 2.25
V3: Voltage; 1.2
V4: Voltage; PWL file=freq_sweep_100k_1500k.pwl
V5: Voltage; PWL(0 3 1m 3 8m 4.5)
V8: Voltage; PWL(0 2.25 1000u 2.25 8m 4.5)
Named nets: 0, COM, VREF, ANT, SENSE, VREF12, VCOBIAS0, DRV, CV, CV2, PT1, PT2, PT0, AMP0, BUF1, BUF2, PT00
.tran 0 8m 10u 10n
Theremin Current Sensing Oscillator with PLL.
Variable Frequency 
Bandpass Filter.
Has zero phase shift 
on middle frequency.
.ic V(PT1)=2.24
.ic V(PT2)=2.255
