fpga-theremin/sensors/models/ltspice/vco_bjt/vco_sine_bjt_v12.asc

C1: Cap; 1n
C2: Cap; 1000p
C3: Cap; 1n
C4: Cap; 1000p
C5: Cap; 2000p
C7: Cap; 4.7p
C8: Cap; 1n
C_ant2: Cap; 10pF
I1: current; PWL(0 70u 500u 70u 8m 700u)
I2: current; 400µ
L2: ind; 2mH; Rser=120 Cpar=1pF
Q10: pnp; BC857B
Q12: pnp; BC857B
Q23: pnp; BC857B
Q24: npn; BC847B
Q25: pnp; BC857B
Q26: npn; BC847B
Q27: npn; BC847B
Q28: npn; BC847B
Q29: npn; BC847B
Q30: pnp; BC857B
Q31: pnp; BC857B
Q32: pnp; BC857B
Q33: pnp; BC857B
Q34: npn; BC847B
Q35: npn; BC847B
Q36: npn; BC847B
Q37: pnp; BC857B
Q38: pnp; BC857B
Q39: pnp; BC857B
Q40: pnp; BC857B
Q41: npn; BC847B
Q42: npn; BC847B
Q43: npn; BC847B
Q44: npn; BC847B
Q45: npn; BC847B
Q46: npn; BC847B
Q47: npn; BC847B
Q48: npn; BC847B
Q49: npn; BC847B
Q50: npn; BC847B
Q51: npn; BC847B
Q52: npn; BC847B
Q53: npn; BC847B
Q54: npn; BC847B
Q56: npn; BC847B
Q57: npn; BC847B
Q58: npn; BC847B
Q59: pnp; BC857B
Q60: pnp; BC857B
Q61: pnp; BC857B
Q62: pnp; BC857B
Q63: npn; BC847B
Q64: npn; BC847B
Q65: npn; BC847B
Q66: npn; BC847B
Q67: pnp; BC857B
Q68: pnp; BC857B
Q69: npn; BC847B
Q70: npn; BC847B
Q71: npn; BC847B
Q72: npn; BC847B
Q73: pnp; BC857B
Q74: pnp; BC857B
Q75: npn; BC847B
Q76: pnp; BC857B
R2: Res; 10
R3: Res; 10
R7: Res; 100
R8: Res; 100
R10: Res; 100
R11: Res; 100
R12: Res; 100
R13: Res; 100
R15: Res; 100
R17: Res; 100
R18: Res; 100
R19: Res; 100
R20: Res; 220
R21: Res; 100
R22: Res; 3.9
R26: Res; 470
R27: Res; 100
R28: Res; 470
R29: Res; 100
R30: Res; 10k
R33: Res; 360
R34: Res; 15
R35: Res; 4.7
R60: Res; 22k
U2: MCP6021
V1: voltage; 4.5
V2: Voltage; 2.25
Named nets: 0, COM, VREF, VCOBIAS1, VCOBIAS2, VCOBIAS0, PT1, PT2, BIAS_N, BIAS_P, ANT, SENSE, DRIVE, SNSDIV
.tran 0 12m 100u 5n
Wide frequency range VCO for Theremin AFE
.ic V(PT1)=2.245
.ic V(PT2)=2.255
Unity gain output buffer - operational amplifier with current feedback
