fpga-theremin/sensors/models/ltspice/dlev_afe/current_sensing_oscillator_square_drive_v01.asc

A1: adcmp601.asy
C1: Cap; 10n
C2: Cap; 1n
C3: Cap; 22p
C4: Cap; 100n
C5: Cap; 10p
C_ant: Cap; 10pF
L1: ind; 2mH; Rser=120 Cpar=1pF
Q1: pnp; BC857B
Q2: pnp; BC857B
Q3: pnp; BC857B
Q4: pnp; BC857B
Q5: npn; BC847B
Q6: npn; BC847B
Q7: npn; BC847B
Q8: npn; BC847B
Q9: pnp; BC857B
Q10: pnp; BC857B
Q11: pnp; BC857B
Q12: pnp; BC857B
Q13: npn; BC847B
Q14: npn; BC847B
Q15: npn; BC847B
Q16: npn; BC847B
Q17: npn; BC847B
Q18: npn; BC847B
Q19: npn; BC847B
Q20: npn; BC847B
Q21: npn; BC847B
Q22: npn; BC847B
R1: Res; 1k
R2: Res; 47k
R3: Res; 200k
R4: Res; 2
R5: Res; 4.7
R6: Res; 470
R7: Res; 4.7
R8: Res; 47k
R9: Res; 47k
R10: Res; 2
R11: Res; 47k
R12: Res; 1k
R13: Res; 1k
R14: Res; 100
U2: 74LVC1GU04.asy
U4: 74LVC1GU04.asy
U5: 74LVC1GU04.asy
U8: 74LVC1GU04.asy
V3: Voltage; 3.3
V4: Voltage; PULSE(0.1 3.2 0 10n 10n 456n 932n)
Named nets: OUT_FB, 0, VCC33, ANT, DRIVE, DRVIN, DRVINBUF, SNSN, SNSP, SENSE, OUT_SENSE, VREF
Ref Drive: output buffer
.tran 0 2.1m 0n 1n
.ic I(L1)=0.001u
Current mirror based
current sensor with integrator
(adds 90 degrees phase shift)
Sense sine to square 
comparator
Current Sensing Analog Front End for D-Lev Theremin
