fpga-theremin/sensors/models/ltspice/dlev_afe/dlev_afe_and_4046_pll_v01.asc

A1: adcmp601.asy
C1: Cap; 1000pF
C2: Cap; 470p
C3: Cap; 22p
C4: Cap; 10n
C5: Cap; 1n
C6: Cap; 1n
C8: Cap; 20n
C9: Cap; 100p
C10: Cap; 100p
C_ant: Cap; 10pF
L1: ind; 2mH; Rser=120 Cpar=1pF
Q1: pnp; BC857B
Q2: pnp; BC857B
Q3: pnp; BC857B
Q4: pnp; BC857B
Q5: npn; BC847B
Q6: npn; BC847B
Q7: npn; BC847B
Q8: npn; BC847B
Q9: pnp; BC857B
Q10: pnp; BC857B
Q11: npn; BC847B
Q12: npn; BC847B
R1: Res; 20k
R2: Res; 12k
R3: Res; 200k
R4: Res; 4.7
R5: Res; 20
R6: Res; 10k
R7: Res; 20
R8: Res; 10k
R9: Res; 10k
R10: Res; 4.7
R12: Res; 10k
R13: Res; 100k
R15: Res; 24k
R16: Res; 24k
R19: Res; 20k
R20: Res; 20k
U1: MCP6021
U4: 74LVC1GU04.asy
U5: 74LVC1GU04.asy
U666: 74HC4046TI.asy
V3: Voltage; 5
Named nets: 0, ANT, DRIVE, DRVINBUF, SNSN, SNSP, SENSE, OUT_SENSE, VCOCTL, VDEMOUT, PC1, INH, COM, SENSEFLT
.tran 0 2.1m 0n 1n
.ic I(L1)=0.001u
Current mirror based
current sensor with integrator
(adds 90 degrees phase shift)
Current Sensing (Wallin) LC Oscillator with PLL
Phase error filter
Drive Buffer
PLL
Sense sine to square 
comparator
(self-biasing)
Sense signal average point (LP) filter
