fpga-theremin/sensors/kicad/rp2350_dds_curr_sense_theremin_sensor/RP2350_DDS_curr_sensing_sensor.kicad_pcb

## KiCad design kicad/rp2350_dds_curr_sense_theremin_sensor/RP2350_DDS_curr_sensing_sensor.kicad_pcb (2026-03-31)

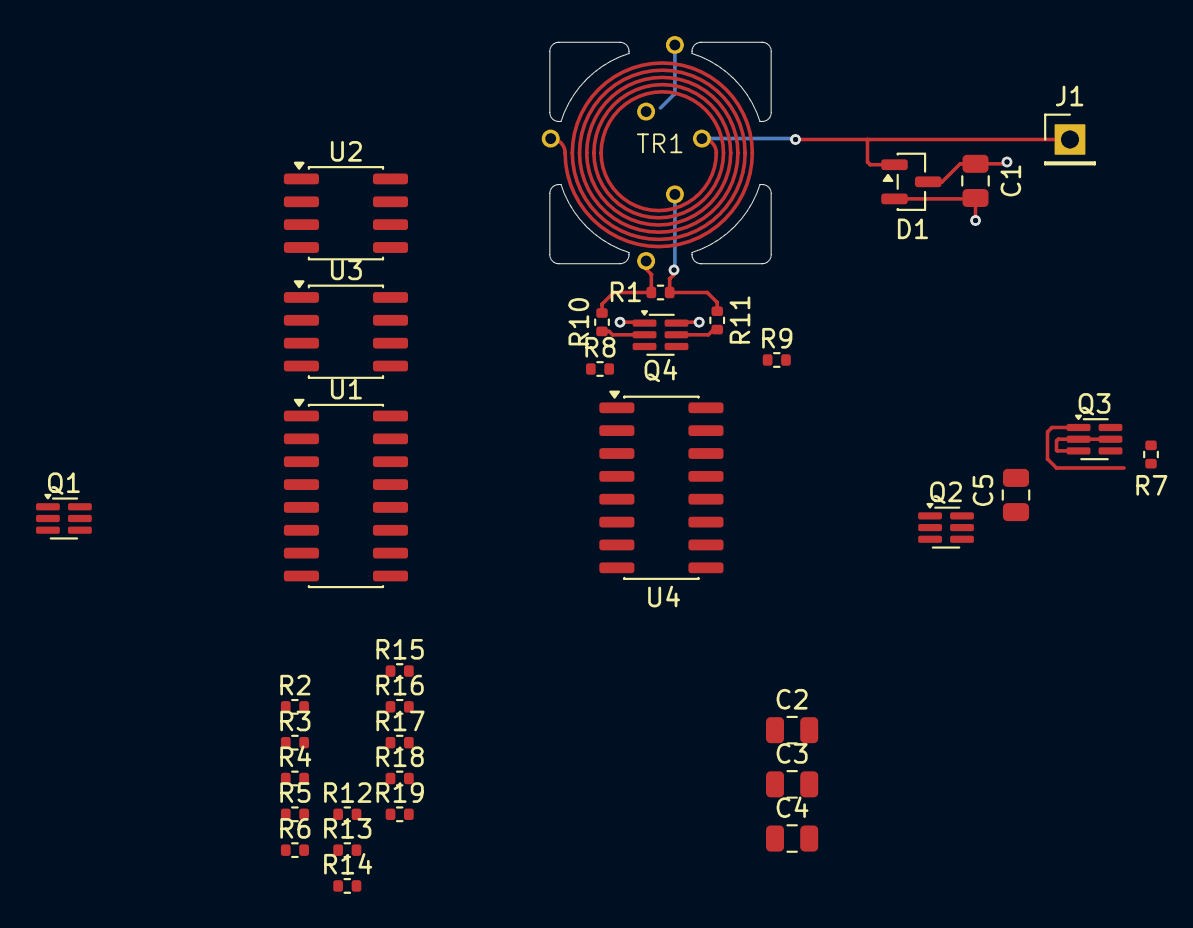
[picture p119: board RP2350_DDS_curr_sensing_sensor.kicad_pcb from above]

Board: 4 copper layers, 35 parts (0 on the bottom side), 28 nets.

Parts:
C1, C2, C3, C5: 220n; C_0805_2012Metric
C4: 22n; C_0805_2012Metric
D1: CM1213A-01SO; SOT-23
J1: Conn_Inductor; PinHeader_1x01_P2.54mm_Vertical
Q1, Q2, Q3, Q4: BCM857BS; SOT-363_SC-70-6
R1, R3, R4, R5, R6: 100; R_0402_1005Metric
R2, R7, R12, R13: 4.7k; R_0402_1005Metric
R8, R9: 10; R_0402_1005Metric
R10, R11: 1; R_0402_1005Metric
R14, R15, R16: 10k; R_0402_1005Metric
R17, R18, R19: 200; R_0402_1005Metric
TR1: TRANSF3A; CurrSensTrans3
U1, U4: LM13700; SOIC-16_3.9x9.9mm_P1.27mm
U2: LMH6643MAX; SOIC-8_3.9x4.9mm_P1.27mm
U3: MCP6022T; SOIC-8_3.9x4.9mm_P1.27mm

Connections:
/Sensor_AFE/LC_DRV: D1.1 (CH1), J1.1, TR1.1
/Sensor_AFE/MBIASN: Q4.6 (C1), U4.1
/Sensor_AFE/MBIASP: Q4.3 (C2), U4.16
/Sensor_AFE/SBIAS: Q3.2 (B1), Q3.3 (C2), Q3.5 (B2), R7.2
/Sensor_AFE/SBN: Q4.2 (B1), R10.2
/Sensor_AFE/SBP: Q4.5 (B2), R11.2
/Sensor_AFE/SEN: Q4.1 (E1), R8.2
/Sensor_AFE/SENSEN: R1.1, R10.1, TR1.6
/Sensor_AFE/SENSEP: R1.2, R11.1, TR1.3
/Sensor_AFE/SEP: Q4.4 (E2), R9.1
/Sensor_AFE/VREF: TR1.4, TR1.5
GND: C1.2, C2.2, C3.2, C4.2, C5.2, D1.3 (VN), Q2.6 (C1), R2.1, R7.1, R17.2, R18.2, R19.2, U1.6 (V-), U4.6 (V-)
unnamed: C4.1, U4.5, U4.12
unnamed: Q1.2 (B1), Q1.3 (C2), Q1.5 (B2), R2.2
unnamed: Q1.6 (C1), R3.1, R4.2
unnamed: Q2.2 (B1), R6.2
unnamed: Q2.1 (E1), R4.1
unnamed: Q2.5 (B2), R5.1
unnamed: Q2.4 (E2), R3.2
unnamed: Q3.6 (C1), R8.1, R9.2
unnamed: R13.1, U1.15 (DIODE_BIAS)
unnamed: R12.1, U1.2 (DIODE_BIAS)
unnamed: R19.1, U4.14 (+)
unnamed: R16.1, R17.1, U4.3 (+), U4.13 (-)
unnamed: R15.1, U4.15 (DIODE_BIAS)
unnamed: R18.1, U4.4 (-)
unnamed: R14.1, U4.2 (DIODE_BIAS)
VDDA: C1.1, C2.1, C3.1, C5.1, D1.2 (VP), Q1.1 (E1), Q1.4 (E2), Q3.1 (E1), Q3.4 (E2), R12.2, R13.2, R14.2, R15.2, U1.11 (V+), U4.11 (V+)
