fpga-theremin/sensors/fpga_sensor/firmware/hdl/sin_cos_table_4096_13bit.v

/*********************************************/
/* SINE table of size 4096 and 13-bit values */
/* Latency: 4 CLK cycles                     */
/*********************************************/
module sin_cos_table_4096_13bit #(
    parameter DATA_WIDTH = 13,
    parameter ADDR_WIDTH = 12
)
(
    /* input clock                                           */
    input wire CLK,
    /* clock enable, 1 = enable pipeline, 0 = pause pipeline */
    input wire CE,
    /* reset signal, active 1                                */
    input wire RESET,
    
    /* sine table address to get value from                  */
    input wire [ADDR_WIDTH-1:0] PHASE,
    /* sin sample value from ROM, delayed by 4 clock cycles */
    output wire [DATA_WIDTH-1:0] SIN_VALUE,
    /* cos sample value from ROM, delayed by 4 clock cycles */
    output wire [DATA_WIDTH-1:0] COS_VALUE
    
);
    
    
    /* ROM size: we need to store only 1/4 of table entries, the rest may be obtained by mirroring and changing the sign */
    localparam MEMSIZE = 1 << (ADDR_WIDTH - 2);
    
    /* first quarter of table always has 0 in upper bit, so we can store only DATA_WIDTH-1 bits in the table */
    (* ram_style = "block" *)  
    reg [DATA_WIDTH-2:0] memory[0:MEMSIZE-1];
           
    /* store input phase value in register */
    reg [ADDR_WIDTH-1:0] phase_stage0;
    always @(posedge CLK)
        if (RESET)
            phase_stage0 <= 0;
        else if (CE)
            phase_stage0 <= PHASE;
     
    wire [1:0] sin_phase_top = phase_stage0[ADDR_WIDTH-1:ADDR_WIDTH-2];
    wire [1:0] cos_phase_top = phase_stage0[ADDR_WIDTH-1:ADDR_WIDTH-2] + 1;
     
    /* second half of table is the same as first, but negative */
    wire sin_need_sign_change = sin_phase_top[1];
    /* second and third quarters of table are mirrored by phase */
    wire sin_need_phase_inverse = sin_phase_top[0];
     
    /* second half of table is the same as first, but negative */
    wire cos_need_sign_change = cos_phase_top[1];
    /* second and third quarters of table are mirrored by phase */
    wire cos_need_phase_inverse = cos_phase_top[0];
     
    /* SIN: invert phase to have mirrored value */
    wire [ADDR_WIDTH-3:0] sin_table_entry_index = phase_stage0[ADDR_WIDTH-3:0] ^ { (ADDR_WIDTH-2) {sin_need_phase_inverse} };
    /* COS: invert phase to have mirrored value */
    wire [ADDR_WIDTH-3:0] cos_table_entry_index = phase_stage0[ADDR_WIDTH-3:0] ^ { (ADDR_WIDTH-2) {cos_need_phase_inverse} };
     
    /* propagate sign change flag to support negative values */
    reg sin_need_sign_change_stage1;
    reg cos_need_sign_change_stage1;
    reg sin_need_sign_change_stage2;
    reg cos_need_sign_change_stage2;
     
    always @(posedge CLK)
        if (RESET) begin
            sin_need_sign_change_stage1 <= 0;
            sin_need_sign_change_stage2 <= 0;
            cos_need_sign_change_stage1 <= 0;
            cos_need_sign_change_stage2 <= 0;
        end else if (CE) begin
            sin_need_sign_change_stage1 <= sin_need_sign_change;
            sin_need_sign_change_stage2 <= sin_need_sign_change_stage1;
            cos_need_sign_change_stage1 <= cos_need_sign_change;
            cos_need_sign_change_stage2 <= cos_need_sign_change_stage1;
        end
            
    /* SIN table: block RAM based ROM - first stage of pipeline */
    reg [DATA_WIDTH-2:0] sin_rddata_stage1;
    always @(posedge CLK)
        if (RESET)
            sin_rddata_stage1 <= 0;
        else if (CE)
            sin_rddata_stage1 <= memory[sin_table_entry_index];
     
    /* COS table: block RAM based ROM - first stage of pipeline */
    reg [DATA_WIDTH-2:0] cos_rddata_stage1;
    always @(posedge CLK)
        if (RESET)
            cos_rddata_stage1 <= 0;
        else if (CE)
            cos_rddata_stage1 <= memory[cos_table_entry_index];
     
    /* SIN table: block RAM based ROM - second stage of pipeline */
    reg [DATA_WIDTH-2:0] sin_rddata_stage2;
    always @(posedge CLK)
        if (RESET)
            sin_rddata_stage2 <= 0;
        else if (CE)
            sin_rddata_stage2 <= sin_rddata_stage1;
     
    /* COS table: block RAM based ROM - second stage of pipeline */
    reg [DATA_WIDTH-2:0] cos_rddata_stage2;
    always @(posedge CLK)
        if (RESET)
            cos_rddata_stage2 <= 0; 
        else if (CE)
            cos_rddata_stage2 <= cos_rddata_stage1;
     
    /* SIN: this is output stage register, need sign bit as well */
    reg [DATA_WIDTH-1:0] sin_rddata_stage3;
    always @(posedge CLK)
        if (RESET)
            sin_rddata_stage3 <= 0; 
        else if (CE)
            sin_rddata_stage3 <= sin_need_sign_change_stage2 ? -{1'b0, sin_rddata_stage2} : {1'b0, sin_rddata_stage2}; 
     
    /* COS: this is output stage register, need sign bit as well */
    reg [DATA_WIDTH-1:0] cos_rddata_stage3;
    always @(posedge CLK)
        if (RESET)
            cos_rddata_stage3 <= 0; 
        else if (CE)
            cos_rddata_stage3 <= cos_need_sign_change_stage2 ? -{1'b0, cos_rddata_stage2} : {1'b0, cos_rddata_stage2}; 
     
    /* propagate value to output */
    assign SIN_VALUE = sin_rddata_stage3;
    assign COS_VALUE = cos_rddata_stage3;
    

    /* Initialization of ROM content with first quarter of SINE function */
    initial begin
        memory[0] = 3;
        memory[1] = 9;
        memory[2] = 16;
        memory[3] = 22;
        memory[4] = 28;
        memory[5] = 35;
        memory[6] = 41;
        memory[7] = 47;
        memory[8] = 53;
        memory[9] = 60;
        memory[10] = 66;
        memory[11] = 72;
        memory[12] = 79;
        memory[13] = 85;
        memory[14] = 91;
        memory[15] = 97;
        memory[16] = 104;
        memory[17] = 110;
        memory[18] = 116;
        memory[19] = 122;
        memory[20] = 129;
        memory[21] = 135;
        memory[22] = 141;
        memory[23] = 148;
        memory[24] = 154;
        memory[25] = 160;
        memory[26] = 166;
        memory[27] = 173;
        memory[28] = 179;
        memory[29] = 185;
        memory[30] = 192;
        memory[31] = 198;
        memory[32] = 204;
        memory[33] = 210;
        memory[34] = 217;
        memory[35] = 223;
        memory[36] = 229;
        memory[37] = 235;
        memory[38] = 242;
        memory[39] = 248;
        memory[40] = 254;
        memory[41] = 261;
        memory[42] = 267;
        memory[43] = 273;
        memory[44] = 279;
        memory[45] = 286;
        memory[46] = 292;
        memory[47] = 298;
        memory[48] = 304;
        memory[49] = 311;
        memory[50] = 317;
        memory[51] = 323;
        memory[52] = 329;
        memory[53] = 336;
        memory[54] = 342;
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
        memory[1015] = 4095;
        memory[1016] = 4095;
        memory[1017] = 4095;
        memory[1018] = 4095;
        memory[1019] = 4095;
        memory[1020] = 4095;
        memory[1021] = 4095;
        memory[1022] = 4095;
        memory[1023] = 4095;
    end

endmodule
