fpga-theremin/sensors/fpga_sensor/firmware/tb/sin_cos_table_4096_13bit_tb.sv

/*********************************************/
/* SINE table of size 4096 and 13-bit values */
/* Latency: 4 CLK cycles                     */
/* TESTBENCH                                 */
/*********************************************/
`timescale 1ns / 1ps
module sin_cos_table_4096_13bit_tb ();

localparam     DATA_WIDTH = 13;
localparam     ADDR_WIDTH = 12;


    logic [15:0] cycleCounter = 0;
    logic CLK;
    logic CE;
    logic RESET;
    logic [ADDR_WIDTH-1:0] PHASE;
    wire signed [DATA_WIDTH-1:0] SIN_VALUE;
    wire signed [DATA_WIDTH-1:0] COS_VALUE;
    
    sin_cos_table_4096_13bit
    #(
        .DATA_WIDTH(DATA_WIDTH),
        .ADDR_WIDTH(ADDR_WIDTH)
    )
    sin_table_instance
    (
        .*
    );
    
    // drive CLK
    always begin
        #1.472 CLK=0;
        #1.472 CLK=1; 
        cycleCounter = cycleCounter + 1;
    end
    
    task nextCycle(input [ADDR_WIDTH-1:0] phase);
         begin
             @(posedge CLK) #1 ;
             PHASE = phase;
             $display("    [%d]   nextCycle PHASE=%d", cycleCounter, PHASE);
         end
    endtask
     
    task checkResult(input signed [DATA_WIDTH-1:0] expected_sin_value, input signed [DATA_WIDTH-1:0] expected_cos_value);
         begin
             $display("    [%d]             SIN=%d COS=%d", cycleCounter, SIN_VALUE, COS_VALUE);
             if (SIN_VALUE != expected_sin_value) begin
                 $display("    [%d] ERROR: SIN_VALUE does not match with expected result, expected %x actual %x", cycleCounter, expected_sin_value, SIN_VALUE);
                 $finish();
             end
             if (COS_VALUE != expected_cos_value) begin
                 $display("    [%d] ERROR: COS_VALUE does not match with expected result, expected %x actual %x", cycleCounter, expected_cos_value, COS_VALUE);
                 $finish();
             end
         end
    endtask
     
    // reset condition
    initial begin
        RESET = 0;
        CE = 0;
        #200 @(posedge CLK) RESET = 1;
        #100 @(posedge CLK) RESET = 0;
        @(posedge CLK) #1 CE = 1;
        PHASE = 0;
     
        $display("Starting verification");
    

        /* Outputs are delayed by 4 clock cycles */
        nextCycle(0);
        nextCycle(1);
        nextCycle(2);
        nextCycle(3);
        nextCycle(4); checkResult(3, 4095);
        nextCycle(5); checkResult(9, 4095);
        nextCycle(6); checkResult(16, 4095);
        nextCycle(7); checkResult(22, 4095);
        nextCycle(8); checkResult(28, 4095);
        nextCycle(9); checkResult(35, 4095);
        nextCycle(10); checkResult(41, 4095);
        nextCycle(11); checkResult(47, 4095);
        nextCycle(12); checkResult(53, 4095);
        nextCycle(13); checkResult(60, 4095);
        nextCycle(14); checkResult(66, 4094);
        nextCycle(15); checkResult(72, 4094);
        nextCycle(16); checkResult(79, 4094);
        nextCycle(17); checkResult(85, 4094);
        nextCycle(18); checkResult(91, 4094);
        nextCycle(19); checkResult(97, 4094);
        nextCycle(20); checkResult(104, 4094);
        nextCycle(21); checkResult(110, 4094);
        nextCycle(22); checkResult(116, 4093);
        nextCycle(23); checkResult(122, 4093);
        nextCycle(24); checkResult(129, 4093);
        nextCycle(25); checkResult(135, 4093);
        nextCycle(26); checkResult(141, 4093);
        nextCycle(27); checkResult(148, 4092);
        nextCycle(28); checkResult(154, 4092);
        nextCycle(29); checkResult(160, 4092);
        nextCycle(30); checkResult(166, 4092);
        nextCycle(31); checkResult(173, 4091);
        nextCycle(32); checkResult(179, 4091);
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
        nextCycle(2360); checkResult(-1866, -3645);
        nextCycle(2361); checkResult(-1872, -3642);
        nextCycle(2362); checkResult(-1878, -3639);
        nextCycle(2363); checkResult(-1883, -3636);
        nextCycle(2364); checkResult(-1889, -3633);
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
