fpga-theremin/sensors/fpga_sensor/firmware/hdl/adc_dac_frontend.v

/*

   FPGA based current sensing SDR theremin sensor.
    
   High frequency part - pipeline updated for each ADC sample.

 */
module adc_dac_frontend
#(
    parameter PHASE_BITS = 32,
    parameter PHASE_INCREMENT_BITS = 28,
    parameter PHASE_INCREMENT_FILTER_SHIFT_BITS = 5,
    parameter PHASE_INCREMENT_FILTER_STAGE_COUNT = 2,
    parameter PHASE_INCREMENT_FEEDBACK_FILTER_SHIFT_BITS = 4,
    parameter PHASE_INCREMENT_FEEDBACK_FILTER_STAGE_COUNT = 2,
    parameter SIN_TABLE_DATA_WIDTH = 13,
    parameter SIN_TABLE_ADDR_WIDTH = 12,
    // specify init file to SIN table ROM with
    parameter SIN_ROM_INIT_FILE = "sin_table_4096_13bit.mem",
    parameter ADC_DATA_WIDTH = 12,
    parameter DAC_DATA_WIDTH = 12,
    parameter MUL_ACC_WIDTH = 32,
    // 1 to enable accumulation of values for one ADC period (zero crossing detection)
    //   in this case set RESULT_WIDTH=32 for iCE40 platform since it has 32-bit accumulator in DSP 
    // 0 to output multiplicatoin result values directly, without additional accumulation - to let LP filters do averaging
    //   in this case, set RESULT_WIDTH=SIN_TABLE_DATA_WIDTH+ADC_DATA_WIDTH 
    parameter PERIOD_ACC_ENABLE = 1,
    // if RESULT_MUL_ACC_WIDTH>MUL_ACC_WIDTH, result LP filter introduces additional bits from averaging
    parameter RESULT_MUL_ACC_WIDTH = 36,
    parameter RESULT_FILTER_SHIFT_BITS = 5,
    parameter RESULT_FILTER_STAGE_COUNT = 3
)
(
    /* input clock                                           */
    input wire CLK,
    /* clock enable, 1 = enable pipeline, 0 = pause pipeline */
    input wire CE,
    /* reset signal, active 1                                */
    input wire RESET,

    /* new phase increment value */
    input wire [PHASE_INCREMENT_BITS-1:0] PHASE_INCREMENT_IN,

    /* input sample from ADC */
    input wire signed [ADC_DATA_WIDTH-1:0] ADC_VALUE,
    /* output sample for DAC */
    output wire signed [DAC_DATA_WIDTH-1:0] DAC_VALUE,

    /* filtered smoothly changing mul-acc value for ADC*SIN */
    output wire signed [RESULT_MUL_ACC_WIDTH-1:0] SIN_MUL_ACC,
    /* filtered smoothly changing mul-acc value for ADC*COS */
    output wire signed [RESULT_MUL_ACC_WIDTH-1:0] COS_MUL_ACC,

    /* current phase increment value - filtered feedback */
    output wire [PHASE_INCREMENT_BITS-1:0] CURRENT_PHASE_INCREMENT


//    , output wire signed [MUL_ACC_WIDTH-1:0] debug_sin_mul_acc_for_last_period
//    , output wire signed [MUL_ACC_WIDTH-1:0] debug_cos_mul_acc_for_last_period

);


// filter PHASE_INCREMENT_IN to provide smooth frequency changes
wire [PHASE_INCREMENT_BITS-1:0] phase_inc_filtered;

lp_filter
#(
    .IN_DATA_BITS(PHASE_INCREMENT_BITS),
    .OUT_DATA_BITS(PHASE_INCREMENT_BITS),
    .SHIFT_BITS(PHASE_INCREMENT_FILTER_SHIFT_BITS),
    .STAGE_COUNT(PHASE_INCREMENT_FILTER_STAGE_COUNT)
)
lp_filter_phase_inc_input_inst
(
    .CLK(CLK),
    .CE(CE),
    .RESET(RESET),

    .IN_VALUE(PHASE_INCREMENT_IN),
    .OUT_VALUE(phase_inc_filtered)
);


wire [SIN_TABLE_DATA_WIDTH-1:0] sin_table_value;
wire [SIN_TABLE_DATA_WIDTH-1:0] cos_table_value;

sin_cos_dco
#(
    .PHASE_BITS(PHASE_BITS),
    .PHASE_INCREMENT_BITS(PHASE_INCREMENT_BITS),
    .SIN_TABLE_DATA_WIDTH(SIN_TABLE_DATA_WIDTH),
    .SIN_TABLE_ADDR_WIDTH(SIN_TABLE_ADDR_WIDTH),
    .SIN_ROM_INIT_FILE("sin_table_4096_13bit.mem")
)
dco_inst
(
    .CLK(CLK),
    .CE(CE),
    .RESET(RESET),

    /* new phase increment value */
    .PHASE_INCREMENT_IN(phase_inc_filtered),
    /* 1 to set new value for phase increment */
    .PHASE_INCREMENT_IN_WE(CE),

    /* SIN value output */
    .SIN_VALUE(sin_table_value),
    /* COS value output */
    .COS_VALUE(cos_table_value)
);

assign DAC_VALUE = sin_table_value[SIN_TABLE_DATA_WIDTH-1:(SIN_TABLE_DATA_WIDTH-DAC_DATA_WIDTH)];

/* mul-acc value for ADC*SIN */
wire signed [MUL_ACC_WIDTH-1:0] sin_mul_acc_for_last_period;
/* mul-acc value for ADC*COS  */
wire signed [MUL_ACC_WIDTH-1:0] cos_mul_acc_for_last_period;

//assign debug_sin_mul_acc_for_last_period = sin_mul_acc_for_last_period;
//assign debug_cos_mul_acc_for_last_period = cos_mul_acc_for_last_period;

quadrature_mul_acc
#(
    .SIN_TABLE_DATA_WIDTH(SIN_TABLE_DATA_WIDTH),
    .ADC_DATA_WIDTH(ADC_DATA_WIDTH),
    .PERIOD_ACC_ENABLE(PERIOD_ACC_ENABLE),
    .RESULT_WIDTH(MUL_ACC_WIDTH)
)
quadrature_mul_acc_inst
(
    .CLK(CLK),
    .CE(CE),
    .RESET(RESET),

    .SIN_VALUE(sin_table_value),
    .COS_VALUE(cos_table_value),
    /* value from ADC */
    .ADC_VALUE(ADC_VALUE),

    /* 1 if SIN_RESULT and COS_RESULT updated with new value */
    .UPDATED_RESULT(),
    /* mul-acc value for ADC*SIN */
    .SIN_RESULT(sin_mul_acc_for_last_period),
    /* mul-acc value for ADC*COS  */
    .COS_RESULT(cos_mul_acc_for_last_period)
);


/* mul-acc value for ADC*SIN */
wire signed [RESULT_MUL_ACC_WIDTH-1:0] sin_mul_acc_filtered;
/* mul-acc value for ADC*COS  */
wire signed [RESULT_MUL_ACC_WIDTH-1:0] cos_mul_acc_filtered;

assign SIN_MUL_ACC = sin_mul_acc_filtered;
assign COS_MUL_ACC = cos_mul_acc_filtered;

lp_filter_signed
#(
    .IN_DATA_BITS(MUL_ACC_WIDTH),
    .OUT_DATA_BITS(RESULT_MUL_ACC_WIDTH),
    .SHIFT_BITS(RESULT_FILTER_SHIFT_BITS),
    .STAGE_COUNT(RESULT_FILTER_STAGE_COUNT)
)
lp_filter_sin_mul_acc_inst
(
    .CLK(CLK),
    .CE(CE),
    .RESET(RESET),

    .IN_VALUE(sin_mul_acc_for_last_period),
    .OUT_VALUE(sin_mul_acc_filtered)
);

lp_filter_signed
#(
    .IN_DATA_BITS(MUL_ACC_WIDTH),
    .OUT_DATA_BITS(RESULT_MUL_ACC_WIDTH),
    .SHIFT_BITS(RESULT_FILTER_SHIFT_BITS),
    .STAGE_COUNT(RESULT_FILTER_STAGE_COUNT)
)
lp_filter_cos_mul_acc_inst
(
    .CLK(CLK),
    .CE(CE),
    .RESET(RESET),

    .IN_VALUE(cos_mul_acc_for_last_period),
    .OUT_VALUE(cos_mul_acc_filtered)
);

// filter PHASE_INCREMENT_IN to provide smooth frequency changes
wire [PHASE_INCREMENT_BITS-1:0] phase_inc_feedback_filtered;

lp_filter
#(
    .IN_DATA_BITS(PHASE_INCREMENT_BITS),
    .OUT_DATA_BITS(PHASE_INCREMENT_BITS),
    .SHIFT_BITS(PHASE_INCREMENT_FEEDBACK_FILTER_SHIFT_BITS),
    .STAGE_COUNT(PHASE_INCREMENT_FEEDBACK_FILTER_STAGE_COUNT)
)
lp_filter_phase_increment_feedback_inst
(
    .CLK(CLK),
    .CE(CE),
    .RESET(RESET),

    .IN_VALUE(phase_inc_filtered),
    .OUT_VALUE(phase_inc_feedback_filtered)
);

assign CURRENT_PHASE_INCREMENT = phase_inc_feedback_filtered;

endmodule
