fpga-theremin/sensors/fpga_sensor/firmware/tb/cordic_sin_cos_tb.sv

module cordic_sin_cos_tb();

localparam DATA_BITS = 16;
localparam STEP1_PHASE_BITS = 8;
localparam STEP2_PHASE_BITS = 9;
localparam PHASE_BITS = 3 + STEP1_PHASE_BITS + STEP2_PHASE_BITS; // module adc_dac_frontend
localparam LATENCY = 2 + STEP2_PHASE_BITS + 1;
localparam EXTRA_DATA_BITS = 5;

logic [PHASE_BITS:0] cycleCounter = 0;
logic CLK;
logic CE;
logic RESET;

logic [PHASE_BITS-1:0] PHASE;
wire [PHASE_BITS-1:0] PHASE_DELAYED;

fixed_delay_shift_register
#(
    .DATA_BITS(PHASE_BITS),
    .DELAY_CYCLES(LATENCY)
)
fixed_delay_shift_register_inst
(
    .CLK(CLK),
    .CE(CE),
    .RESET(RESET),
    .IN_VALUE(PHASE),
    .OUT_VALUE(PHASE_DELAYED)
);

wire signed [DATA_BITS-1:0] SIN;
wire signed [DATA_BITS-1:0] COS;

wire debug_swap_sin_and_cos_delayed;
wire debug_neg_sin_delayed;
wire debug_neg_cos_delayed;
wire [PHASE_BITS-1:0] debug_PHASE;
wire [STEP1_PHASE_BITS-1:0] debug_step1_lookup_addr;
wire [STEP2_PHASE_BITS-1:0] debug_step2_lookup_addr;

cordic_sin_cos #(
    .DATA_BITS(DATA_BITS),
    .PHASE_BITS(PHASE_BITS),
    .STEP1_PHASE_BITS(STEP1_PHASE_BITS),
    .STEP2_PHASE_BITS(STEP2_PHASE_BITS),
    .EXTRA_DATA_BITS(EXTRA_DATA_BITS)
) 
cordic_sin_cos_inst 
(
    .CLK(CLK),
    .CE(CE),
    .RESET(RESET),
    .*
);

real sin_expected = 0;
real cos_expected = 0;
real sin_diff = 0;
real cos_diff = 0;
real abs_sin_diff = 0;
real abs_cos_diff = 0;
real sum_sin_diff = 0;
real sum_cos_diff = 0;
real sum_abs_sin_diff = 0;
real sum_abs_cos_diff = 0;
real max_abs_sin_diff = 0;
real max_abs_cos_diff = 0;
int errorCount = 0;
int bigSinDiffCount = 0;
int bigCosDiffCount = 0;

localparam PI = 3.14159265359;
task nextCycle();
     begin
         @(posedge CLK) #1 PHASE = PHASE + 1;
         sin_expected = ($sin((PHASE_DELAYED+0.5)*2*PI/(1<<(PHASE_BITS)))*32767);
         cos_expected = ($cos((PHASE_DELAYED+0.5)*2*PI/(1<<(PHASE_BITS)))*32767);
         sin_diff = SIN-sin_expected;
         cos_diff = COS-cos_expected;
         abs_sin_diff = sin_diff < 0 ? -sin_diff : sin_diff;
         abs_cos_diff = cos_diff < 0 ? -cos_diff : cos_diff;
         if (PHASE > LATENCY) begin
             sum_sin_diff = sum_sin_diff + sin_diff;
             sum_cos_diff = sum_cos_diff + cos_diff;
             sum_abs_sin_diff = sum_abs_sin_diff + (sin_diff < 0 ? -sin_diff : sin_diff);
             sum_abs_cos_diff = sum_abs_cos_diff + (cos_diff < 0 ? -cos_diff : cos_diff);
             if (max_abs_cos_diff < abs_cos_diff)
                 max_abs_cos_diff = abs_cos_diff;
             if (max_abs_sin_diff < abs_sin_diff)
                 max_abs_sin_diff = abs_sin_diff;
             if (abs_sin_diff >= 0.5)
                 bigSinDiffCount = bigSinDiffCount + 1;
             if (abs_cos_diff >= 0.5)
                 bigCosDiffCount = bigCosDiffCount + 1;
             if (sin_diff > 1 || cos_diff > 1 ||  sin_diff < -1 || cos_diff < -1) begin 
                 $display("    [%d]   nextCycle PHASE=%h  PHASE_DELAYED=%h  SIN=%d COS=%d  sin_diff=%f (%f) cos_diff=%f (%f)    phase=%f", cycleCounter, PHASE, PHASE_DELAYED, SIN, COS, 
                     sin_diff, sin_expected, 
                     cos_diff, cos_expected,
                     PHASE_DELAYED*2*PI/(1<<(PHASE_BITS)) );
                 errorCount = errorCount + 1;
                 if (errorCount > 20)
                     $finish();
             end
         end
     end
endtask

// drive CLK
always begin
    #1.472 CLK=0;
    #1.472 CLK=1; 
    cycleCounter = cycleCounter + 1;
end



initial begin
    // reset condition
    RESET = 0;
    CE = 0;
    PHASE = 0;
    #200 @(posedge CLK) RESET = 1;
    #100 @(posedge CLK) RESET = 0;
    @(posedge CLK) #1 CE = 1;
    $display("Starting CORDIC SIN COS test");
    $display("===========");
    cycleCounter = 0;

    //repeat(3000) nextCycle();
    repeat((1<<PHASE_BITS) + LATENCY) nextCycle();
    
    $display( "DATA_BITS=%d PHASE_BITS=%d STEP1_PHASE_BITS=%d STEP2_PHASE_BITS=%d EXTRA_DATA_BITS=%d LATENCY=%d"   
        , DATA_BITS
        , PHASE_BITS
        , STEP1_PHASE_BITS
        , STEP2_PHASE_BITS
        , EXTRA_DATA_BITS
        , LATENCY
    );
    

    $display("*** sum sin_diff=%f (%f) cos_diff=%f (%f)   abs sin_diff=%f (%f) cos_diff=%f (%f)", 
        sum_sin_diff, sum_sin_diff/(1<<PHASE_BITS), 
        sum_cos_diff, sum_cos_diff/(1<<PHASE_BITS),
        sum_abs_sin_diff, sum_abs_sin_diff/(1<<PHASE_BITS),
        sum_abs_cos_diff, sum_abs_cos_diff/(1<<PHASE_BITS)
        );
    $display("*** max abs cos diff = %f   sin diff = %f", max_abs_cos_diff, max_abs_sin_diff);
    $display("bigSinDiffCount = %d (%f) bigCosDiffCount = %d (%f)", 
        bigSinDiffCount, (bigSinDiffCount+0.0)/(1<<PHASE_BITS),
        bigCosDiffCount, (bigCosDiffCount+0.0)/(1<<PHASE_BITS));
    $display("===========");
    $display("Test passed");
    $finish();

end



endmodule
