fpga-theremin/sensors/fpga_sensor/simulator/sensor_simulator/dds.cpp

#include "dds.h"
#include <QtMath>

PhaseAccumulator::PhaseAccumulator()
    : phase(0)
    , increment(frequencyToIncrement(1009820.856, 33333333.333333))
{

}

uint32_t PhaseAccumulator::frequencyToIncrement(double signalFrequency, double sampleRate) {
    return (int32_t)round((1ull << 32) / (sampleRate / signalFrequency));
}

DDS::DDS(double sampleRate, int sinTableSizeBits, int sinValueBits, double scale)
    : sinTable(sinTableSizeBits, sinValueBits, scale)
    , sampleRate(sampleRate)
{
    setFrequency(1009820.856);
}

void DDS::setFrequency(double freq) {
    uint32_t increment = PhaseAccumulator::frequencyToIncrement(freq, sampleRate);
    phaseAccum.setIncrement(increment);
}

int DDS::nextSample() {
    uint32_t phase = phaseAccum.tick();
    int sample = sinTable.getForPhase(phase);
    return sample;
}


SigmaDelta::SigmaDelta(int inputBits, int outputBits)
    : inputBits(inputBits)
    , outputBits(outputBits)
{
    shift = inputBits - outputBits;
    acc1 = 0;
    acc2 = 0;
    outValue = 0;
    dacVal2 = 0;
}

int SigmaDelta::tick(int inputSample) {
    acc1 += inputSample - outValue;
    acc2 += acc1 - outValue;
    outValue = (acc2 >> shift) << shift;
    return outValue >> shift;
}

PWLFile::PWLFile(const char * fname)
    : f(nullptr)
    , minStep(0.0000000001)
    , minDiff(0.00001)
    , lastTime(0)
    , lastValue(0)
    , newTime(0)
    , newValue(0)
    , firstSample(true)
{
    f = fopen(fname, "wt");
    if (!f) {
        qDebug("Error while creating file %s", fname);
    }
}

void PWLFile::put(double t, double v) {
    if (f)
        fprintf(f, "%.11f\t%.6f\n", t, v);
    lastTime = t;
    lastValue = v;
    firstSample = false;
}

void PWLFile::step(double timeIncrement, double value) {
    if (firstSample) {
        put(0, value);
        newTime = 0;
        newValue = value;
    }
    double t = newTime + timeIncrement;
    double v = value;

    if (newTime - lastTime > minStep && timeIncrement > minStep) {
        double dt0 = newTime - lastTime;
        double dv0 = newValue - lastValue;
        double dt1 = t - lastTime;
        double dv1 = v - lastValue;
        double d0 = dv0 / dt0;
        double d1 = dv1 / dt1;
        double ddelta = (d1 - d0);
        if (ddelta < 0)
            ddelta = -ddelta;
        if (ddelta > minDiff) {
            put(newTime, newValue);
        }
    }

    newTime = t;
    newValue = v;
}

PWLFile::~PWLFile() {
    if (newTime > lastTime + 0.0000000001)
        put(newTime, newValue);
    if (f)
        fclose(f);
}

DACPWL::DACPWL(const char * file, double sampleRate, int bitsPerSample, double edge, double value0, double value1)
    : f(file)
    , sampleRate(sampleRate)
    , bitsPerSample(bitsPerSample)
    , value0(value0)
    , value1(value1)

{
    samplePeriod = 1.0 / sampleRate;
    edgeLength = samplePeriod * edge;
    hLength = samplePeriod * (1.0 - edge);
    middle = (value0 + value1) / 2;
    scale = (value1-value0) / (1 << bitsPerSample);
}

void DACPWL::put(int v) {
    double value = v * scale + middle;
    f.step(edgeLength, value);
    f.step(hLength, value);
}

PatternPWM::PatternPWM(const char * file, int sampleRate, double edge, double value0, double value1)
    : f(file)
    , sampleRate(sampleRate)
    , value0(value0)
    , value1(value1)

{
    bitPeriod = 1.0 / sampleRate;
    edgeLength = bitPeriod * edge;
    hLength = bitPeriod * (1.0 - edge);
}

void PatternPWM::putBit(int v) {
    double outValue = (v ? value1 : value0);
    f.step(edgeLength, outValue);
    f.step(hLength, outValue);
}

void PatternPWM::putBits(int v, int bitCount) {
    int mask = 1;
    for (int i = 0; i < bitCount; i++) {
        putBit(v & mask);
        mask = mask << 1;
    }
}

static const int PWM_PATTERN_TABLE_12[16] = {
    // INPUT  VALUE   PWM SEQUENCE
    // -----  -----   ------------
    0b001110001110, // 0000     0     001110001110
    0b001111001110, // 0001     1     001111001110
    0b011110011110, // 0010     2     011110011110
    0b001111111110, // 0011     3     001111111110
    0b011111111110, // 0100     4     011111111110
    0b011111111110, // 0101    (4)   (011111111110)
    0b011111111110, // 0110    (4)   (011111111110)
    0b011111111110, // 0111    (4)   (011111111110)
    // negative values
    0b000001100000, // 1000    (-4)  (000001100000)
    0b000001100000, // 1001    (-4)  (000001100000)
    0b000001100000, // 1010    (-4)  (000001100000)
    0b000001100000, // 1011    (-4)  (000001100000)
    0b000001100000, // 1100    -4     000001100000
    0b000001110000, // 1101    -3     000001110000
    0b001100001100, // 1110    -2     001100001100
    0b001110001100, // 1111    -1     001110001100
};
// put 4-bit signed value as 12-bit PWM pattern
void PatternPWM::putPattern12(int v) {
    int pattern = PWM_PATTERN_TABLE_12[v & 15];
    putBits(pattern, 12);
}

void testDDS1() {
    DDS dds(33333333.333, 10, 9, 0.45);
    DDS dds2(33333333.333, 10, 16, 0.45);
    dds.setFrequency(1009820.856);
    dds2.setFrequency(1009820.856);
    //dds.setFrequency(12820.856);
    //dds2.setFrequency(12820.856);
    qDebug("Generating PWL file for sine PWM");
    PatternPWM pwm("pwm_sine_12bit_pattern_400Msps_33MHz.txt");
    PatternPWM pwm2("pwm_sine_12bit_pattern_400Msps_33MHz_sigma_delta.txt");
    PatternPWM pwm3("pwm_sine_12bit_pattern_400Msps_33MHz_sigma_delta_16.txt");
    DACPWL dac("dac_sine_9bps_33MHz.txt");
    SigmaDelta sigmaDelta(9, 4);
    SigmaDelta sigmaDelta2(16, 4);
    int shift = dds.sinTable.getValueBits() - 4;
    //int shift2 = dds2.sinTable.valueBits - 4;
    for (int i = 0; i < 33*1000; i++) {
        int sample = dds.nextSample();
        int sample16 = dds2.nextSample();
        int index = (sample >> shift) & 15;
        if (index >= 5 && index <= 11) {
            qDebug("[%d] index out of bounds %d", i, index);
        }
        pwm.putPattern12(index);
        dac.put(sample);
        int sd = sigmaDelta.tick(sample);
        pwm2.putPattern12(sd);

        int sd2 = sigmaDelta2.tick(sample16);
        pwm3.putPattern12(sd2);
        //qDebug(" [%d] %d", i, sample);
    }
}

void testDDS2() {
    DDS dds(200000000.0, 10, 9, 1.0);
    dds.setFrequency(1009820.856);
    PatternPWM pwm("pwm_sine_1bit_200Msps.txt", 200000000);
    SigmaDelta sigmaDelta(9, 1);
    for (int i = 0; i < 33*1000; i++) {
        int sample = dds.nextSample();
        int sd = sigmaDelta.tick(sample);
        pwm.putBit(sd >= 0 ? 1 : 0);
    }
}

QString formatBin(int n, int bits) {
    return QString("%1").arg((int)n, (int)3, (int)2, QLatin1Char('0'));
}

void generateVerilogVectorLengthCases3x3() {
    qDebug("");
    for (int y = 0; y < 8; y++) {
        for (int x = 0; x < 8; x++) {
            int squareSum = x*x + y*y;
            int sq = (int)floor(sqrt(squareSum + 0.99999));
            if (sq > 7)
                sq = 7;
            QString line = QString("        6'b%1_%2: amplitude_stage1 <= %3;").arg(formatBin(y, 3)).arg(formatBin(x, 3)).arg(sq);
            qDebug("%s", line.toUtf8().data());
        }
    }
    qDebug("");
    for (int scale = 0; scale < 8; scale++) {
        for (int amp = 0; amp < 8; amp++) {
            int action = 0;
            int amp1 = amp == 0 ? 1 : amp;
            int halfPeriods = (scale + 1) * 2; // for 0, 1, 2: 2, 4, 6, 8...
            int halfPeriodsInc = halfPeriods + 2;
            int halfPeriodsDec = halfPeriods - 2;
            // expected amplitude after increment
            int ampInc = amp1 * halfPeriodsInc / halfPeriods;
            // expected amplitude after decrement
            int ampDec = amp1 * halfPeriodsDec / halfPeriods;
            if (amp >= 6) {
                if (scale > 0)
                    action = 1; // reduce scale
            } else if (ampInc < 5) {
                if (scale < 7)
                    action = 2; // increase scale
            }

            QString line = QString("        6'b%1_%2: action_stage2 <= %3;").arg(formatBin(scale, 3)).arg(formatBin(amp, 3)).arg(action);
            qDebug("%s", line.toUtf8().data());
        }
    }
    qDebug("");
}

void SinCosCORDIC::sinCosPiDiv4(int & outx, int & outy, uint32_t phase32) {
    int firstSignificantPhaseBit = 32 - 2 - step1PhaseBits - step2PhaseBits - 1;
    int quadrant = (phase32 >> (32-2)) & 3;
    int swapSinCos = (phase32 >> (32-3)) & 1;
    // 7 bits of tabular sin&cos
    int step1 = (phase32 >> (firstSignificantPhaseBit+step2PhaseBits)) & (steps1-1);
    // 9 bits of rotation
    int step2 = (phase32 >> (firstSignificantPhaseBit+0)) & (steps2-1);
    if (swapSinCos) {
        // invert angle for PI/4..PI/2
        step1 ^= (steps1-1);
        step2 ^= (steps2-1);
    }
    int negx = 0;
    int negy = 0;
    switch (quadrant) {
    case 0: // 0 degrees
    default:
        break;
    case 1: // 90 degrees
        swapSinCos ^= 1;
        negx = 1;
        break;
    case 2: // 180 degrees
        negx = 1;
        negy = 1;
        break;
    case 3: // 270 degrees
        swapSinCos ^= 1;
        negy = 1;
        break;
    }

    uint32_t tableEntry = sinCosTable[step1];
    int x = (tableEntry & 0xFFFF) | 0x10000;
    int y = (tableEntry >> 16) & 0xFFFF;
    if (step1 > sinHighBitBound)
        y |= 0x10000;

    // increase precision by shift bits
    //int extraPrecisionBits = 8;
    x = x << extraPrecisionBits;
    y = y << extraPrecisionBits;

    //double lastAngle = atan2(y, x);
    //double startLength = sqrt(1.0*x*x + 1.0*y*y);

    // second stage - rotation by small angle
    int signFlags = (fracRotationTable[step2] << 1);
    if (step2 < steps2/2)
        signFlags |= 1;
    for (int i = 0; i < rotations; i++) {
        int sx = x >> (startShift + i);
        int sy = y >> (startShift + i);
        if (signFlags & 1) {
            x += sy;
            y -= sx;
        } else {
            x -= sy;
            y += sx;

        }
        //double angle = atan2(y, x);
        //qDebug("     step %d sign %d  rotated by %.9f", i, (signFlags & 1), angle-lastAngle);
        //lastAngle = angle;
        signFlags >>= 1;
    }

    //double endLength = sqrt(1.0*x*x + 1.0*y*y);
    //qDebug("startLength=%.9f  endLength=%.9f  scaledBy=%.9f", startLength, endLength, endLength/startLength);


    // rounding
    //x = x + (1 << extraPrecisionBits);
    //y = y + (1 << extraPrecisionBits);
    // drop extra bits
    //x = x >> (extraPrecisionBits+1);
    //y = y >> (extraPrecisionBits+1);

    if (swapSinCos) {
        outx = y >> (extraPrecisionBits + 1);
        outy = x >> (extraPrecisionBits + 1);
    } else {
        outx = x >> (extraPrecisionBits + 1);
        outy = y >> (extraPrecisionBits + 1);
    }
    if (negx)
        outx = -outx;
    if (negy)
        outy = -outy;
    // rounding
    outx = (outx + 1) >> 1;
    outy = (outy + 1) >> 1;
}
void SinCosCORDIC::sinCos(int & outx, int & outy, uint32_t phase32) {
    if (usePiDiv4Table)
        return sinCosPiDiv4(outx, outy, phase32);
    int firstSignificantPhaseBit = 32 - 2 - step1PhaseBits - step2PhaseBits;
    int quadrant = (phase32 >> (32-2)) & 3;
    // 7 bits of tabular sin&cos
    int step1 = (phase32 >> (firstSignificantPhaseBit+step2PhaseBits)) & (steps1-1);
    // 9 bits of rotation
    int step2 = (phase32 >> (firstSignificantPhaseBit+0)) & (steps2-1);

    uint32_t tableEntry = sinCosTable[step1];
    int x = tableEntry & 0xFFFF;
    int y = (tableEntry >> 16) & 0xFFFF;

    // increase precision by shift bits
    //int extraPrecisionBits = 8;
    x = x << extraPrecisionBits;
    y = y << extraPrecisionBits;

    //double lastAngle = atan2(y, x);
    //double startLength = sqrt(1.0*x*x + 1.0*y*y);

    // second stage - rotation by small angle
    int signFlags = (fracRotationTable[step2] << 1);
    if (step2 < steps2/2)
        signFlags |= 1;
    for (int i = 0; i < rotations; i++) {
        int sx = x >> (startShift + i);
        int sy = y >> (startShift + i);
        if (signFlags & 1) {
            x += sy;
            y -= sx;
        } else {
            x -= sy;
            y += sx;

        }
        //double angle = atan2(y, x);
        //qDebug("     step %d sign %d  rotated by %.9f", i, (signFlags & 1), angle-lastAngle);
        //lastAngle = angle;
        signFlags >>= 1;
    }

    //double endLength = sqrt(1.0*x*x + 1.0*y*y);
    //qDebug("startLength=%.9f  endLength=%.9f  scaledBy=%.9f", startLength, endLength, endLength/startLength);


    // rounding
    //x = x + (1 << extraPrecisionBits);
    //y = y + (1 << extraPrecisionBits);
    // drop extra bits
    //x = x >> (extraPrecisionBits+1);
    //y = y >> (extraPrecisionBits+1);

    // final stage - quadrant processing
    switch (quadrant) {
    case 0: // 0 degrees
    default:
        outx = x >> (extraPrecisionBits);
        outy = y >> (extraPrecisionBits);
        break;
    case 1: // 90 degrees
        outx = (-y)  >> (extraPrecisionBits);
        outy = (x)  >> (extraPrecisionBits);
        break;
    case 2: // 180 degrees
        outx = (-x)  >> (extraPrecisionBits);
        outy = (-y)  >> (extraPrecisionBits);
        break;
    case 3: // 270 degrees
        outx = (y) >> (extraPrecisionBits);
        outy = (-x) >> (extraPrecisionBits);
        break;
    }
    // rounding
    outx = (outx + 1) >> 1;
    outy = (outy + 1) >> 1;

    //double length = sqrt(1.0*x*x + 1.0*y*y);
    //qDebug("x=%d y=%d length=%.9f", outx, outy, length);

}

void SinCosCORDIC::initAngles(double bigStepAngle) {
    //qDebug("bigStepAngle = %.9f  bigStepAngle/2 = %.9f", bigStepAngle, bigStepAngle/2.0);
    int start = 0;
    for (int i = 0; i < 32; i++) {
        double k = 1.0 / (1<<i);
        double ak = atan(k);
        atanPowerOfTwo[i] = ak;
        //qDebug(" ATAN  [2^-%d]  %.9f", i, ak);
        if (start == 0 && ak < bigStepAngle/2.0) {
//            qDebug("        FOUND first frac angle: %d    %.9f   <  %.9f", i, ak, bigStepAngle/2.0);
            start = i;
        }
    }
//    double angleSum = 0;
//    double angleSumNext = 0;
//    for (int i = 0; i < rotations; i++) {
//        angleSum += atanPowerOfTwo[start + i];
//        angleSumNext += atanPowerOfTwo[start + i + 1];
//    }
//    qDebug(" bigStepAngle/2= %.9f    angleSum=%.9f  nextAngleSum=%.9f", bigStepAngle/2.0, angleSum, angleSumNext);
    double scalex = 1.0;
    double scaley = 0.0;
    for (int i = 0; i < rotations; i++) {
        double shiftx = scalex / (1 << (start + i));
        double shifty = scaley / (1 << (start + i));
        scalex -= shifty;
        scaley += shiftx;
    }
    double length = sqrt(scalex * scalex + scaley * scaley);
    scale = length;
    startShift = start;
    for (int i = 0; i < steps2; i++) {
        double angle = (i + 0.5) * bigStepAngle / steps2;
        angle = angle - bigStepAngle / 2.0;
        //double startAngle = angle;
        //qDebug("  frac angle [%d]   %.9f", i, angle);
        int flags = 0;
        //int reverseFlags = 0;
        for (int j = 0; j < rotations; j++) {
            double step = atanPowerOfTwo[startShift + j];
            if (angle < 0) {
                angle += step;
                flags = flags | (1<<j);
                //reverseFlags = reverseFlags | (1<<(rotations - j - 1));
            } else {
                angle -= step;
            }
        }
        int angle0 = (i < steps2/2) ? 1 : 0;
        assert((flags & 1) == angle0);
//        qDebug("             [%d]%04x  flags=%04x revFlags=%04x     %.9f", i, i, flags, reverseFlags, angle);
//        if (i != reverseFlags) {
//            qDebug("    [%i]  angle difference  %04x %04x ", i, i, reverseFlags);
//        }
        fracRotationTable[i] = flags >> 1;
    }
}

void SinCosCORDIC::initPiDiv2() {
    steps1 = 1 << step1PhaseBits;
    steps2 = 1 << step2PhaseBits;
    double bigStepAngle = M_PI / (steps1 * 2);
    initAngles(bigStepAngle);
    //qDebug("scale = %.9f", scale);
    // init table for step 1
    for (int i = 0; i < steps1; i++) {
        // 0..127 are angles in range (0..PI/2)
        double phase = (i + 0.5) * bigStepAngle;
        uint32_t x = (int)(cos(phase) * 65534.0 / scale);
        uint32_t y = (int)(sin(phase) * 65534.0 / scale);
        assert((x >= 0) && (x<=65535) && (y >= 0) && (y<=65535));
        //qDebug(" [%d]\t%.9f\t%d\t%d", i, phase, x, y);
        sinCosTable[i] = (y<<16) | x;
    }
}

void SinCosCORDIC::initPiDiv4() {
    steps1 = 1 << step1PhaseBits;
    steps2 = 1 << step2PhaseBits;
    double bigStepAngle = M_PI / (steps1 * 4);
    initAngles(bigStepAngle);
    //qDebug("scale = %.9f", scale);
    // init table for step 1
    int tableScale = 32767 * 4;
    for (int i = 0; i < steps1; i++) {
        // 0..127 are angles in range (0..PI/2)
        double phase = (i + 0.5) * bigStepAngle;
        uint32_t x = (int)(cos(phase) * tableScale / scale);
        uint32_t y = (int)(sin(phase) * tableScale / scale);
        assert((x >= 0) && (x<=tableScale) && (y >= 0) && (y<=tableScale));
        // for 0..PI/4 cos>0.5, sin<0.5 - so we can avoid storing upper bit since it's const
        assert(x >= tableScale/2);
        //assert(y < tableScale/2);
        //qDebug(" [%d]\t%.9f\t%d\t%d", i, phase, x, y);
        if (y < 0x10000)
            sinHighBitBound = i;
        x = x & 0xffff;
        y = y & 0xffff;
        sinCosTable[i] = (y<<16) | x;
    }
}

void SinCosCORDIC::genVerilog(const char * fname) {
    qDebug("");
    qDebug("localparam FIRST_ROTATION_SHIFT = %d;", startShift);
    qDebug("localparam EXTRA_DATA_BITS = %d;", extraPrecisionBits);
    qDebug("// for angle <= bound top bit of sin is 0, otherwise 1");
    qDebug("localparam SIN_HIGH_BIT_0_BOUND = %d;", sinHighBitBound);
    qDebug("");
    qDebug("// SIN&COS lookup table ROM internal register");
    qDebug("reg [SIN_COS_LOOKUP_DATA_BITS*2-1:0] sin_cos_data_stage0 = 0;");
    qDebug("// ROTATIONS lookup table ROM internal register");
    qDebug("reg [ROTATIONS_LOOKUP_DATA_BITS-1:0] rotation_data_stage0 = 0;");
    qDebug("");
    qDebug("always @(posedge CLK) begin");
    qDebug("    if (CE) begin");
    qDebug("        // SIN and COS lookup table ROM content");
    qDebug("        case(step1_lookup_addr)");
    for (int i = 0; i < steps1; i++) {
        qDebug("        %d: sin_cos_data_stage0 <= 32'h%08x;", i, sinCosTable[i]);
    }
    qDebug("        endcase");
    qDebug("    end");
    qDebug("end");
    qDebug("");
    qDebug("");
    qDebug("always @(posedge CLK) begin");
    qDebug("    if (CE) begin");
    qDebug("        // ROTATIONS lookup table ROM content");
    qDebug("        case(step2_lookup_addr)");
    for (int i = 0; i < steps2; i++) {
        qDebug("        %d: rotation_data_stage0 <= 8'h%02x;", i, fracRotationTable[i] & 0xFF);
    }
    qDebug("        endcase");
    qDebug("    end");
    qDebug("end");
    qDebug("");
}

SinCosCORDIC::SinCosCORDIC(bool usePiDiv4Table, int step1bits, int step2bits, int rotCount, int extraBits)
    : usePiDiv4Table(usePiDiv4Table),
      step1PhaseBits(step1bits),
      step2PhaseBits(step2bits),
      rotations(rotCount), extraPrecisionBits(extraBits) {

    //
    if (usePiDiv4Table)
        initPiDiv4();
    else
        initPiDiv2();
}

void testCordic() {
    qDebug("CORDIC tests");
    qDebug("step1\trot\textraBits\tsumError\tpError");
    int samples = 1235793;
    for (int step1 = 7; step1 <= 8 ; step1++) {
        SinTable sinTable(18 + (step1-7), 16);
        for (int rotations = 8; rotations <= 12; rotations++) {
            for (int extraBits = 0; extraBits <= rotations; extraBits++) {
                SinCosCORDIC cordic(true, step1, 9, rotations, extraBits);
                int x = 0;
                int y = 0;
                cordic.sinCos(x, y, 0x00123456);

                int sumError = 0;
                int maxxError = 0;
                int maxyError = 0;
                int phaseBits = 3 + cordic.step1PhaseBits + cordic.step2PhaseBits;
                int angleStep = 1 << (32 - phaseBits);
                for (uint64_t i = 0; i < 0x100000000ULL; i+=angleStep) {
                    int64_t phase32 = i;
                    //double phase = 2 * M_PI * i / samples + 0.000001;
                    //int64_t phase32 = phase * (1ULL<<31) / M_PI;
                    // rounding to number of supported bits
                    //phase32 = (phase32 & 0xFFFFC000) + 0x00002000;
                    double phase = (phase32 + 0x00002000) * M_PI / (1ULL << 31);
                    //int expectedy = sinTable.getForPhase(phase32);
                    //int expectedx = sinTable.getForPhase(((phase32 + 0x40000000) & 0xFFFFFFFF));
                    int expectedx = (int)(cos(phase)*32767);
                    int expectedy = (int)(sin(phase)*32767);
                    cordic.sinCos(x, y, phase32);
                    //qDebug(" [%d]  phase=%.9f  %08x   x=%d y=%d   expx=%d expy=%d   xerror=%d  yerror=%d", i, phase, phase32,
                    //       x, y, expectedx, expectedy, x-expectedx, y-expectedy);
                    int dx = expectedx - x;
                    int dy = expectedy - y;
                    dx = dx < 0 ? -dx : dx;
                    dy = dy < 0 ? -dy : dy;
                    if (maxxError < dx)
                        maxxError = dx;
                    if (maxyError < dy)
                        maxyError = dy;
                    sumError += dx + dy;
                }
                qDebug("%d\t%d\t%d\t%d\t%.9f\t%d\t%d", step1, rotations, extraBits, sumError, sumError * 1.0 / samples, maxxError, maxyError);
            }
        }
    }
    qDebug("Generating verilog:");
    {
        SinCosCORDIC cordic(true, 8, 9, 9, 4);
        cordic.genVerilog("cordic.v");
    }

    qDebug("CORDIC tests done");
}

void testDDS() {
    testCordic();

    SinTable sinTable(10, 12);
    sinTable.generateVerilog("");
    sinTable.generateMemInitFile("");
    sinTable.generateVerilogTestBench("");
    sinTable.generateSinCosVerilog("");
    SinTable sinTable2(12, 13);
    sinTable2.generateVerilog("");
    sinTable2.generateMemInitFile("");
    sinTable2.generateVerilogTestBench("");
    sinTable2.generateSinCosVerilog("");
    sinTable2.generateSinCosVerilogTestBench("");

    testDDS1();
    testDDS2();
    generateVerilogVectorLengthCases3x3();
}
