fpga-theremin/sensors/fpga_sensor/simulator/sensor_simulator/dsputils.cpp

#include "dsputils.h"
#include <QtMath>
#include <string.h>

void SimClock::add(SimDevice * device) {
    if (_devicesCount >= _devicesSize) {
        if (!_devices) {
            _devicesSize = 16;
            _devices = new SimDevice *[_devicesSize];
        } else {
            int newSize = _devicesSize * 2;
            SimDevice ** newDevices = new SimDevice *[newSize];
            for (int i = 0; i < _devicesCount; i++) {
                newDevices[i] = _devices[i];
            }
            delete[] _devices;
            _devices = newDevices;
            _devicesSize = newSize;
        }
    }
    _devices[_devicesCount++] = device;
}

void SimClock::onUpdate() {
    for (int i = 0; i < _devicesCount; i++) {
        _devices[i]->onUpdate();
    }
}

void SimClock::onClock() {
    for (int i = 0; i < _devicesCount; i++) {
        _devices[i]->onClock();
    }
}

void SimClock::onReset() {
    for (int i = 0; i < _devicesCount; i++) {
        _devices[i]->onReset();
    }
}

SimClock::~SimClock() {
    if (_devices)
        delete[] _devices;
}

SinTable::SinTable(int tableSizeBits, int valueBits, double scale, int phaseBits)
    : table(nullptr), phaseBits(phaseBits)
{
    init(tableSizeBits, valueBits, scale);
}

SinTable::~SinTable() {
    if (table)
        delete[] table;
}

void SinTable::init(int tableSizeBits, int valueBits, double scale, int phaseBits) {
    Q_ASSERT(tableSizeBits >= 4 && tableSizeBits <= 20);
    Q_ASSERT(valueBits >= 4 && valueBits <= 20);
    Q_ASSERT(phaseBits >= 16 && phaseBits <= 48);
    if (table)
        delete[] table;
    this->phaseBits = phaseBits;
    this->tableSizeBits = tableSizeBits;
    this->valueBits = valueBits;
    this->tableSize = (1 << tableSizeBits);
    this->table = new int[tableSize];
    // valueBits includes sign, so positive has valueBits-1 filled with all-ones
    int maxIntValue = (1 << (valueBits-1)) - 1;
    double targetScale = maxIntValue * scale;
    for (int i = 0; i < tableSize; i++) {
        double phase = (i + 0.5) * 2*M_PI / tableSize;
        double sinValue = sin(phase);
        double scaled = targetScale * sinValue;
        int rounded = (int)round(scaled);
        table[i] = rounded;
    }

    // test for quarter table and full table getters
    int64_t sum = 0;
    uint32_t phase = 0xffff0000;
    for (;;) {
        int quarterTableValue = getForPhase(phase);
        int fullTableValue = getForPhaseFull(phase);
        Q_ASSERT(quarterTableValue == fullTableValue);
        sum += fullTableValue;
        if (phase == 0)
            break;
        phase -= 0x10000;
    }
    Q_ASSERT(sum == 0);

    // probably max scale w/o errors is 8.062/16.0
    //qDebug("Done. Range error count: %d", errCount);
}


int SinTable::operator [](int index) const {
    Q_ASSERT((index >= 0) && (index < tableSize));
    return table[index];
}

// get sine table value from full table entry index, using only 1/4 of table
int SinTable::get(int fullTableIndex) const {
    int resultSign = (fullTableIndex & (tableSize >> 1)) ? -1 : 1;
    Q_ASSERT((fullTableIndex >= 0) && (fullTableIndex < tableSize));
    int quarterTableMask = ((tableSize >> 2) - 1);
    int quarterTableIndex = fullTableIndex & quarterTableMask;
    Q_ASSERT((quarterTableIndex >= 0) && (quarterTableIndex < tableSize / 4));
    if ((fullTableIndex & (tableSize >> 2))) {
        quarterTableIndex = quarterTableIndex ^ quarterTableMask;
    }
    Q_ASSERT((quarterTableIndex >= 0) && (quarterTableIndex < tableSize / 4));
    int tableEntry = table[quarterTableIndex];
    return tableEntry * resultSign;
}

int SinTable::getForPhase(uint64_t phase) const {
    int fullTableIndex = (int)(phase >> (phaseBits-tableSizeBits));
    return get(fullTableIndex);
}
int SinTable::getForPhaseFull(uint32_t phase) const {
    int fullTableIndex = (int)(phase >> (phaseBits-tableSizeBits));
    Q_ASSERT((fullTableIndex >= 0) && (fullTableIndex < tableSize));
    return table[fullTableIndex];
}

static const char * SIN_TABLE_VERILOG_CODE[] = {
    "",
    "",
    "/* ROM size: we need to store only 1/4 of table entries, the rest may be obtained by mirroring and changing the sign */",
    "localparam MEMSIZE = 1 << (ADDR_WIDTH - 2);",
    "",
    "/* first quarter of table always has 0 in upper bit, so we can store only DATA_WIDTH-1 bits in the table */",
    "(* ram_style = \"block\" *)  ",
    "reg [DATA_WIDTH-2:0] memory[0:MEMSIZE-1];",
    "       ",
    "/* store input phase value in register */",
    "reg [ADDR_WIDTH-1:0] phase_stage0;",
    "always @(posedge CLK)",
    "    if (RESET)",
    "        phase_stage0 <= 0;",
    "    else if (CE)",
    "        phase_stage0 <= PHASE;",
    " ",
    "/* second half of table is the same as first, but negative */",
    "wire need_sign_change = phase_stage0[ADDR_WIDTH-1];",
    "/* second and third quarters of table are mirrored by phase */",
    "wire need_phase_inverse = phase_stage0[ADDR_WIDTH-2];",
    "/* invert phase to have mirrored value */",
    "wire [ADDR_WIDTH-3:0] table_entry_index = phase_stage0[ADDR_WIDTH-3:0] ^ { (ADDR_WIDTH-2) {need_phase_inverse} };",
    " ",
    "/* propagate sign change flag to support negative values */",
    "reg need_sign_change_stage1;",
    "reg need_sign_change_stage2;",
    "always @(posedge CLK)",
    "    if (CE) begin",
    "        need_sign_change_stage1 <= need_sign_change;",
    "        need_sign_change_stage2 <= need_sign_change_stage1;",
    "    end",
    "        ",
    "/* block RAM based ROM - first stage of pipeline */",
    "reg [DATA_WIDTH-2:0] rddata_stage1;",
    "always @(posedge CLK)",
    "    if (CE)",
    "        rddata_stage1 <= memory[table_entry_index];",
    " ",
    "/* block RAM based ROM - second stage of pipeline */",
    "reg [DATA_WIDTH-2:0] rddata_stage2;",
    "always @(posedge CLK)",
    "    if (CE)",
    "        rddata_stage2 <= rddata_stage1;",
    " ",
    "/* this is output stage register, need sign bit as well */",
    "reg [DATA_WIDTH-1:0] rddata_stage3;",
    "always @(posedge CLK)",
    "    if (RESET)",
    "        rddata_stage3 <= 0; ",
    "    else if (CE)",
    "        rddata_stage3 <= need_sign_change_stage2 ? -{1'b0, rddata_stage2} : {1'b0, rddata_stage2}; ",
    " ",
    "/* propagate value to output */",
    "assign VALUE = rddata_stage3;",
    "",
    "",
    nullptr

};

static const char * STANDARD_PARAMS_VERILOG_CODE[] = {
    "/* input clock                                           */",
    "input wire CLK,",
    "/* clock enable, 1 = enable pipeline, 0 = pause pipeline */",
    "input wire CE,",
    "/* reset signal, active 1                                */",
    "input wire RESET,",
    "",
    nullptr
};

static const char * SIN_TABLE_PARAMS_VERILOG_CODE[] = {
    "/* sine table address to get value from                  */",
    "input wire [ADDR_WIDTH-1:0] PHASE,",
    "/* sine sample value from ROM, delayed by 4 clock cycles */",
    "output wire [DATA_WIDTH-1:0] VALUE",
    "",
    nullptr
};

static void writeSourceCode(FILE * f, const char ** lines, int indent = 1) {
    for (int i = 0; lines[i]!=nullptr; i++) {
        if (indent >= 1)
            fprintf(f, "    %s\n", lines[i]);
        else
            fprintf(f, "%s\n", lines[i]);
    }
}

// generate init file for $readmemh
bool SinTable::generateMemInitFile(const char * filePath) {
    char fileName[4096];
    char moduleName[256];
    sprintf(moduleName, "sin_table_%d_%dbit", tableSize, valueBits);
    sprintf(fileName, "%s%s.mem", filePath, moduleName);
    FILE * f = fopen(fileName, "wt");
    if (!f) {
        qDebug("Cannot open file %s for writing", fileName);
        return false;
    }
    for (int i = 0; i < tableSize / 4; i++) {
        if (valueBits-1 > 12) {
            fprintf(f, "%04x\n", table[i]);
        } else if (valueBits-1 > 8) {
            fprintf(f, "%03x\n", table[i]);
        } else {
            fprintf(f, "%02x\n", table[i]);
        }
    }
    fclose(f);
    return true;
}

// generate verilog source code with table
bool SinTable::generateVerilog(const char * filePath) {
    char fileName[4096];
    char moduleName[256];
    sprintf(moduleName, "sin_table_%d_%dbit", tableSize, valueBits);
    sprintf(fileName, "%s%s.v", filePath, moduleName);
    FILE * f = fopen(fileName, "wt");
    if (!f) {
        qDebug("Cannot open file %s for writing", fileName);
        return false;
    }
    fprintf(f, "/*********************************************/\n");
    fprintf(f, "/* SINE table of size %d and %d-bit values */\n", tableSize, valueBits);
    fprintf(f, "/* Latency: 4 CLK cycles                     */\n");
    fprintf(f, "/*********************************************/\n");
    fprintf(f, "module %s #(\n", moduleName);
    fprintf(f, "    parameter DATA_WIDTH = %d,\n", valueBits);
    fprintf(f, "    parameter ADDR_WIDTH = %d\n", tableSizeBits);
    fprintf(f, ")\n");
    fprintf(f, "(\n");
    writeSourceCode(f, STANDARD_PARAMS_VERILOG_CODE);
    writeSourceCode(f, SIN_TABLE_PARAMS_VERILOG_CODE);
    fprintf(f, ");\n");
    writeSourceCode(f, SIN_TABLE_VERILOG_CODE);
    fprintf(f, "\n");
    fprintf(f, "    /* Initialization of ROM content with first quarter of SINE function */\n");
    fprintf(f, "    initial begin\n");
    for (int i = 0; i < tableSize / 4; i++) {
        fprintf(f, "        memory[%d] = %d;\n", i, table[i]);
    }
    fprintf(f, "    end\n");
    fprintf(f, "\n");
    fprintf(f, "endmodule\n");
    fclose(f);
    return true;
}

static const char * SIN_TABLE_TB_PARAMS_VERILOG_CODE[] = {
    "logic [15:0] cycleCounter = 0;",
    "logic CLK;",
    "logic CE;",
    "logic RESET;",
    "logic [ADDR_WIDTH-1:0] PHASE;",
    "wire signed [DATA_WIDTH-1:0] VALUE;",
    "",
    nullptr
};

static const char * SIN_TABLE_TB_MAIN_VERILOG_CODE[] = {
    "#(",
    "    .DATA_WIDTH(DATA_WIDTH),",
    "    .ADDR_WIDTH(ADDR_WIDTH)",
    ")",
    "sin_table_instance",
    "(",
    "    .*",
    ");",
    "",
    "// drive CLK",
    "always begin",
    "    #1.472 CLK=0;",
    "    #1.472 CLK=1; ",
    "    cycleCounter = cycleCounter + 1;",
    "end",
    "",
    "task nextCycle(input [ADDR_WIDTH-1:0] phase);",
    "     begin",
    "         @(posedge CLK) #1 ;",
    "         PHASE = phase;",
    "         $display(\"    [%d]   nextCycle PHASE=%d\", cycleCounter, PHASE);",
    "     end",
    "endtask",
    " ",
    "task checkResult(input signed [DATA_WIDTH-1:0] expected_value);",
    "     begin",
    "         $display(\"    [%d]             VALUE=%d\", cycleCounter, VALUE);",
    "         if (VALUE != expected_value) begin",
    "             $display(\"    [%d] ERROR: VALUE does not match with expected result, expected %x actual %x\", cycleCounter, expected_value, VALUE);",
    "             $finish();",
    "         end",
    "     end",
    "endtask",
    " ",
    "// reset condition",
    "initial begin",
    "    RESET = 0;",
    "    CE = 0;",
    "    #200 @(posedge CLK) RESET = 1;",
    "    #100 @(posedge CLK) RESET = 0;",
    "    @(posedge CLK) #1 CE = 1;",
    "    PHASE = 0;",
    " ",
    "    $display(\"Starting verification\");",
    "",
    nullptr
};

static const char * SIN_TABLE_TB_END_VERILOG_CODE[] = {
    "    $display(\"Test passed\");",
    "    $finish();",
    "end",
    "",
    "endmodule",
    "",
    nullptr
};


// generate verilog source code for verification of sine table
bool SinTable::generateVerilogTestBench(const char * filePath) {
    char fileName[4096];
    char moduleName[256];
    sprintf(moduleName, "sin_table_%d_%dbit", tableSize, valueBits);
    sprintf(fileName, "%s%s_tb.sv", filePath, moduleName);
    FILE * f = fopen(fileName, "wt");
    if (!f) {
        qDebug("Cannot open file %s for writing", fileName);
        return false;
    }
    fprintf(f, "/*********************************************/\n");
    fprintf(f, "/* SINE table of size %d and %d-bit values */\n", tableSize, valueBits);
    fprintf(f, "/* Latency: 4 CLK cycles                     */\n");
    fprintf(f, "/* TESTBENCH                                 */\n");
    fprintf(f, "/*********************************************/\n");
    fprintf(f, "`timescale 1ns / 1ps\n");
    fprintf(f, "module %s_tb ();\n", moduleName);
    fprintf(f, "\n");
    fprintf(f, "    localparam     DATA_WIDTH = %d;\n", valueBits);
    fprintf(f, "    localparam     ADDR_WIDTH = %d;\n", tableSizeBits);
    fprintf(f, "\n");
    fprintf(f, "\n");
    writeSourceCode(f, SIN_TABLE_TB_PARAMS_VERILOG_CODE);
    fprintf(f, "    %s\n", moduleName);
    writeSourceCode(f, SIN_TABLE_TB_MAIN_VERILOG_CODE);
    fprintf(f, "\n");
    fprintf(f, "        /* Outputs are delayed by 4 clock cycles */\n");
    for (int i = 0; i < tableSize + 8; i++) {
        int phase = i % tableSize;
        int resultPhase = (tableSize + i - 4) % tableSize;
        int expectedResult = table[resultPhase];
        if (i < 4)
            fprintf(f, "        nextCycle(%d);\n", phase);
        else
            fprintf(f, "        nextCycle(%d); checkResult(%d);\n", phase, expectedResult);
    }

    writeSourceCode(f, SIN_TABLE_TB_END_VERILOG_CODE);
    fclose(f);
    return true;
}

static const char * SIN_COS_TABLE_PARAMS_VERILOG_CODE[] = {
    "/* sine table address to get value from                  */",
    "input wire [ADDR_WIDTH-1:0] PHASE,",
    "/* sin sample value from ROM, delayed by 4 clock cycles */",
    "output wire [DATA_WIDTH-1:0] SIN_VALUE,",
    "/* cos sample value from ROM, delayed by 4 clock cycles */",
    "output wire [DATA_WIDTH-1:0] COS_VALUE",
    "",
    nullptr
};

static const char * SIN_COS_TABLE_VERILOG_CODE[] = {
    "",
    "",
    "/* ROM size: we need to store only 1/4 of table entries, the rest may be obtained by mirroring and changing the sign */",
    "localparam MEMSIZE = 1 << (ADDR_WIDTH - 2);",
    "",
    "/* first quarter of table always has 0 in upper bit, so we can store only DATA_WIDTH-1 bits in the table */",
    "(* ram_style = \"block\" *)  ",
    "reg [DATA_WIDTH-2:0] memory[0:MEMSIZE-1];",
    "       ",
    "/* store input phase value in register */",
    "reg [ADDR_WIDTH-1:0] phase_stage0;",
    "always @(posedge CLK)",
    "    if (RESET)",
    "        phase_stage0 <= 0;",
    "    else if (CE)",
    "        phase_stage0 <= PHASE;",
    " ",
    "wire [1:0] sin_phase_top = phase_stage0[ADDR_WIDTH-1:ADDR_WIDTH-2];",
    "wire [1:0] cos_phase_top = phase_stage0[ADDR_WIDTH-1:ADDR_WIDTH-2] + 1;",
    " ",
    "/* second half of table is the same as first, but negative */",
    "wire sin_need_sign_change = sin_phase_top[1];",
    "/* second and third quarters of table are mirrored by phase */",
    "wire sin_need_phase_inverse = sin_phase_top[0];",
    " ",
    "/* second half of table is the same as first, but negative */",
    "wire cos_need_sign_change = cos_phase_top[1];",
    "/* second and third quarters of table are mirrored by phase */",
    "wire cos_need_phase_inverse = cos_phase_top[0];",
    " ",
    "/* SIN: invert phase to have mirrored value */",
    "wire [ADDR_WIDTH-3:0] sin_table_entry_index = phase_stage0[ADDR_WIDTH-3:0] ^ { (ADDR_WIDTH-2) {sin_need_phase_inverse} };",
    "/* COS: invert phase to have mirrored value */",
    "wire [ADDR_WIDTH-3:0] cos_table_entry_index = phase_stage0[ADDR_WIDTH-3:0] ^ { (ADDR_WIDTH-2) {cos_need_phase_inverse} };",
    " ",
    "/* propagate sign change flag to support negative values */",
    "reg sin_need_sign_change_stage1;",
    "reg cos_need_sign_change_stage1;",
    "reg sin_need_sign_change_stage2;",
    "reg cos_need_sign_change_stage2;",
    " ",
    "always @(posedge CLK)",
    "    if (CE) begin",
    "        sin_need_sign_change_stage1 <= sin_need_sign_change;",
    "        sin_need_sign_change_stage2 <= sin_need_sign_change_stage1;",
    "        cos_need_sign_change_stage1 <= cos_need_sign_change;",
    "        cos_need_sign_change_stage2 <= cos_need_sign_change_stage1;",
    "    end",
    "        ",
    "/* SIN table: block RAM based ROM - first stage of pipeline */",
    "reg [DATA_WIDTH-2:0] sin_rddata_stage1;",
    "always @(posedge CLK)",
    "    if (CE)",
    "        sin_rddata_stage1 <= memory[sin_table_entry_index];",
    " ",
    "/* COS table: block RAM based ROM - first stage of pipeline */",
    "reg [DATA_WIDTH-2:0] cos_rddata_stage1;",
    "always @(posedge CLK)",
    "    if (CE)",
    "        cos_rddata_stage1 <= memory[cos_table_entry_index];",
    " ",
    "/* SIN table: block RAM based ROM - second stage of pipeline */",
    "reg [DATA_WIDTH-2:0] sin_rddata_stage2;",
    "always @(posedge CLK)",
    "    if (CE)",
    "        sin_rddata_stage2 <= sin_rddata_stage1;",
    " ",
    "/* COS table: block RAM based ROM - second stage of pipeline */",
    "reg [DATA_WIDTH-2:0] cos_rddata_stage2;",
    "always @(posedge CLK)",
    "    if (CE)",
    "        cos_rddata_stage2 <= cos_rddata_stage1;",
    " ",
    "/* SIN: this is output stage register, need sign bit as well */",
    "reg [DATA_WIDTH-1:0] sin_rddata_stage3;",
    "always @(posedge CLK)",
    "    if (RESET)",
    "        sin_rddata_stage3 <= 0; ",
    "    else if (CE)",
    "        sin_rddata_stage3 <= sin_need_sign_change_stage2 ? -{1'b0, sin_rddata_stage2} : {1'b0, sin_rddata_stage2}; ",
    " ",
    "/* COS: this is output stage register, need sign bit as well */",
    "reg [DATA_WIDTH-1:0] cos_rddata_stage3;",
    "always @(posedge CLK)",
    "    if (RESET)",
    "        cos_rddata_stage3 <= 0; ",
    "    else if (CE)",
    "        cos_rddata_stage3 <= cos_need_sign_change_stage2 ? -{1'b0, cos_rddata_stage2} : {1'b0, cos_rddata_stage2}; ",
    " ",
    "/* propagate value to output */",
    "assign SIN_VALUE = sin_rddata_stage3;",
    "assign COS_VALUE = cos_rddata_stage3;",
    "",
    "",
    nullptr

};

// generate verilog source code with sin & cos table
bool SinTable::generateSinCosVerilog(const char * filePath) {
    char fileName[4096];
    char moduleName[256];
    sprintf(moduleName, "sin_cos_table_%d_%dbit", tableSize, valueBits);
    sprintf(fileName, "%s%s.v", filePath, moduleName);
    FILE * f = fopen(fileName, "wt");
    if (!f) {
        qDebug("Cannot open file %s for writing", fileName);
        return false;
    }
    fprintf(f, "/*********************************************/\n");
    fprintf(f, "/* SINE table of size %d and %d-bit values */\n", tableSize, valueBits);
    fprintf(f, "/* Latency: 4 CLK cycles                     */\n");
    fprintf(f, "/*********************************************/\n");
    fprintf(f, "module %s #(\n", moduleName);
    fprintf(f, "    parameter DATA_WIDTH = %d,\n", valueBits);
    fprintf(f, "    parameter ADDR_WIDTH = %d\n", tableSizeBits);
    fprintf(f, ")\n");
    fprintf(f, "(\n");
    writeSourceCode(f, STANDARD_PARAMS_VERILOG_CODE);
    writeSourceCode(f, SIN_COS_TABLE_PARAMS_VERILOG_CODE);
    fprintf(f, ");\n");
    writeSourceCode(f, SIN_COS_TABLE_VERILOG_CODE);
    fprintf(f, "\n");
    fprintf(f, "    /* Initialization of ROM content with first quarter of SINE function */\n");
    fprintf(f, "    initial begin\n");
    for (int i = 0; i < tableSize / 4; i++) {
        fprintf(f, "        memory[%d] = %d;\n", i, table[i]);
    }
    fprintf(f, "    end\n");
    fprintf(f, "\n");
    fprintf(f, "endmodule\n");
    fclose(f);
    return true;
}

static const char * SIN_COS_TABLE_TB_PARAMS_VERILOG_CODE[] = {
    "logic [15:0] cycleCounter = 0;",
    "logic CLK;",
    "logic CE;",
    "logic RESET;",
    "logic [ADDR_WIDTH-1:0] PHASE;",
    "wire signed [DATA_WIDTH-1:0] SIN_VALUE;",
    "wire signed [DATA_WIDTH-1:0] COS_VALUE;",
    "",
    nullptr
};

static const char * SIN_COS_TABLE_TB_MAIN_VERILOG_CODE[] = {
    "#(",
    "    .DATA_WIDTH(DATA_WIDTH),",
    "    .ADDR_WIDTH(ADDR_WIDTH)",
    ")",
    "sin_table_instance",
    "(",
    "    .*",
    ");",
    "",
    "// drive CLK",
    "always begin",
    "    #1.472 CLK=0;",
    "    #1.472 CLK=1; ",
    "    cycleCounter = cycleCounter + 1;",
    "end",
    "",
    "task nextCycle(input [ADDR_WIDTH-1:0] phase);",
    "     begin",
    "         @(posedge CLK) #1 ;",
    "         PHASE = phase;",
    "         $display(\"    [%d]   nextCycle PHASE=%d\", cycleCounter, PHASE);",
    "     end",
    "endtask",
    " ",
    "task checkResult(input signed [DATA_WIDTH-1:0] expected_sin_value, input signed [DATA_WIDTH-1:0] expected_cos_value);",
    "     begin",
    "         $display(\"    [%d]             SIN=%d COS=%d\", cycleCounter, SIN_VALUE, COS_VALUE);",
    "         if (SIN_VALUE != expected_sin_value) begin",
    "             $display(\"    [%d] ERROR: SIN_VALUE does not match with expected result, expected %x actual %x\", cycleCounter, expected_sin_value, SIN_VALUE);",
    "             $finish();",
    "         end",
    "         if (COS_VALUE != expected_cos_value) begin",
    "             $display(\"    [%d] ERROR: COS_VALUE does not match with expected result, expected %x actual %x\", cycleCounter, expected_cos_value, COS_VALUE);",
    "             $finish();",
    "         end",
    "     end",
    "endtask",
    " ",
    "// reset condition",
    "initial begin",
    "    RESET = 0;",
    "    CE = 0;",
    "    #200 @(posedge CLK) RESET = 1;",
    "    #100 @(posedge CLK) RESET = 0;",
    "    @(posedge CLK) #1 CE = 1;",
    "    PHASE = 0;",
    " ",
    "    $display(\"Starting verification\");",
    "",
    nullptr
};


// generate verilog source code with verificatoin of sin & cos table
bool SinTable::generateSinCosVerilogTestBench(const char * filePath) {
    char fileName[4096];
    char moduleName[256];
    sprintf(moduleName, "sin_cos_table_%d_%dbit", tableSize, valueBits);
    sprintf(fileName, "%s%s_tb.sv", filePath, moduleName);
    FILE * f = fopen(fileName, "wt");
    if (!f) {
        qDebug("Cannot open file %s for writing", fileName);
        return false;
    }
    fprintf(f, "/*********************************************/\n");
    fprintf(f, "/* SINE table of size %d and %d-bit values */\n", tableSize, valueBits);
    fprintf(f, "/* Latency: 4 CLK cycles                     */\n");
    fprintf(f, "/* TESTBENCH                                 */\n");
    fprintf(f, "/*********************************************/\n");
    fprintf(f, "`timescale 1ns / 1ps\n");
    fprintf(f, "module %s_tb ();\n", moduleName);
    fprintf(f, "\n");
    fprintf(f, "localparam     DATA_WIDTH = %d;\n", valueBits);
    fprintf(f, "localparam     ADDR_WIDTH = %d;\n", tableSizeBits);
    fprintf(f, "\n");
    fprintf(f, "\n");
    writeSourceCode(f, SIN_COS_TABLE_TB_PARAMS_VERILOG_CODE);
    fprintf(f, "    %s\n", moduleName);
    writeSourceCode(f, SIN_COS_TABLE_TB_MAIN_VERILOG_CODE);
    fprintf(f, "\n");
    fprintf(f, "        /* Outputs are delayed by 4 clock cycles */\n");
    for (int i = 0; i < tableSize + 8; i++) {
        int phase = i % tableSize;
        int resultPhase = (tableSize + i - 4) % tableSize;
        int resultCosPhase = (tableSize/4 + i - 4) % tableSize;
        int expectedResult = table[resultPhase];
        int expectedCosResult = table[resultCosPhase];
        if (i < 4)
            fprintf(f, "        nextCycle(%d);\n", phase);
        else
            fprintf(f, "        nextCycle(%d); checkResult(%d, %d);\n", phase, expectedResult, expectedCosResult);
    }

    writeSourceCode(f, SIN_TABLE_TB_END_VERILOG_CODE);
    fclose(f);
    return true;
}

// initial value for scaling unity length vector for CORDIC
#define CORDIC_SIN_COS_K 0.60725293500888111176

// t[n] = atan(2^(-n)) converted to 32-bit phase angle
static const int32_t CORDIC_ATAN_TABLE_INT32[30] = {
    0x20000000, // [0] 0.785398163397448
    0x12e4051d, // [1] 0.463647609000806
    0x09fb385b, // [2] 0.244978663126864
    0x051111d4, // [3] 0.124354994546761
    0x028b0d43, // [4] 0.062418809995957
    0x0145d7e1, // [5] 0.031239833430268
    0x00a2f61e, // [6] 0.015623728620477
    0x00517c55, // [7] 0.007812341060101
    0x0028be53, // [8] 0.003906230131967
    0x00145f2e, // [9] 0.001953122516479
    0x000a2f98, // [10] 0.000976562189559
    0x000517cc, // [11] 0.000488281211195
    0x00028be6, // [12] 0.000244140620149
    0x000145f3, // [13] 0.000122070311894
    0x0000a2f9, // [14] 0.000061035156174
    0x0000517c, // [15] 0.000030517578116
    0x000028be, // [16] 0.000015258789061
    0x0000145f, // [17] 0.000007629394531
    0x00000a2f, // [18] 0.000003814697266
    0x00000517, // [19] 0.000001907348633
    0x0000028b, // [20] 0.000000953674316
    0x00000145, // [21] 0.000000476837158
    0x000000a2, // [22] 0.000000238418579
    0x00000051, // [23] 0.000000119209290
    0x00000028, // [24] 0.000000059604645
    0x00000014, // [25] 0.000000029802322
    0x0000000a, // [26] 0.000000014901161
    0x00000005, // [27] 0.000000007450581
    0x00000002, // [28] 0.000000003725290
    0x00000001, // [29] 0.000000001862645
};

//
// init table for x,y for CORDIC SIN & COS
// 0..PI/2 range is divided into 128 pieces
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
    0x00078c54, // [474] 0.005237106283641 (00369fff)  3579903=-2670163-1335086+667544-333772+166886-83443+41721-20860-10430-5215+2607+1303-651-325-162+81+40+20+10-5-2-1(+ 0)
    0x001ab394, // [475] 0.005261074733452 (0036e000)  3596288=-2670163-1335086+667544-333772+166886-83443-41721+20860+10430+5215-2607-1303+651+325-162+81-40+20-10+5+2-1(+ -1)
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
