fpga-theremin/sensors/(commit log)

2023-07-25 theremin AFE drive buffer with current sensing and LVDS outputs - LTSpice model
2023-07-31 current sensing oscillator - simple bjt OTA
2023-07-31 add ltspice simulation of OTA current sensing oscillator with automatic gain control
2023-08-03 current sensing oscillator
2023-08-08 current sensing oscillator model, v10
2023-12-04 FPGA sensor module readme
2023-12-06 fpga sensor simulator Qt app
2023-12-06 sensor sim app improvements
2023-12-19 sensor simulator improved
2023-12-20 simulator update; spreadsheet with some simulation results
    [sensor_parameters_simulation_100MHz_12bit.xlsx]
2024-01-03 sallen key shielded sensor model
2024-01-03 update FPGA sensor readme
2024-01-04 update simulator - add ADC interpolation; update readmes
2024-01-04 update readmes, 12bit 40MHz ADC selected
2024-01-05 fix error in verilog code
    [adc_dac_frontend.v]
2024-01-06 fpga verilog - fix lp filter
    [adc_dac_frontend.v, lp_filter_stage.v, lp_filter_stage_tb.sv, lp_filter_tb.sv]
2024-01-06 lp filters
2024-01-06 op filters fixed
2024-01-06 verilog: fix quadrature mul_and_accumulate module, add testbench
    [adc_dac_frontend.v, quadrature_mul_acc.v, quadrature_mul_acc_tb.sv]
2024-01-07 improve LP filter
2024-01-08 lp filter improvements: support out_data_bits > in_data_bits
2024-01-08 FPGA firmware: add signed LP filter:
2024-01-08 fixes of filter parameters
    [adc_dac_frontend.v, adc_dac_frontend_tb.sv]
2024-01-08 filter parameter fixes
2024-01-08 firmware fixes: mem init file, lp filter fixes
    [adc_dac_frontend.v, adc_dac_frontend_tb.sv, dds.cpp, dsputils.cpp, dsputils.h, lp_filter.v, lp_filter_signed.v, lp_filter_signed_tb.sv]
2024-01-09 FPGA firmware - advanced low resources filters
2024-01-10 fpga hdl - filter control
2024-01-10 verilog: filter for quadrature mul acc
2024-01-13 sensor PLL diagram
2024-01-13 simulator: simulation batch in separate thread
2024-01-13 simulator - sim suite fixes
    [dsputils.h, main.cpp, plotwidget.cpp, simutils.cpp, simutils.h]
2024-01-15 simulator: stats plot fixes
    [plotwidget.cpp, simbatchdialog.cpp, simresultplot.cpp, simutils.cpp]
2024-01-16 simulator: add LP filter
2024-01-16 simulator: filters on/off
2024-01-22 phase detection research - excel simulation, circle center position calculation added
    [quadrature_phase_detector.xlsx]
2024-01-23 phase shift calculation alternative method - how it's affected by DC offset in ADC signal
    [quadrature_phase_detector.xlsx]
2024-01-31 simulator - new phase shift detector - 4points
    [quadrature_phase_detector.xlsx]
2024-02-01 simulator - new filtering
2024-02-08 fixes in CORDIC sin cos verilog impl
    [cordic_sin_cos.v, cordic_sin_cos_tb.sv, fixed_delay_shift_register.v]
2024-08-01 current sensor oscillator LTSpice model:
2024-08-06 fix schematic of sensor
2024-08-06 current sensing buffer
2024-08-09 gain control for current sensing buffer - ltspice model
2024-11-29 D-lev AFE with current sensing - spice model
2024-12-02 add simplified schematic, w/o LP filter buffer
2024-12-03 D-Lev AFE model with integrating current sensor
2025-03-28 theremin sensor oscillator with PLL - LTSpice model
2025-04-01 current sensing oscillator model
2025-04-02 simple current sensing DLev AFE
2025-04-02 current sensing dlev afe v2
2025-07-19 simple current sensing oscillator model : current mirrors + unbuffered inverters
2025-09-23 planar PCB spiral transformer generator
2025-09-23 transformer footprint generator
2025-09-23 sample footprint
2026-01-09 Theremin Sensor - PLL on LM13700
2026-03-23 PCB Transformer generator, 1:2
    [InductorTest.kicad_pcb, InductorTest.kicad_sch]
2026-03-31 add rp2350 sensor kicad project, initial version
    [RP2350_DDS_curr_sensing_sensor.kicad_pcb, RP2350_DDS_curr_sensing_sensor.kicad_sch, sensor_afe.kicad_sch]
